rayshobby/opensprinkler/OpenSprinkler Pi/docs/v1.0/pics/pic_screw1.JPG

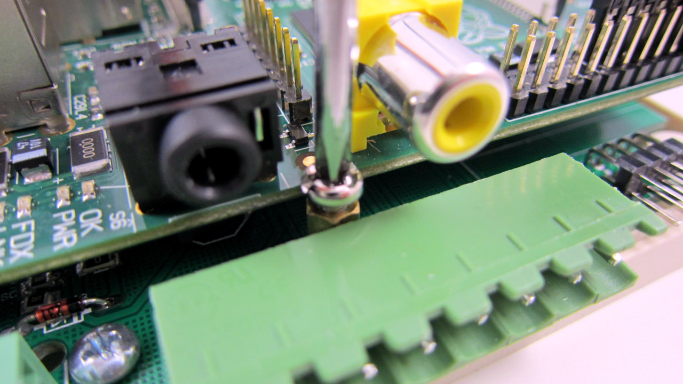
OpenSprinkler Pi/docs/v1.0/pics/pic_screw1.JPG
