rayshobby/opensprinkler/OpenSprinkler Pi/docs/v1.0/pics/pic_screw2.JPG

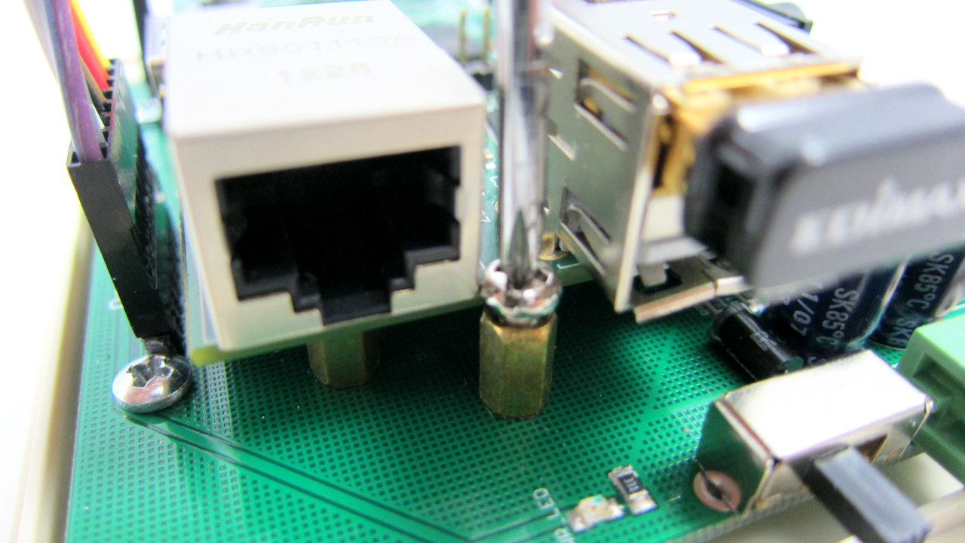
OpenSprinkler Pi/docs/v1.0/pics/pic_screw2.JPG
