rayshobby/opensprinkler/OpenSprinkler Pi/docs/v1.0/diagram_connection.pdf

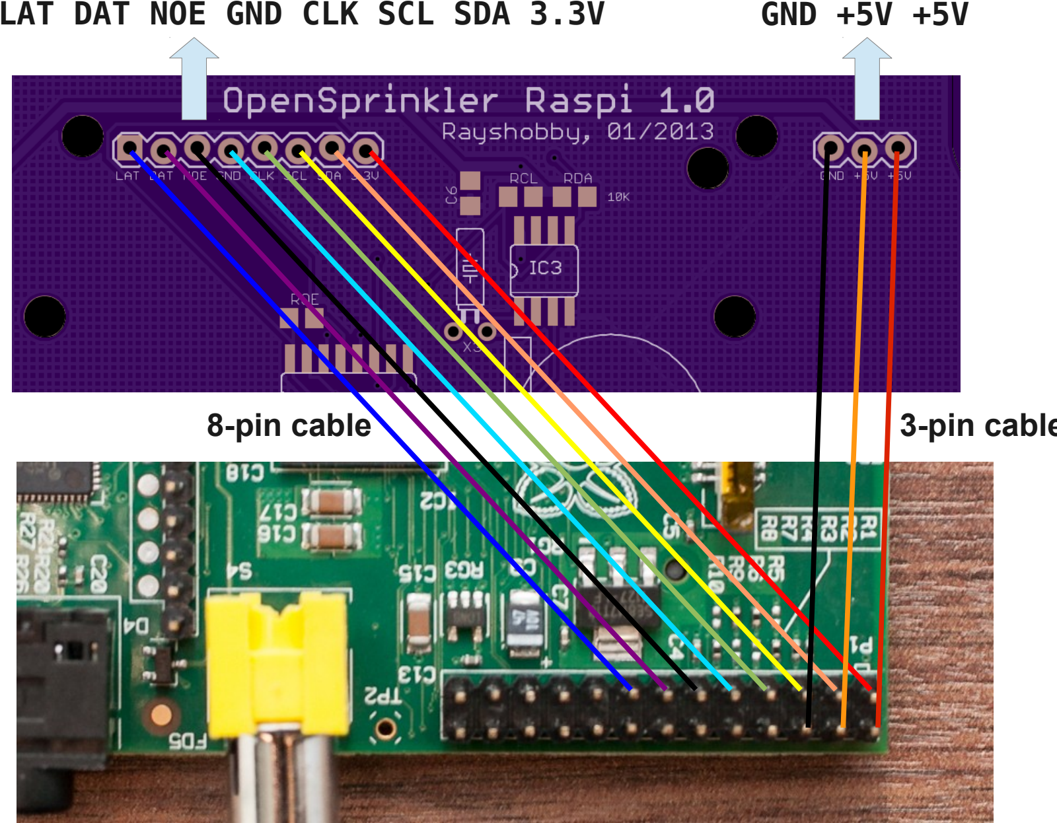
[picture p3: page 1]

LAT DAT NOE GND CLK SCL SDA 3.3V | GND +5V +5V
8-pin cable | 3-pin cable
