rayshobby/opensprinkler/OpenSprinkler Pi/docs/v1.0/diagram_interface.pdf

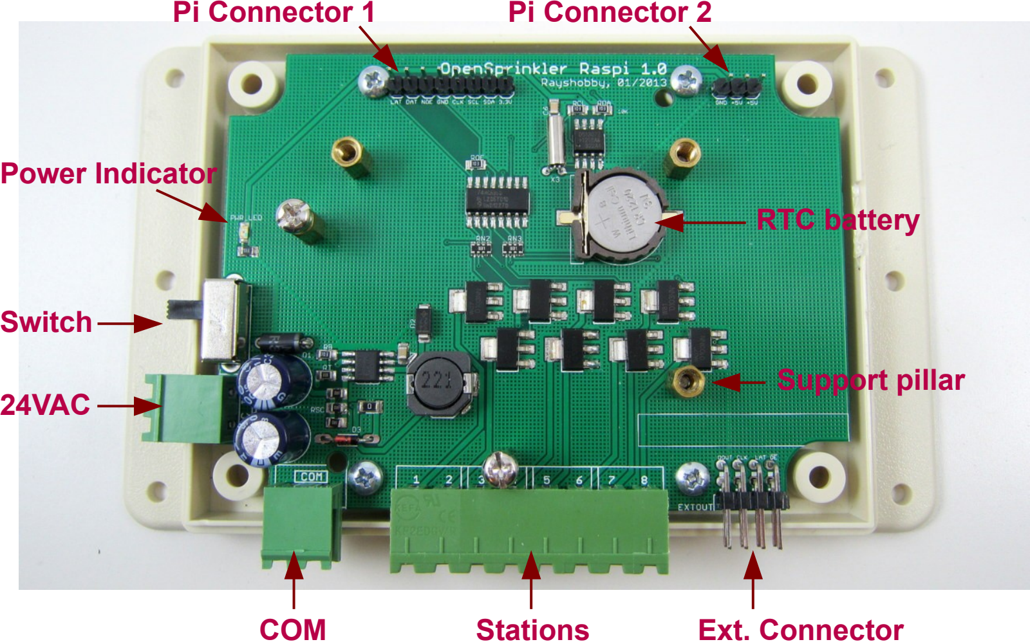
[picture p4: page 1]

24VAC

Switch

Power Indicator
RTC battery
COM | Stations | Ext. Connector
Pi Connector 1 | Pi Connector 2

Support pillar
