rayshobby/opensprinkler/OpenSprinkler Controller/hardware/v1.4/smt/Note.txt

Requires Eagle 6.0 or above to open attached .sch and .brd files.
