rayshobby/opensprinkler/Expansion Board/exp20.png

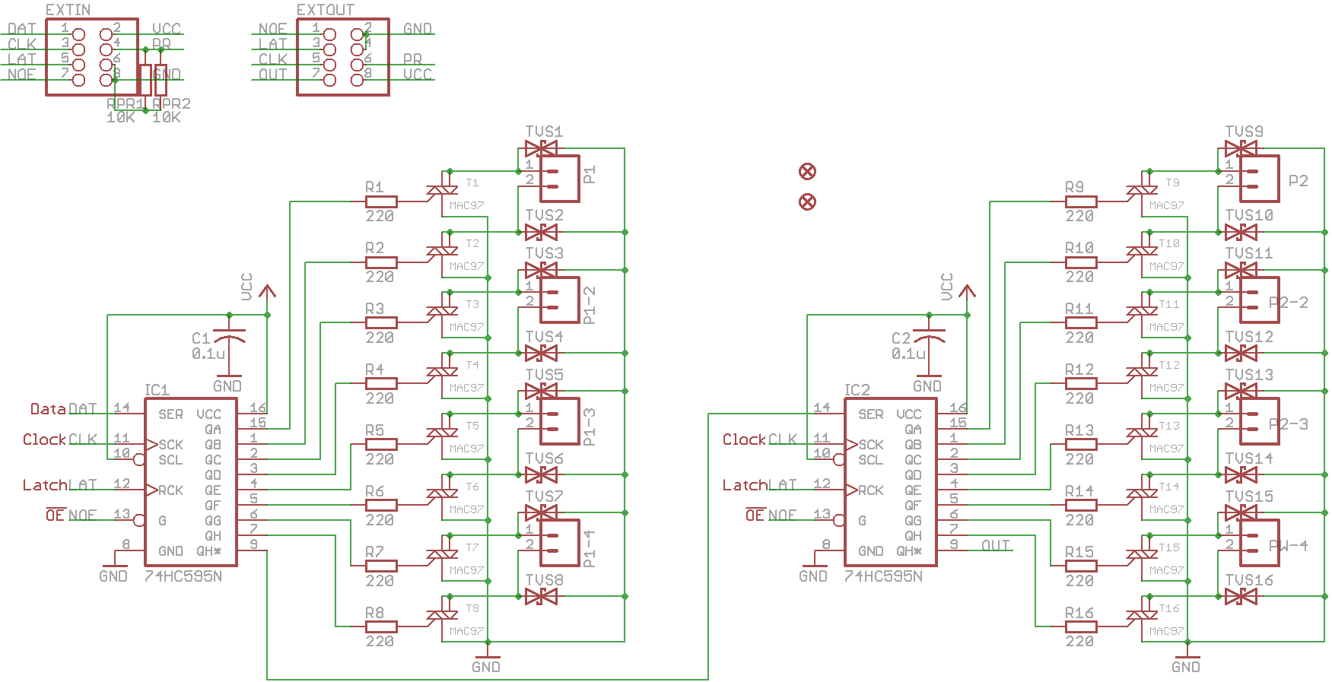
Expansion Board/exp20.png
