rayshobby/opensprinkler/OpenSprinkler Controller/hardware/v2.3/AC/os23ac_sch.png

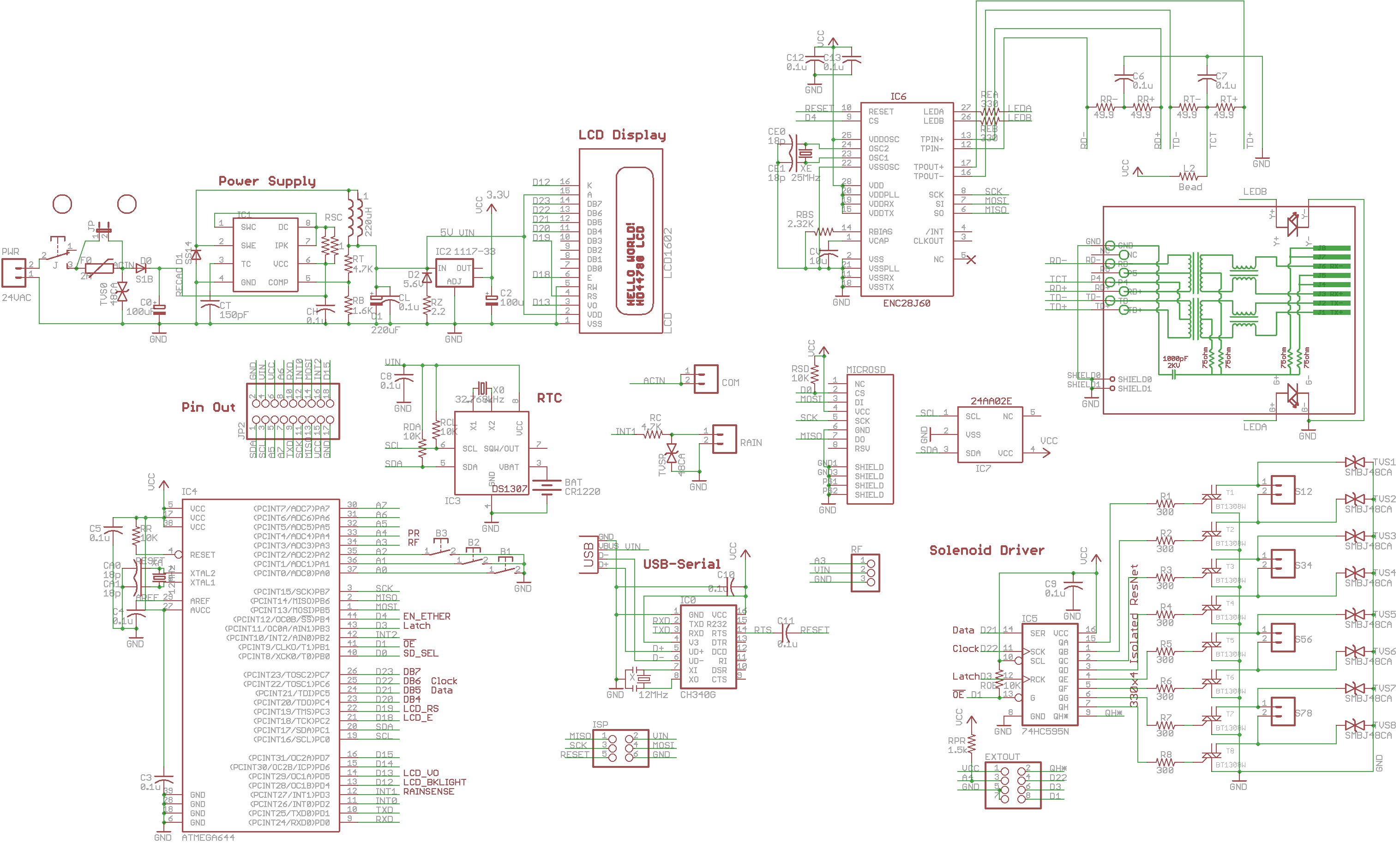
OpenSprinkler Controller/hardware/v2.3/AC/os23ac_sch.png
