rayshobby/opensprinkler/OpenSprinkler Controller/hardware/v2.3/DC/os23dc_sch.png

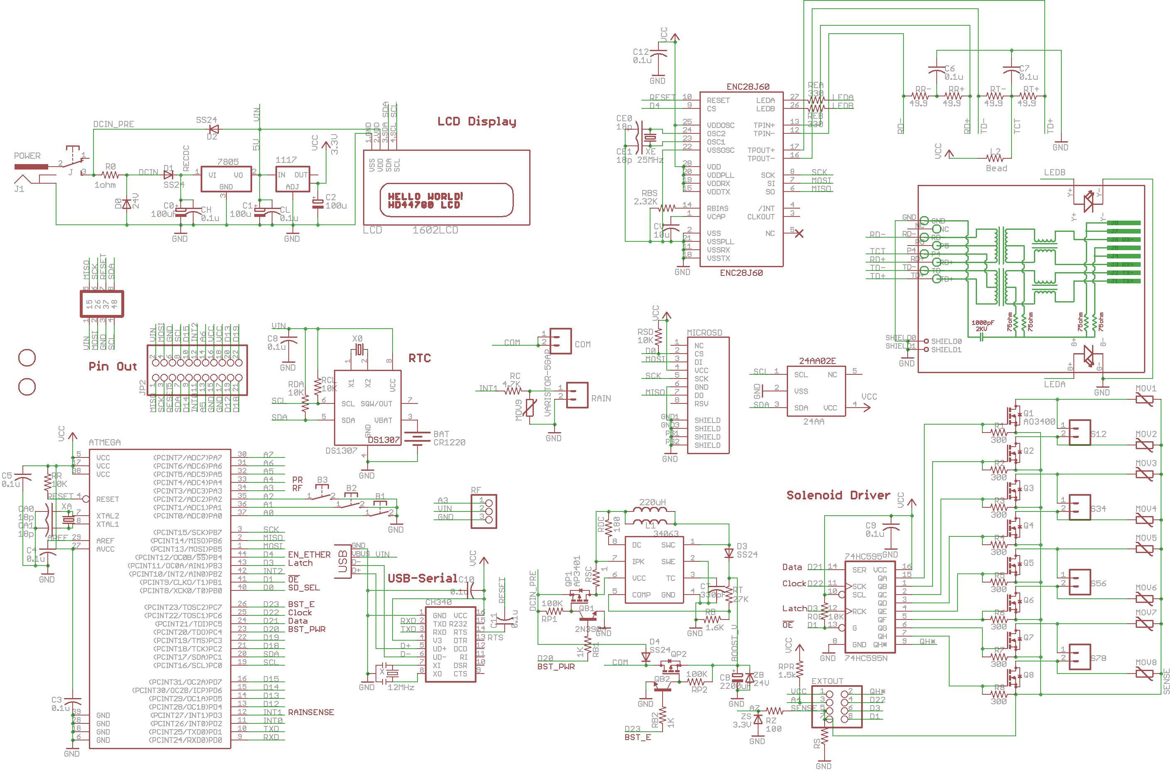
OpenSprinkler Controller/hardware/v2.3/DC/os23dc_sch.png
