rayshobby/opensprinkler/OpenSprinkler Pi/docs/v1.0/diagram_expansion_board.jpg

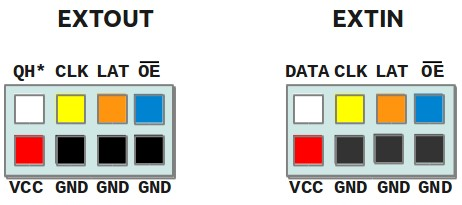
OpenSprinkler Pi/docs/v1.0/diagram_expansion_board.jpg
