rayshobby/opensprinkler/OpenSprinkler Pi/docs/v1.0/pics/pic_enclosure.JPG

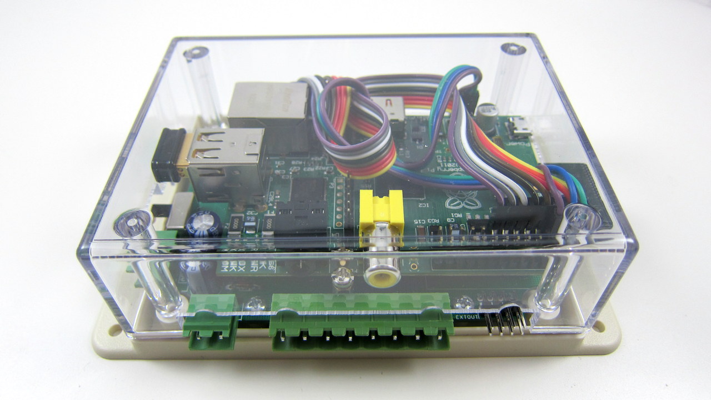
OpenSprinkler Pi/docs/v1.0/pics/pic_enclosure.JPG
