rayshobby/opensprinkler/OpenSprinkler Pi/docs/v1.0/pics/pic_extconn.JPG

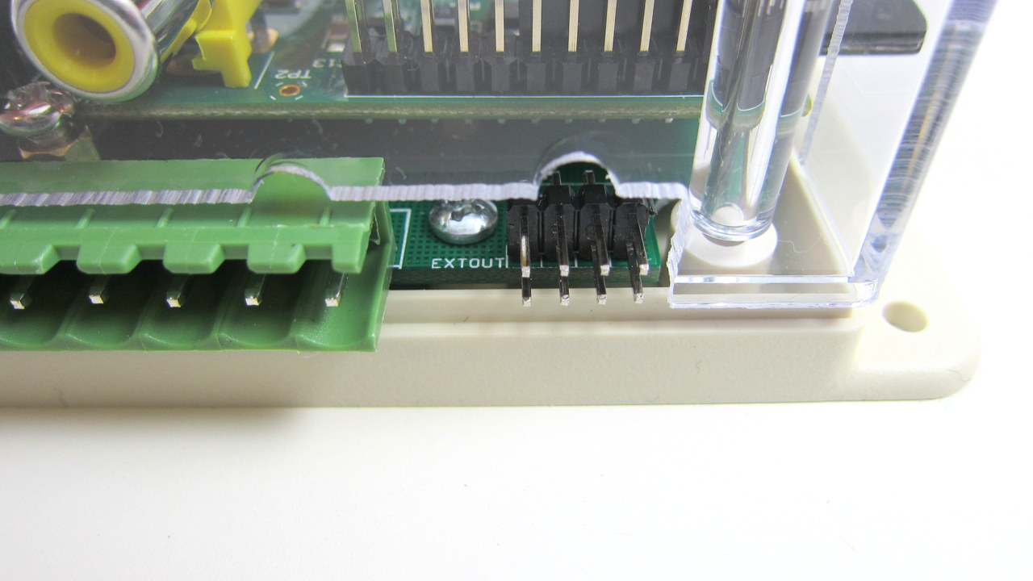
OpenSprinkler Pi/docs/v1.0/pics/pic_extconn.JPG
