rayshobby/opensprinkler/OpenSprinkler Pi/docs/v1.0/pics/pic_sdcard.JPG

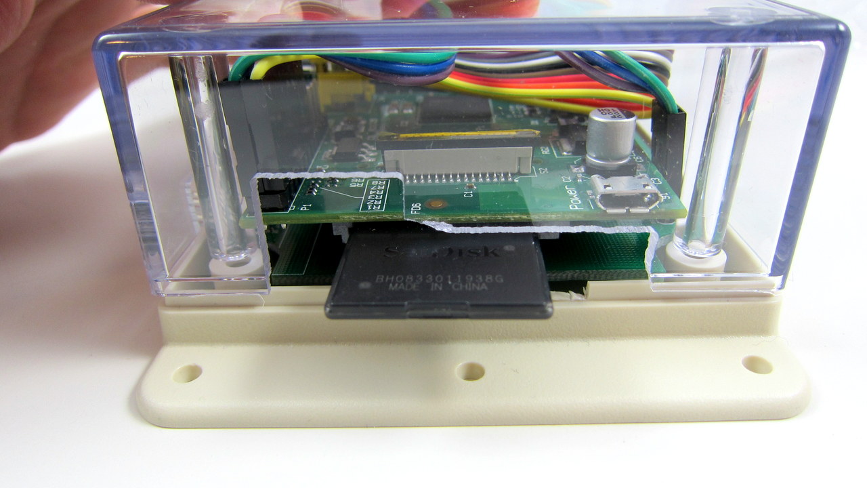
OpenSprinkler Pi/docs/v1.0/pics/pic_sdcard.JPG
