rayshobby/opensprinkler/OpenSprinkler Pi/docs/v1.0/pics/pic_solenoidwires.JPG

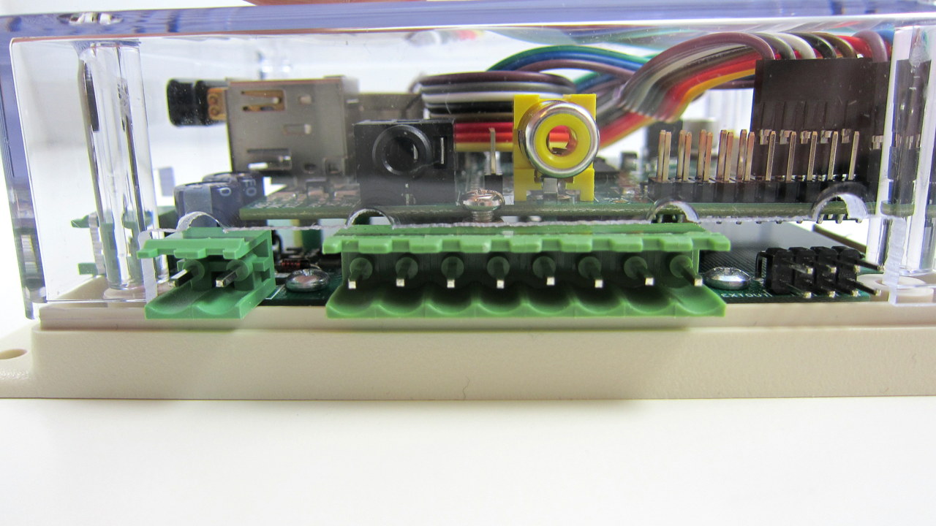
OpenSprinkler Pi/docs/v1.0/pics/pic_solenoidwires.JPG
