rayshobby/opensprinkler/OpenSprinkler Pi/docs/v1.0/pics/pic_supportpillar.JPG

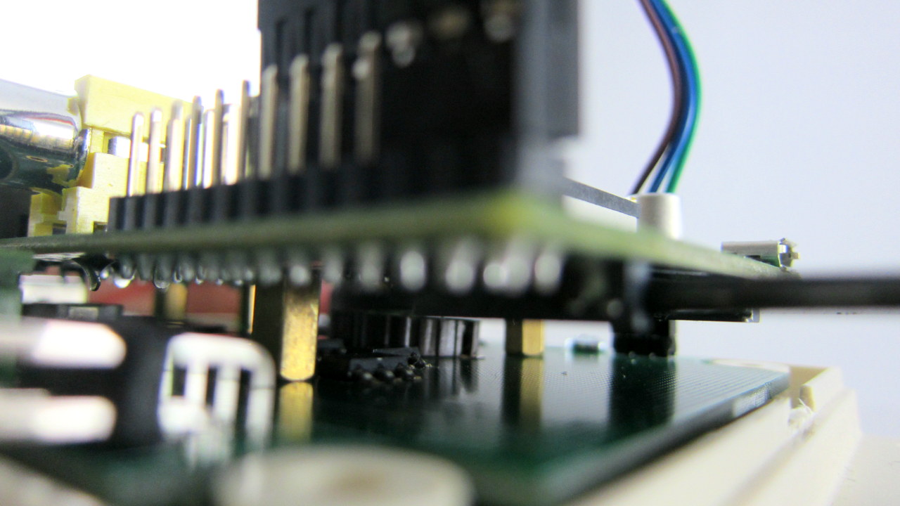
OpenSprinkler Pi/docs/v1.0/pics/pic_supportpillar.JPG
