rayshobby/opensprinkler/OpenSprinkler Pi/docs/v1.0/pics/pic_switch.JPG

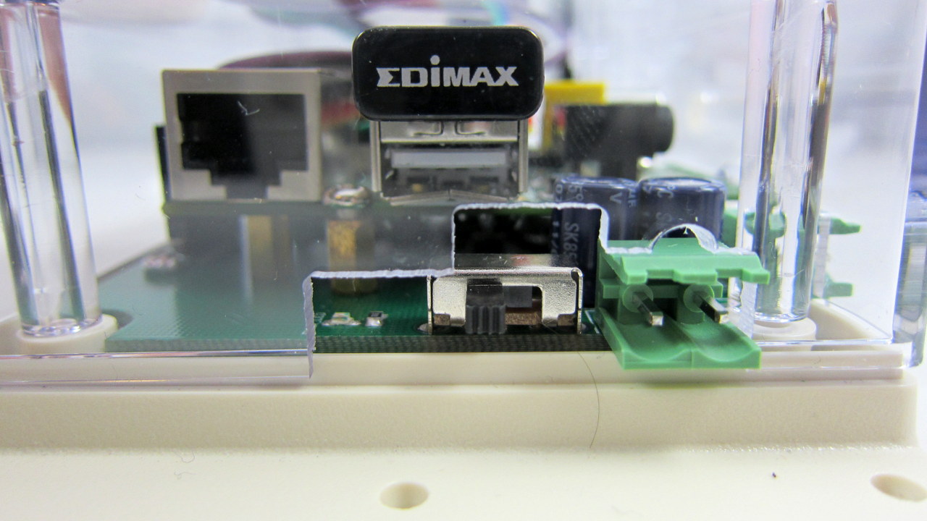
OpenSprinkler Pi/docs/v1.0/pics/pic_switch.JPG
