rayshobby/opensprinkler/OpenSprinkler Pi/docs/v1.0/pics/pic_viewback.JPG

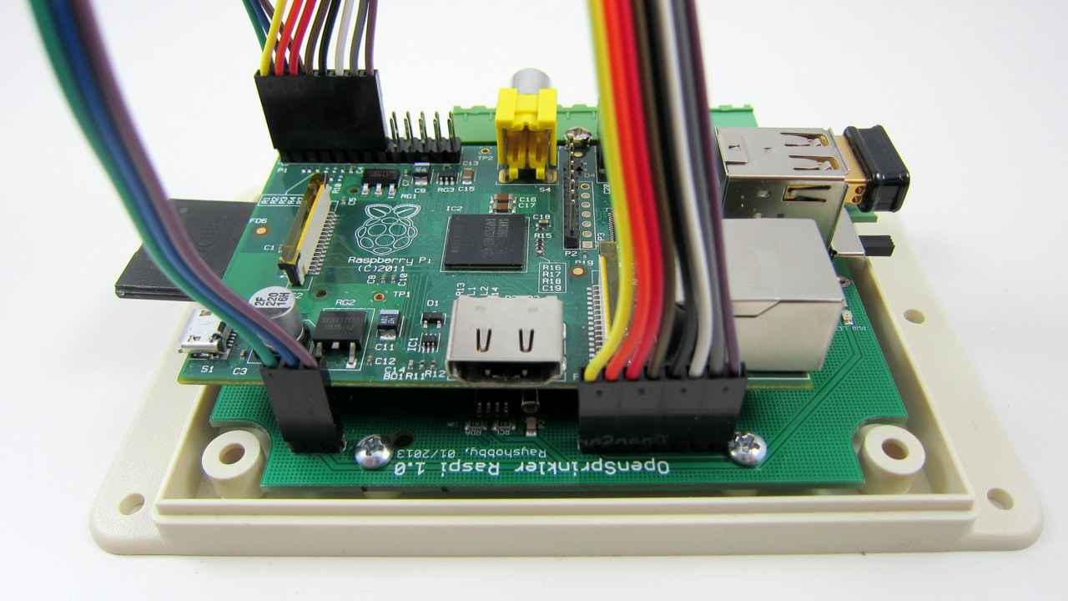
OpenSprinkler Pi/docs/v1.0/pics/pic_viewback.JPG
