rayshobby/opensprinkler/OpenSprinkler Pi/docs/v1.0/pics/pic_viewfront.JPG

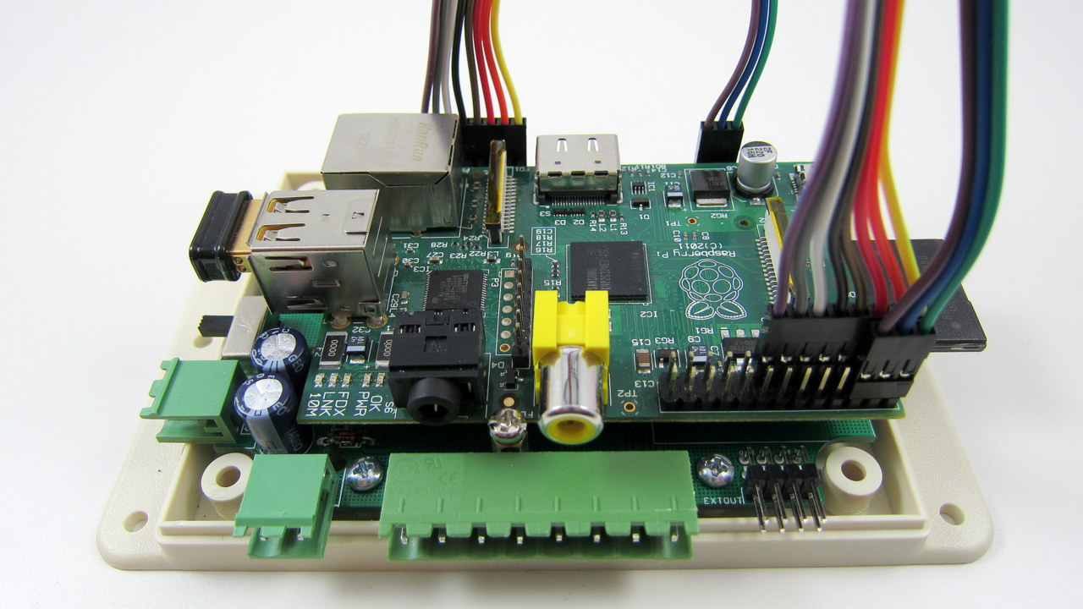
OpenSprinkler Pi/docs/v1.0/pics/pic_viewfront.JPG
