rayshobby/opensprinkler/OpenSprinkler Pi/docs/v1.0/pics/pic_wifidongle.JPG

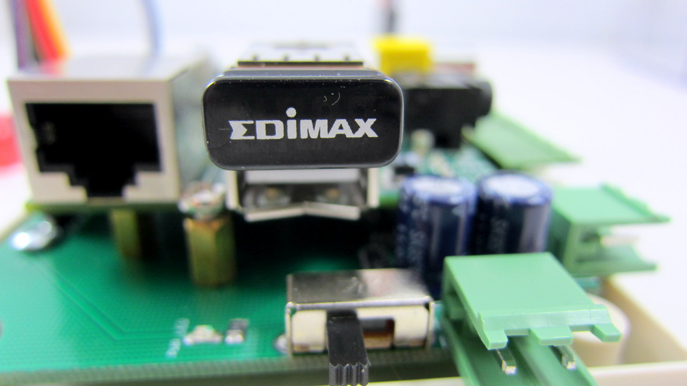
OpenSprinkler Pi/docs/v1.0/pics/pic_wifidongle.JPG
