rayshobby/opensprinkler/OpenSprinkler Pi/hardware/ospi_v10_sch.png

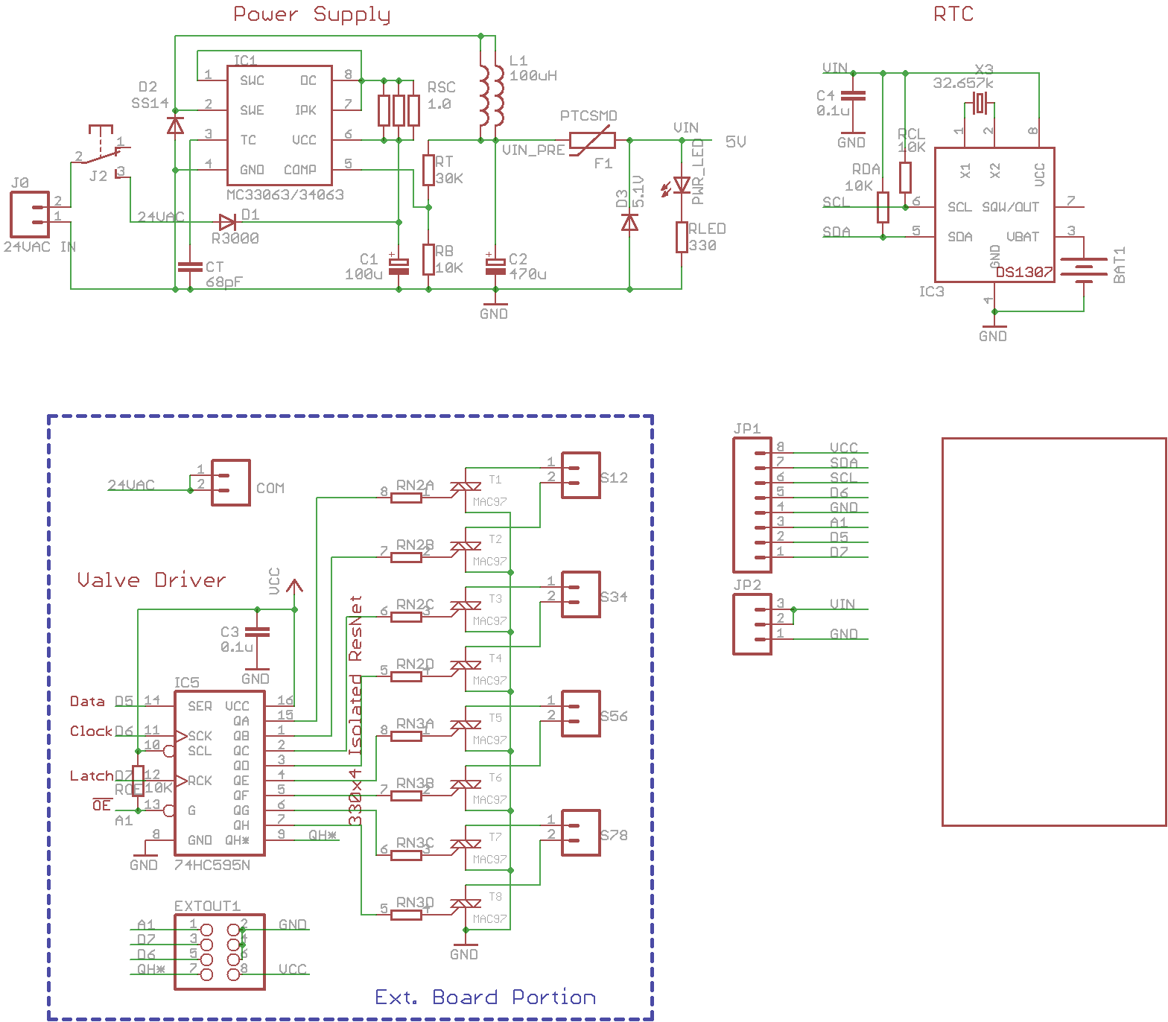
OpenSprinkler Pi/hardware/ospi_v10_sch.png
