rayshobby/opensprinkler/OpenSprinkler Pi/hardware/ospi_v11_sch.png

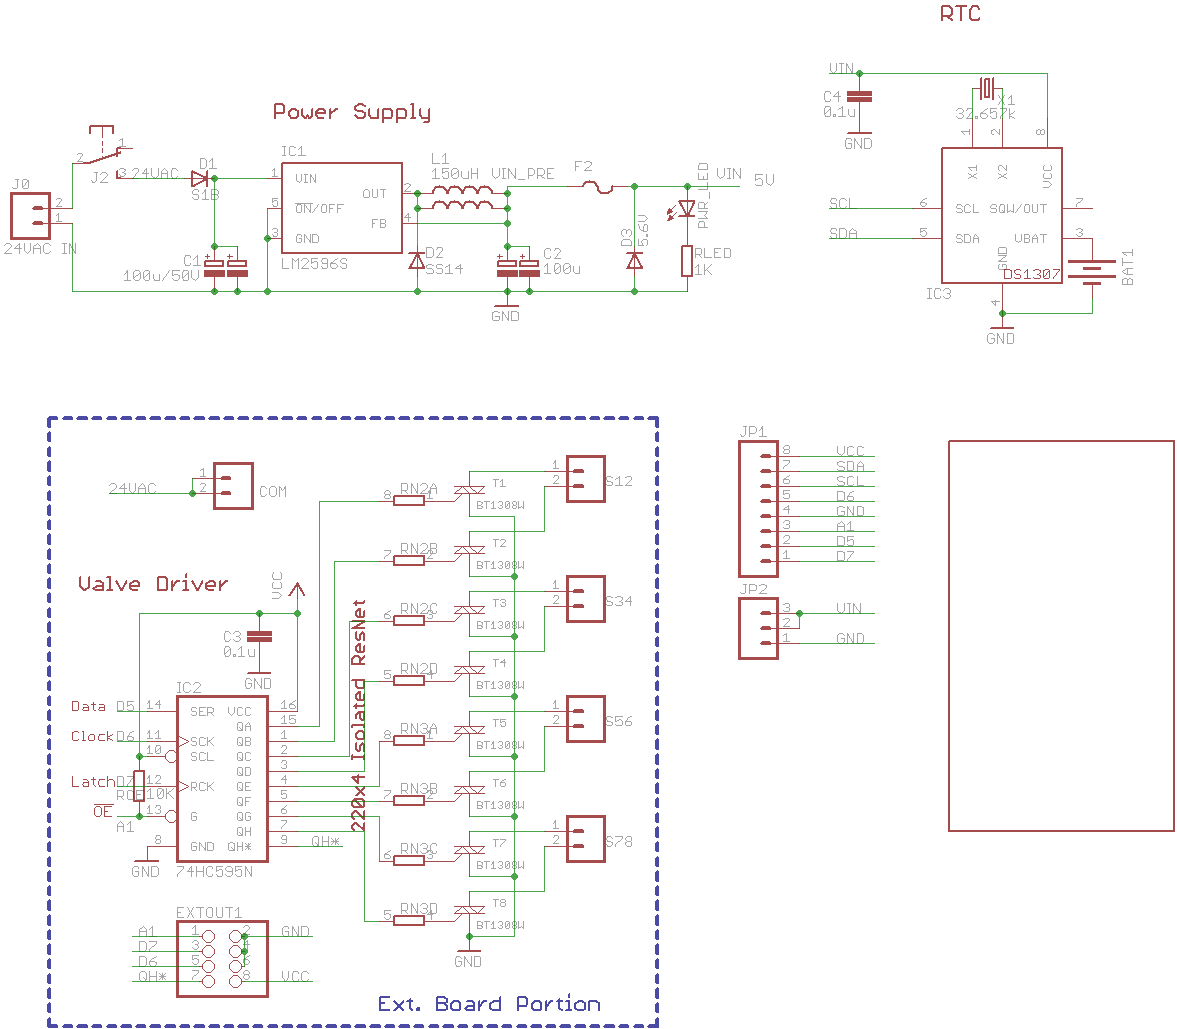
OpenSprinkler Pi/hardware/ospi_v11_sch.png
