rayshobby/opensprinkler/OpenSprinkler Pi/hardware/ospi_v12_sch.png

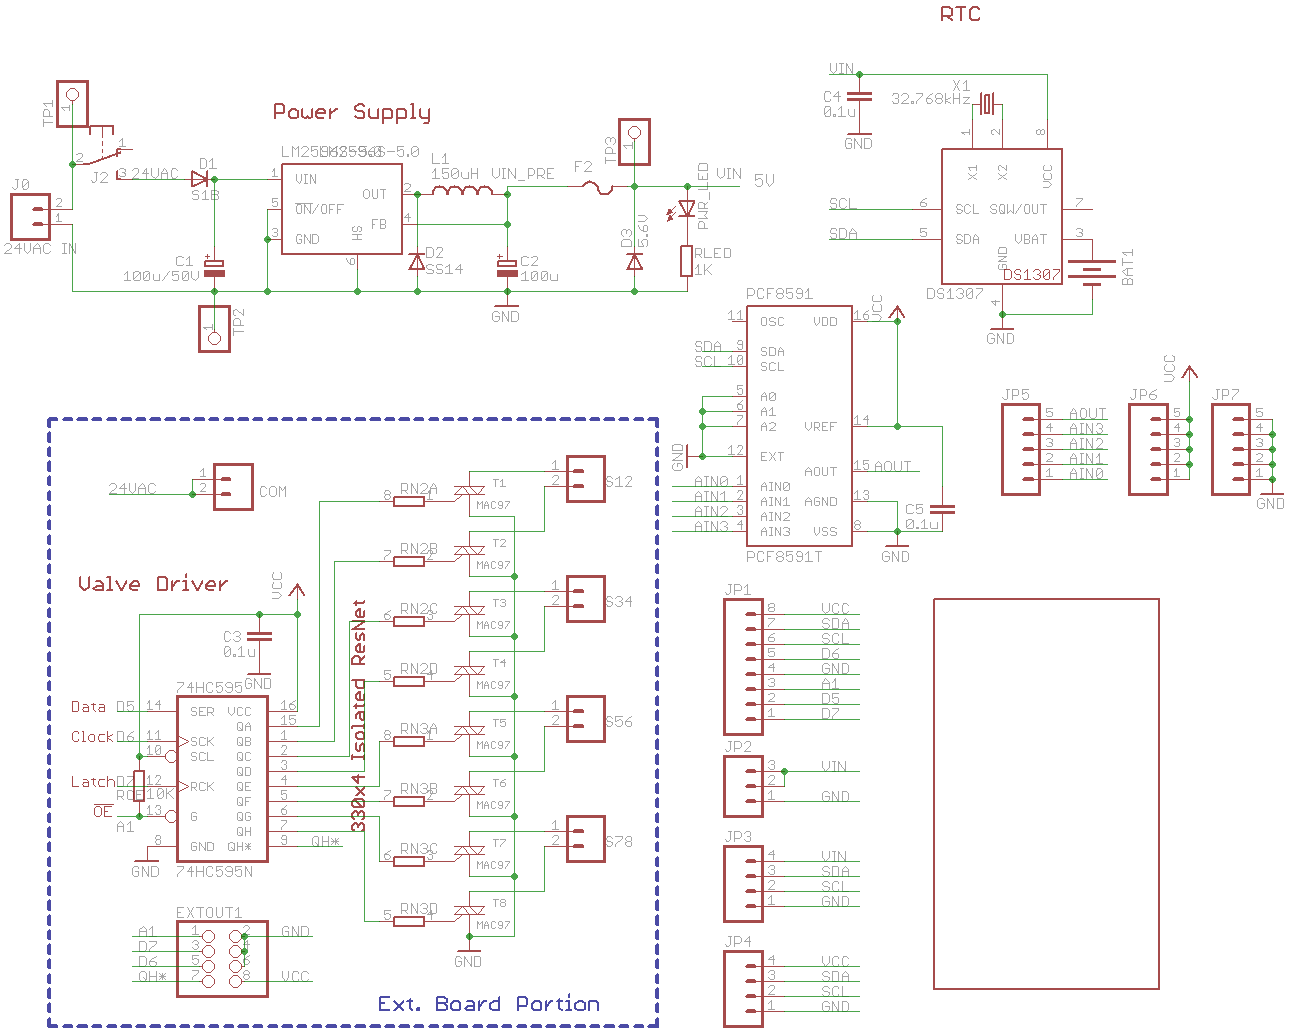
OpenSprinkler Pi/hardware/ospi_v12_sch.png
