rayshobby/opensprinkler/OpenSprinkler Pi/hardware/ospi_v13_sch.png

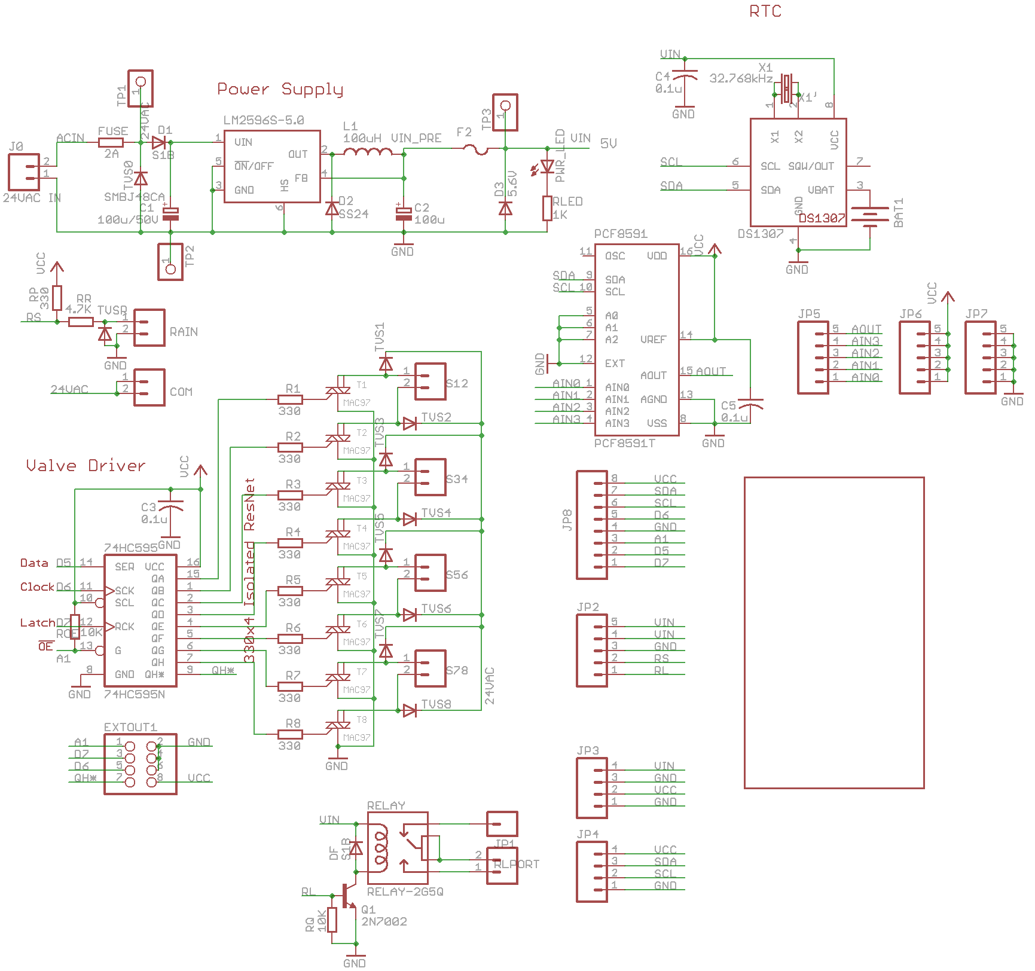
OpenSprinkler Pi/hardware/ospi_v13_sch.png
