rayshobby/opensprinkler/OpenSprinkler Pi/hardware/ospi_v14+_sch.png

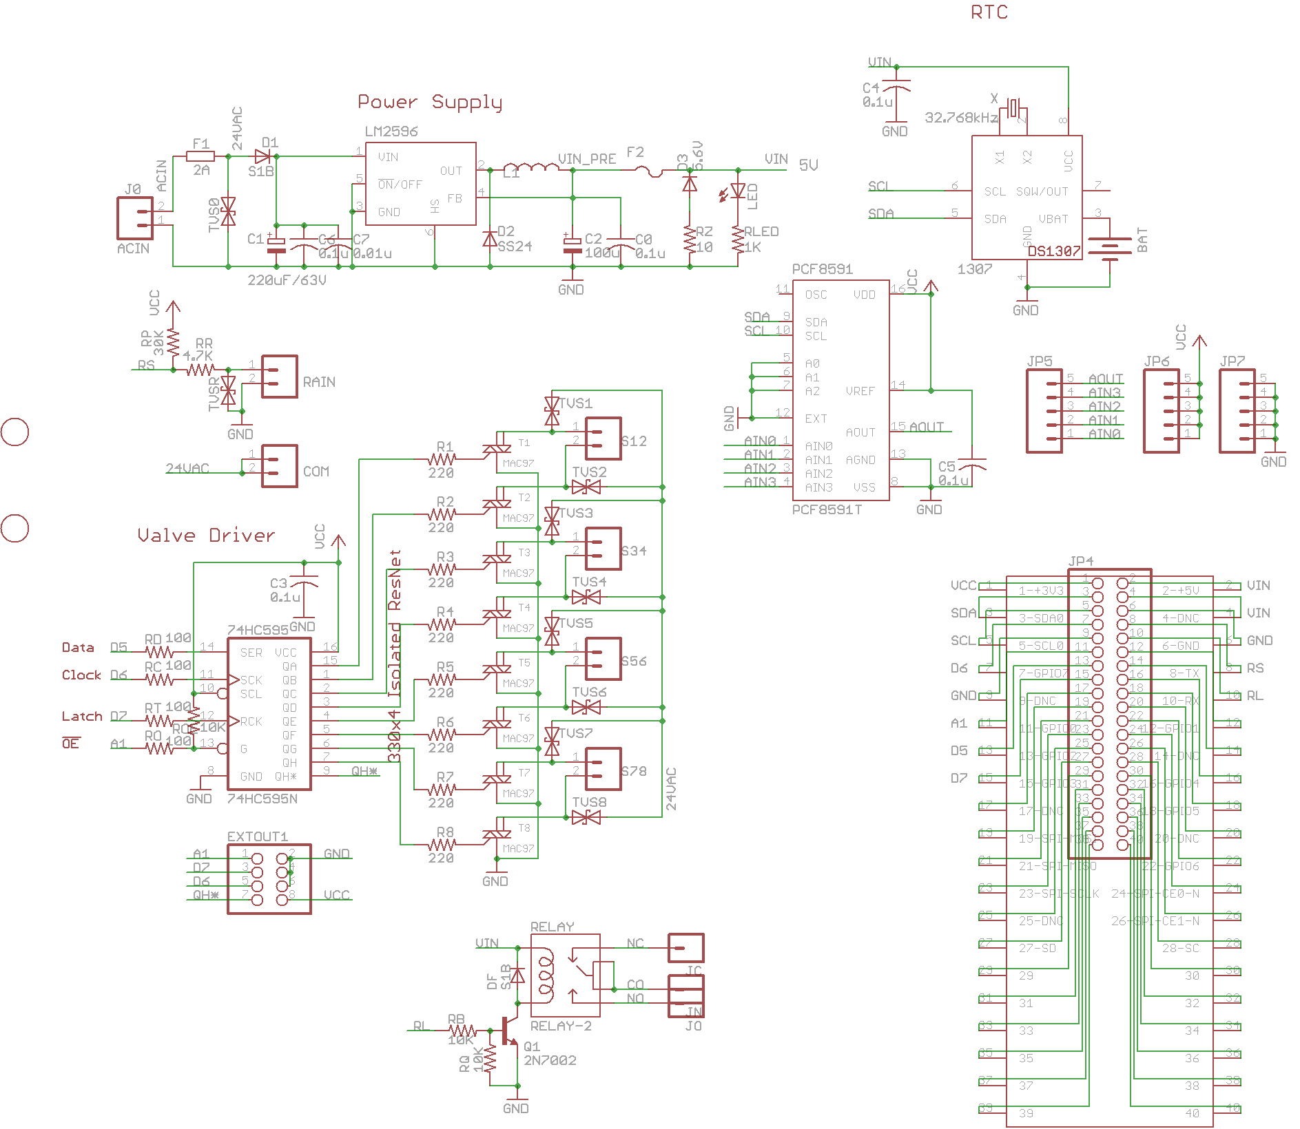
OpenSprinkler Pi/hardware/ospi_v14+_sch.png
