rayshobby/opensprinkler/OpenSprinkler Pi/hardware/ospi_v14_sch.png

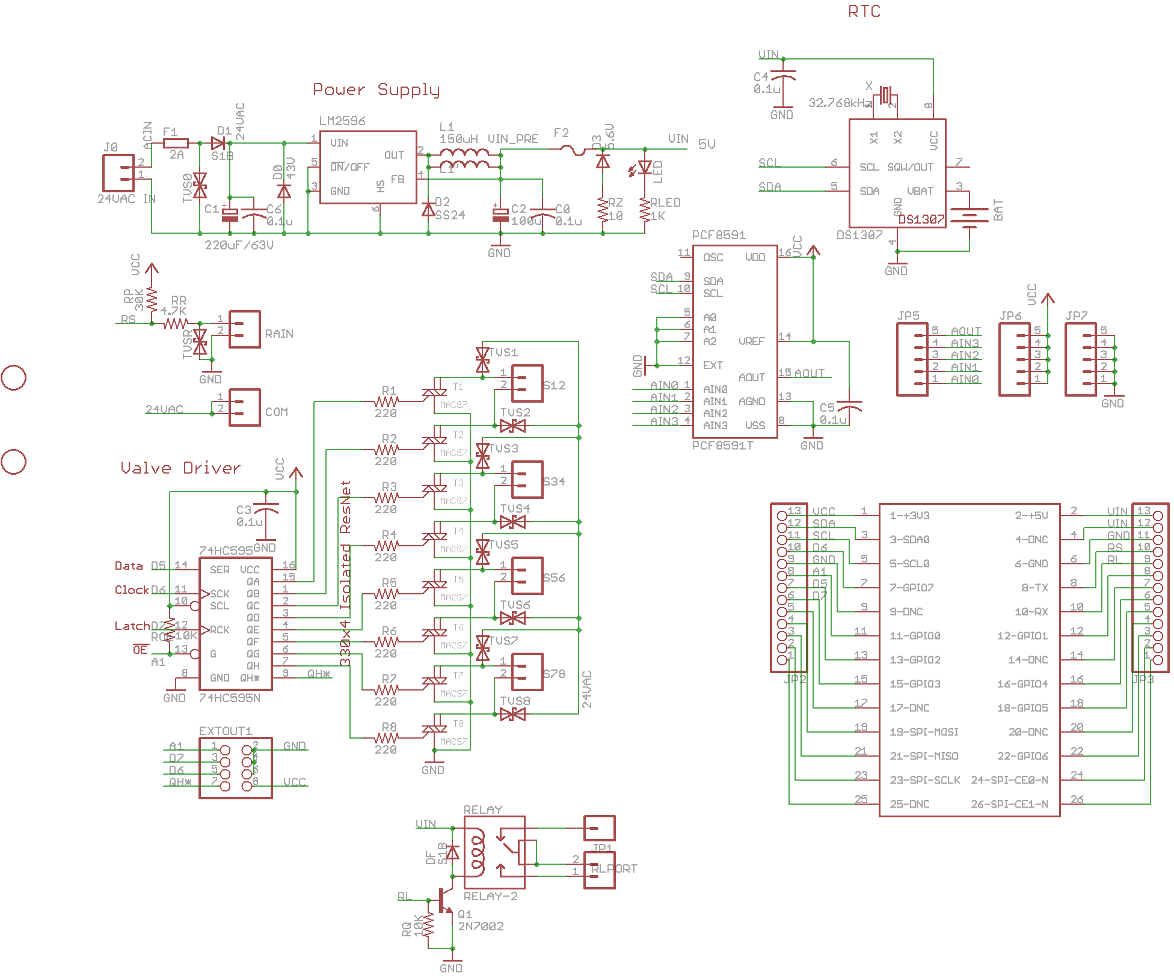
OpenSprinkler Pi/hardware/ospi_v14_sch.png
