rayshobby/opensprinkler/OpenSprinkler Pi/hardware/ospi_v142+.png

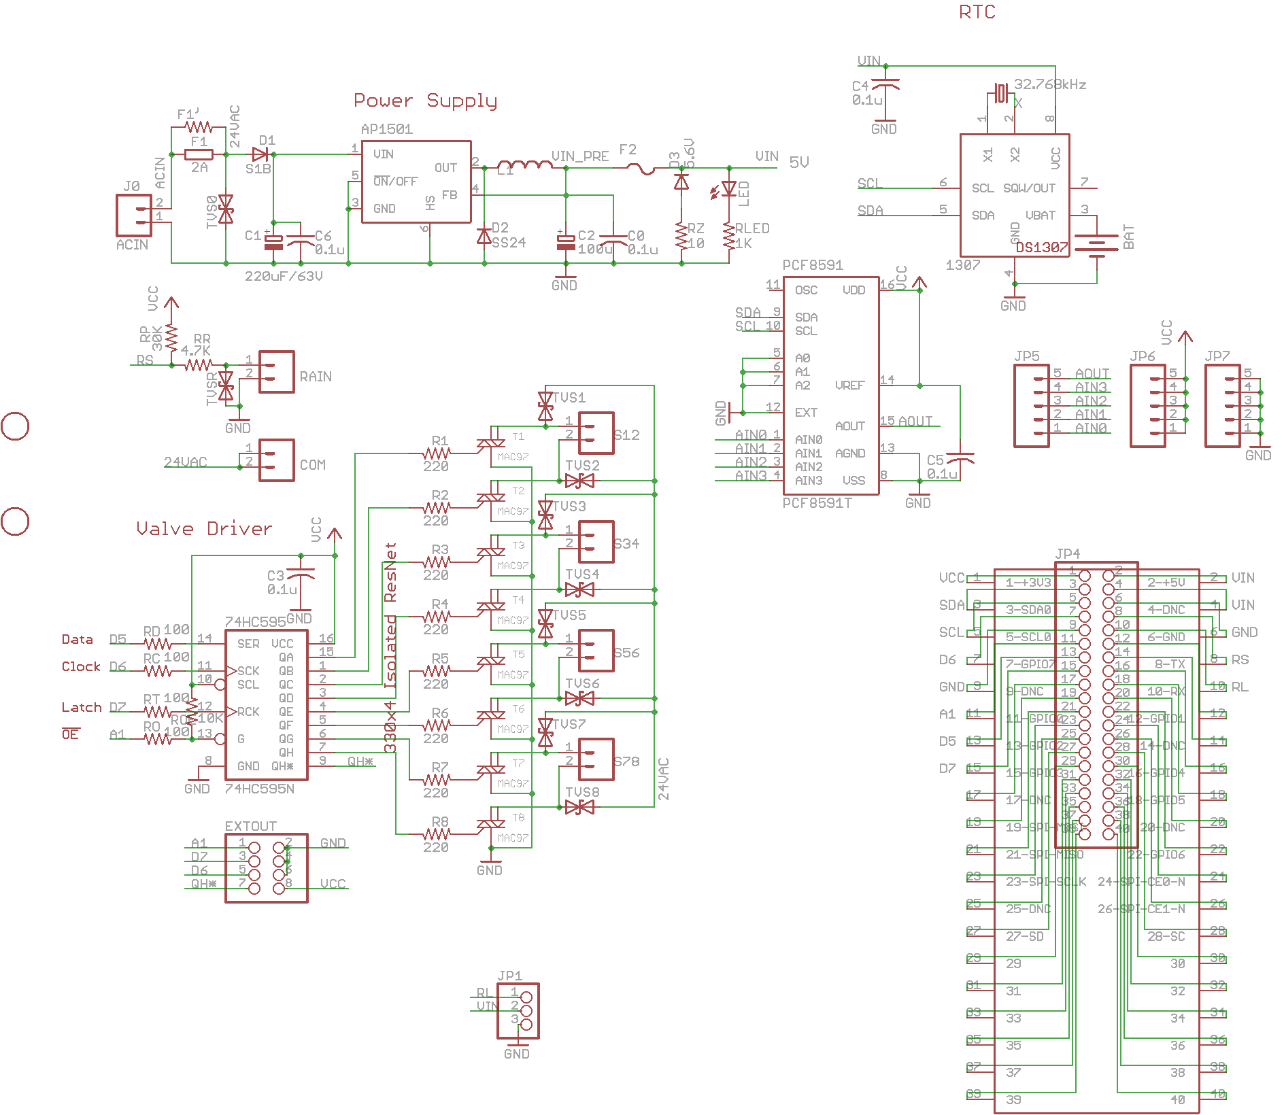
OpenSprinkler Pi/hardware/ospi_v142+.png
