rayshobby/opensprinkler/OpenSprinkler Pi/hardware/ospi_v143+.png

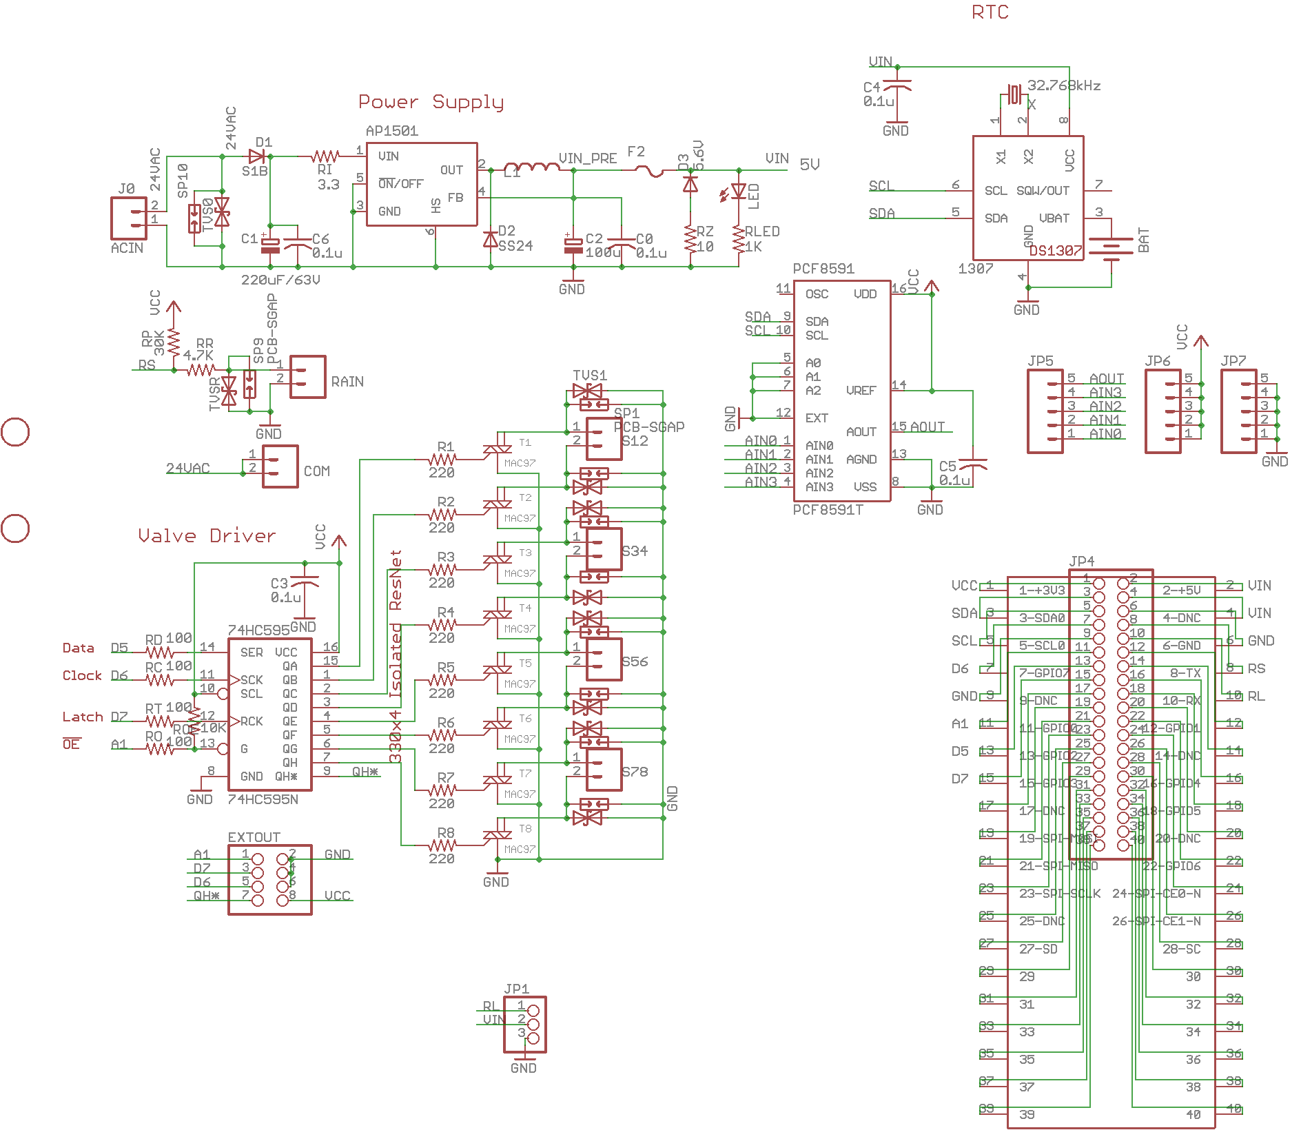
OpenSprinkler Pi/hardware/ospi_v143+.png
