rayshobby/opensprinkler/scripts/php/SprinklerLogger/Screen Shot of sprinkler log.png

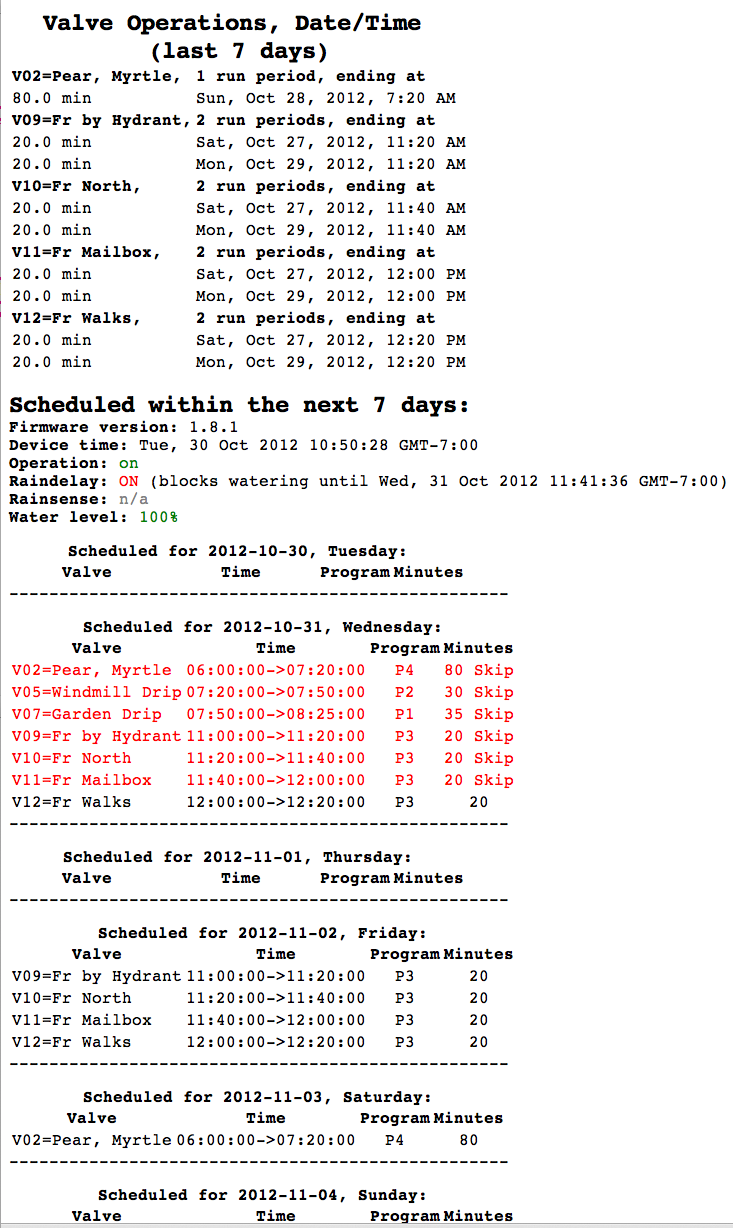
scripts/php/SprinklerLogger/Screen Shot of sprinkler log.png
