rayshobby/opensprinkler/(threads)

Thread 15 (2017-05-23):

Deal with small gaps in cell tracks

ChristofLitschko, 2017-05-23:
Possibilities to deal with small gaps (1-3 frames) in cell tracks due to inappropriate cell detection?

- Kalman filter ?

ChristofLitschko, 2017-05-23:
Sorry, was on the wrong page.

Closed 2017-05-23.

Thread 16 (2021-12-27):

Add support for ESP01 Relay Boards

GregFrost, 2021-12-27:
I have been able to get the OpenSprinkler firmware (with some modifications) to work on an ESP-01 controlled relay board like the one shown on this link:
[AliExpress Link](https://www.aliexpress.com/item/32963978306.html)
[Amazon Link](https://www.amazon.com.au/DollaTek-ESP8266-Channel-Cellphone-Control/dp/B07HC7SJK1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)

The trick with these boards is that the relay is controlled by sending a 4 byte binary code on the serial line 115200/8/n/1 from the ESP module (there is another non-reprogrammable MCU on the board that listens to the serial commands and controls the relays). e.g to turn on relay 1 on you send the 4 byte hex code a0, 01, 01, a2. To turn it off you send a0, 01, 00, a1 (so it looks like the first byte a0 is a delimiter, then the second byte is the relay number, the third is on or off, and the last byte is a checksum).

I have also found that I need to add a 20msec delay between controlling different relays for them to reliably switch.

There are many other boards like this, with differing numbers of relays (I have seen single channel relays and 2 channel relay boards).

I would love it if support for this type of board could be added to OpenSprinkler. I got mine working by hacking the switching logic for the RF station type in OpenSprinkler::switch_rfstation to send the appropriate serial command. To do it properly, you would have to add a new station type (perhaps named Serial Binary, or something like that), where you specified the binary sequence to send to turn the relay on and the sequence to turn it off. That would require updates to the ui code which is out of my league (hence I only co-opted the RF station type in my copy of the code).

PS: the forum seems to be broken, as that may have been a more appropriate place to post this, but whenever I am logged in, the forum links give me Page Not Found error, preventing me from being able to post.
