rayshobby/opensprinkler/OpenSprinkler Pi/hardware/ospi_v143+.brd

## EAGLE design OpenSprinkler Pi/hardware/ospi_v143+.brd (2016-11-06)

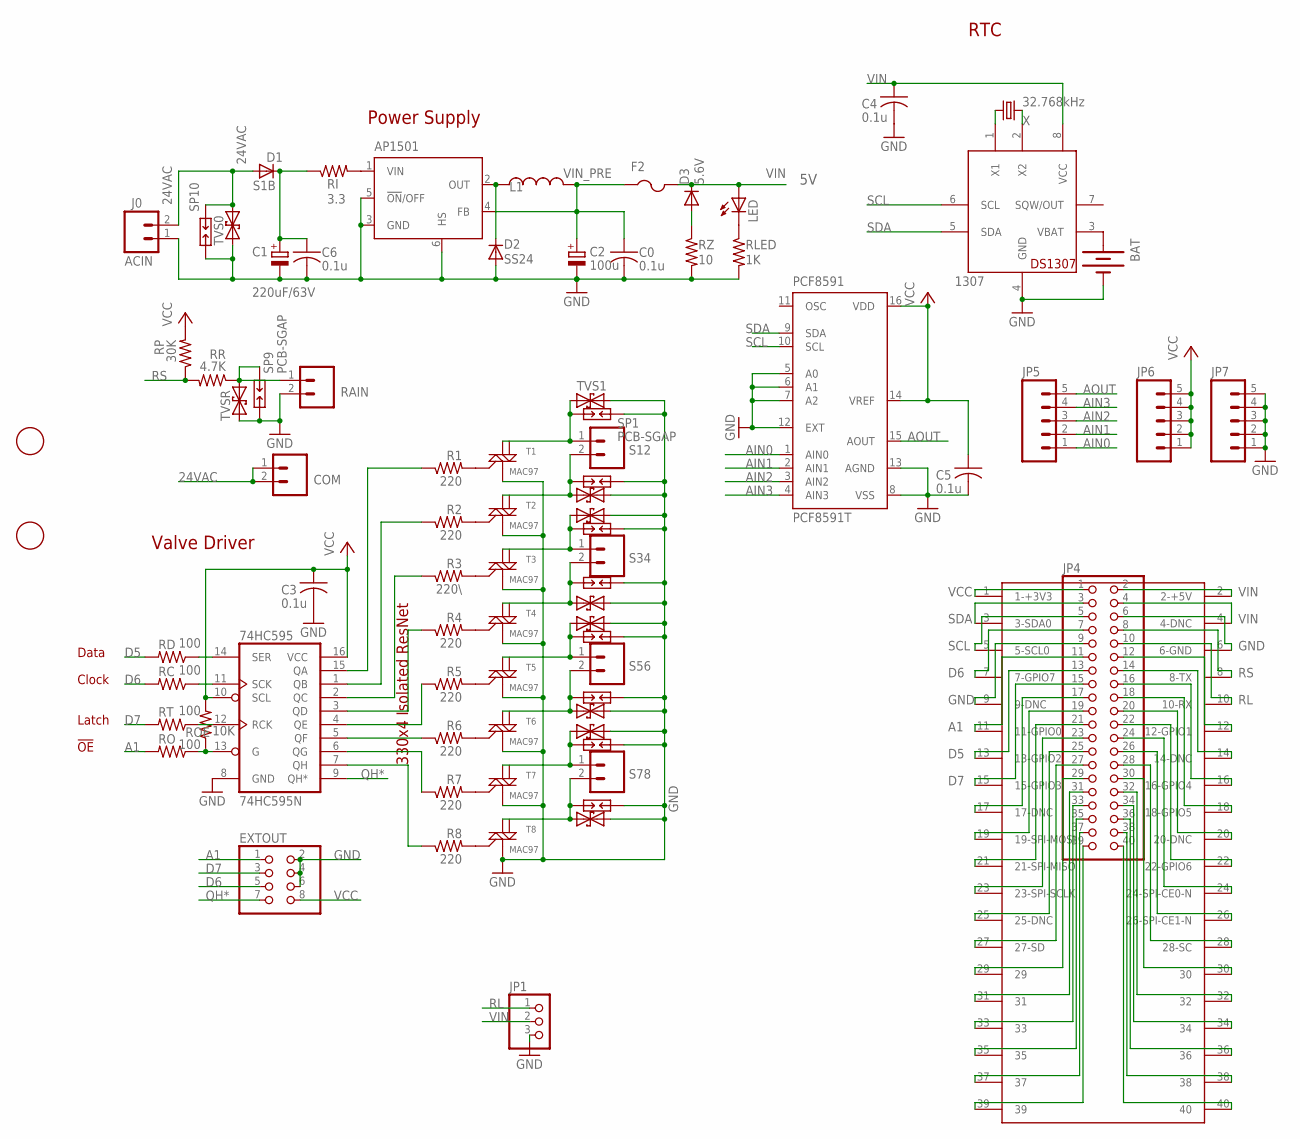
[picture p28: schematic ospi_v143+.sch]

Parts:
74HC595: 74HC595N; SO16
1307: DS1307; SO08
AP1501: LM2596S; TO263-5
BAT: BATTERYBATTERY_12MM_SMT; BATTCON_12MM_SMT
C0, C3, C4, C5, C6: 0.1u; C0603K
C1: 220uF/63V; PANASONIC_E
C2: 100u; PANASONIC_E
COM: M025MM-X; SCREWTERMINAL-5MM-2-X
D1: S1B; DO-214AC
D2: SS24; SMB
D3: 5.6V; MINIMELF
EXTOUT: PINHD-2X4/90; 2X04/90
F2: PTCFUSE-1812; 1812
J0: ACIN; SCREWTERMINAL-4MM-2-X
JP1: PINHD-1X3; 1X03
JP4: PINHD-2X20; 2X20
JP5, JP6, JP7: M05PTH; 1X05
L1: 150uH; CDRH125
LED: LEDCHIPLED_0805; CHIPLED_0805
PCF8591: PCF8591T; SO16W
R1, R2, R4, R5, R6, R7, R8: 220; R0603
R3: 220\; R0603
RAIN: M025MM-X; SCREWTERMINAL-5MM-2-X
RC: 100; R0603
RD: 100; R0603
RI: 3.3; R2010
RLED: 1K; R0805
RO: 100; R0603
ROE: 10K; R0603
RP: 30K; R0805
RR: 4.7K; R0805
RT: 100; R0603
RZ: 10; R2010
S12, S34, S56, S78: M025MM-X; SCREWTERMINAL-5MM-2-X
SP1, SP2, SP3, SP4, SP5, SP6, SP7, SP8, SP9, SP10: PCB-SGAP
T1, T2, T3, T4, T5, T6, T7, T8: MAC97; SOT223
TVS0, TVS1, TVS2, TVS3, TVS4, TVS5, TVS6, TVS7, TVS8: TVSSMB; SMB
TVSR: TVSSMB; SMB
U$1, U$3: FIDUCIAL; FIDUCIAL_1MM
U$2: RPIB+
X: 32.768kHz; MM20SS

Connections:
24VAC: COM.1, COM.2, D1.A, J0.2, SP10.1, TVS0.C
A1: EXTOUT.1, JP4.11, RO.2, U$2.11 (11-GPIO0)
AIN0: JP5.1, PCF8591.1 (AIN0)
AIN1: JP5.2, PCF8591.2 (AIN1)
AIN2: JP5.3, PCF8591.3 (AIN2)
AIN3: JP5.4, PCF8591.4 (AIN3)
AOUT: JP5.5, PCF8591.15 (AOUT)
D5: JP4.13, RD.2, U$2.13 (13-GPIO2)
D6: EXTOUT.5, JP4.7, RC.2, U$2.7 (7-GPIO7)
D7: EXTOUT.3, JP4.15, RT.2, U$2.15 (15-GPIO3)
GND: 74HC595.8 (GND), 1307.4 (GND), AP1501.3 (GND), AP1501.5 (!ON!/OFF), AP1501.6 (HS), BAT.P$1 (-), C0.2, C1.-, C2.-, C3.2, C4.2, C5.2, C6.2, D2.A, EXTOUT.2, EXTOUT.4, EXTOUT.6, J0.1, JP1.3, JP4.6, JP4.9, JP7.1, JP7.2, JP7.3, JP7.4, JP7.5, PCF8591.5 (A0), PCF8591.6 (A1), PCF8591.7 (A2), PCF8591.8 (VSS), PCF8591.12 (EXT), PCF8591.13 (AGND), RAIN.2, RLED.2, RZ.2, SP1.1, SP2.1, SP3.1, SP4.1, SP5.1, SP6.1, SP7.1, SP8.1, SP9.2, SP10.2, T1.1 (M1), T2.1 (M1), T3.1 (M1), T4.1 (M1), T5.1 (M1), T6.1 (M1), T7.1 (M1), T8.1 (M1), TVS0.A, TVS1.C, TVS2.C, TVS3.C, TVS4.C, TVS5.C, TVS6.C, TVS7.C, TVS8.C, TVSR.A, U$2.6 (6-GND), U$2.9 (9-DNC)
unnamed: LED.C, RLED.1
unnamed: C1.+, C6.1, D1.C, RI.1
unnamed: R1.2, T1.3 (G)
unnamed: 74HC595.5 (QF), R6.1
unnamed: 74HC595.6 (QG), R7.1
unnamed: D3.A, RZ.1
unnamed: 74HC595.7 (QH), R8.1
unnamed: AP1501.2 (OUT), D2.C, L1.1
unnamed: 1307.2 (X2), X.4 (2)
unnamed: 74HC595.4 (QE), R5.1
unnamed: 74HC595.3 (QD), R4.1
unnamed: 74HC595.2 (QC), R3.1
unnamed: 74HC595.1 (QB), R2.1
unnamed: 74HC595.15 (QA), R1.1
unnamed: R2.2, T2.3 (G)
unnamed: S12.1, SP1.2, T1.2 (M2), TVS1.A
unnamed: S12.2, SP2.2, T2.2 (M2), TVS2.A
unnamed: S34.1, SP3.2, T3.2 (M2), TVS3.A
unnamed: R3.2, T3.3 (G)
unnamed: S34.2, SP4.2, T4.2 (M2), TVS4.A
unnamed: R4.2, T4.3 (G)
unnamed: S56.1, SP5.2, T5.2 (M2), TVS5.A
unnamed: S56.2, SP6.2, T6.2 (M2), TVS6.A
unnamed: S78.1, SP7.2, T7.2 (M2), TVS7.A
unnamed: S78.2, SP8.2, T8.2 (M2), TVS8.A
unnamed: R5.2, T5.3 (G)
unnamed: R6.2, T6.3 (G)
unnamed: R7.2, T7.3 (G)
unnamed: R8.2, T8.3 (G)
unnamed: 1307.1 (X1), X.1
unnamed: RAIN.1, RR.1, SP9.1, TVSR.C
unnamed: 74HC595.14 (SER), RD.1
unnamed: 74HC595.11 (SCK), RC.1
unnamed: 74HC595.12 (RCK), RT.1
unnamed: 1307.3 (VBAT), BAT.P$2 (+)
unnamed: JP4.12, U$2.12 (12-GPIO1)
unnamed: JP4.14, U$2.14 (14-DNC)
unnamed: JP4.16, U$2.16 (16-GPIO4)
unnamed: 74HC595.13 (G), RO.1, ROE.1
unnamed: JP4.23, U$2.23 (23-SPI-SCLK)
unnamed: JP4.25, U$2.25 (25-DNC)
unnamed: JP4.27, U$2.27 (27-SD)
unnamed: JP4.29, U$2.29
unnamed: JP4.39, U$2.39
unnamed: JP4.37, U$2.37
unnamed: JP4.17, U$2.17 (17-DNC)
unnamed: JP4.19, U$2.19 (19-SPI-MOSI)
unnamed: JP4.21, U$2.21 (21-SPI-MISO)
unnamed: JP4.35, U$2.35
unnamed: JP4.33, U$2.33
unnamed: JP4.31, U$2.31
unnamed: JP4.34, U$2.34
unnamed: JP4.36, U$2.36
unnamed: JP4.38, U$2.38
unnamed: JP4.40, U$2.40
unnamed: AP1501.1 (VIN), RI.2
unnamed: JP4.18, U$2.18 (18-GPIO5)
unnamed: JP4.20, U$2.20 (20-DNC)
unnamed: JP4.22, U$2.22 (22-GPIO6)
unnamed: JP4.24, U$2.24 (24-SPI-CE0-N)
unnamed: JP4.26, U$2.26 (26-SPI-CE1-N)
unnamed: JP4.28, U$2.28 (28-SC)
unnamed: JP4.30, U$2.30
unnamed: JP4.32, U$2.32
QH*: 74HC595.9 (QH*), EXTOUT.7
RL: JP1.1, JP4.10, U$2.10 (10-RX)
RS: JP4.8, RP.1, RR.2, U$2.8 (8-TX)
SCL: 1307.6 (SCL), JP4.5, PCF8591.10 (SCL), U$2.5 (5-SCL0)
SDA: 1307.5 (SDA), JP4.3, PCF8591.9 (SDA), U$2.3 (3-SDA0)
VCC: 74HC595.10 (SCL), 74HC595.16 (VCC), C3.1, C5.1, EXTOUT.8, JP4.1, JP6.1, JP6.2, JP6.3, JP6.4, JP6.5, PCF8591.14 (VREF), PCF8591.16 (VDD), ROE.2, RP.2, U$2.1 (1-+3V3)
VIN: 1307.8 (VCC), C4.1, D3.C, F2.2, JP1.2, JP4.2, JP4.4, LED.A, U$2.2 (2-+5V), U$2.4 (4-DNC)
VIN_PRE: AP1501.4 (FB), C0.1, C2.+, F2.1, L1.2

Notes on the sheet:
Power Supply
Valve Driver
Data
Clock
Latch
330x4 Isolated ResNet
!OE
RTC

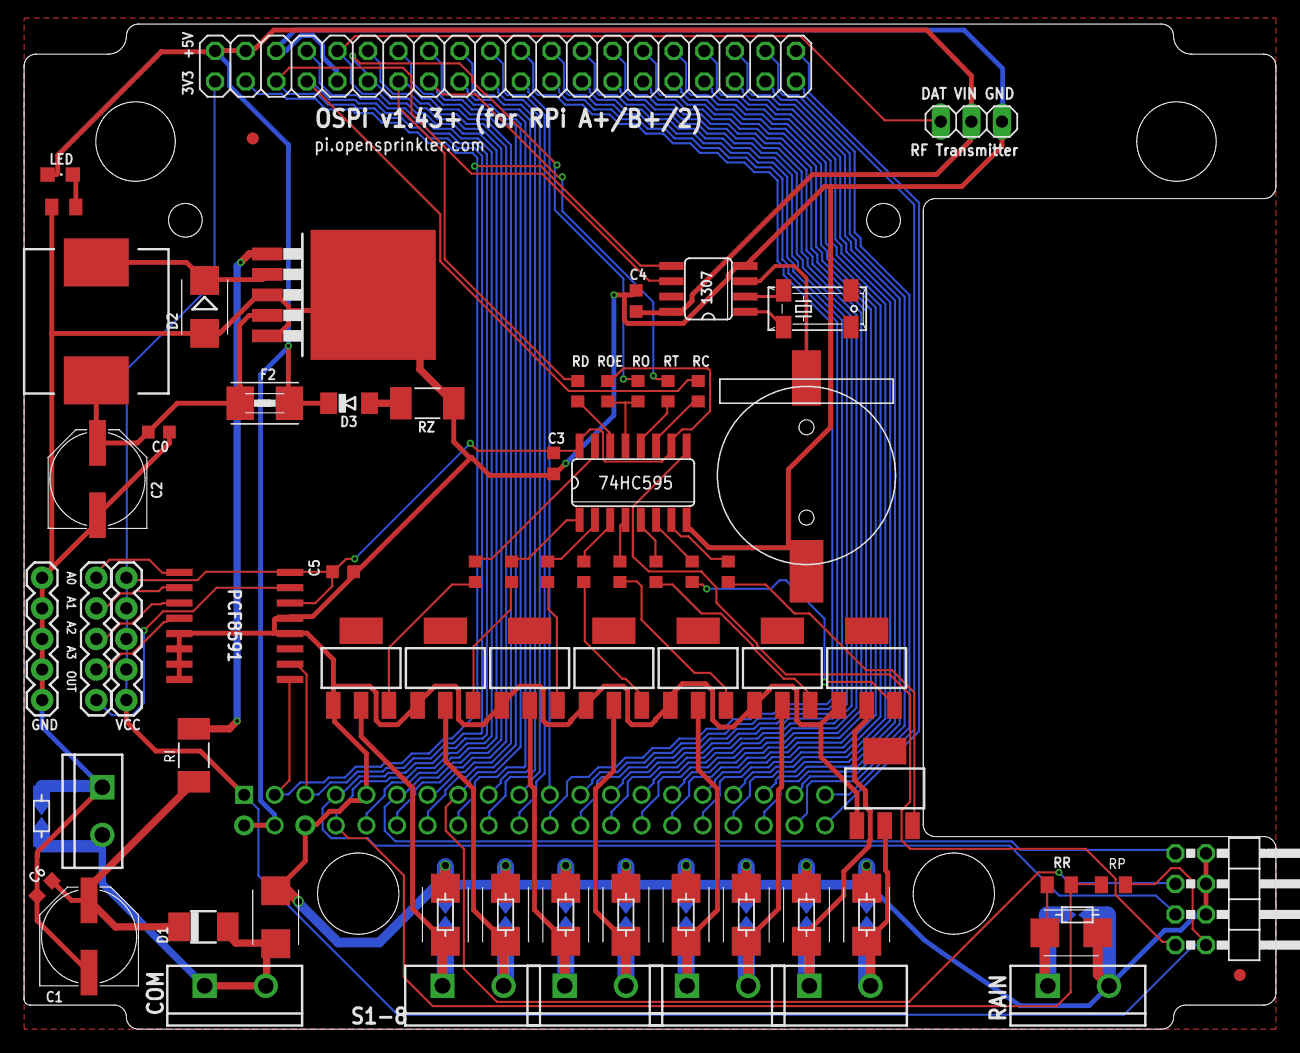
[picture p29: board ospi_v143+.brd from above]

Board: 2 copper layers, 104.0 x 83.5 mm, 81 parts (1 on the bottom side), 83 nets.
