rayshobby/opensprinkler/OpenSprinkler Controller/hardware/v2.3/DC/os23dc.brd

## EAGLE design OpenSprinkler Controller/hardware/v2.3/DC/os23dc.brd (2015-08-03)

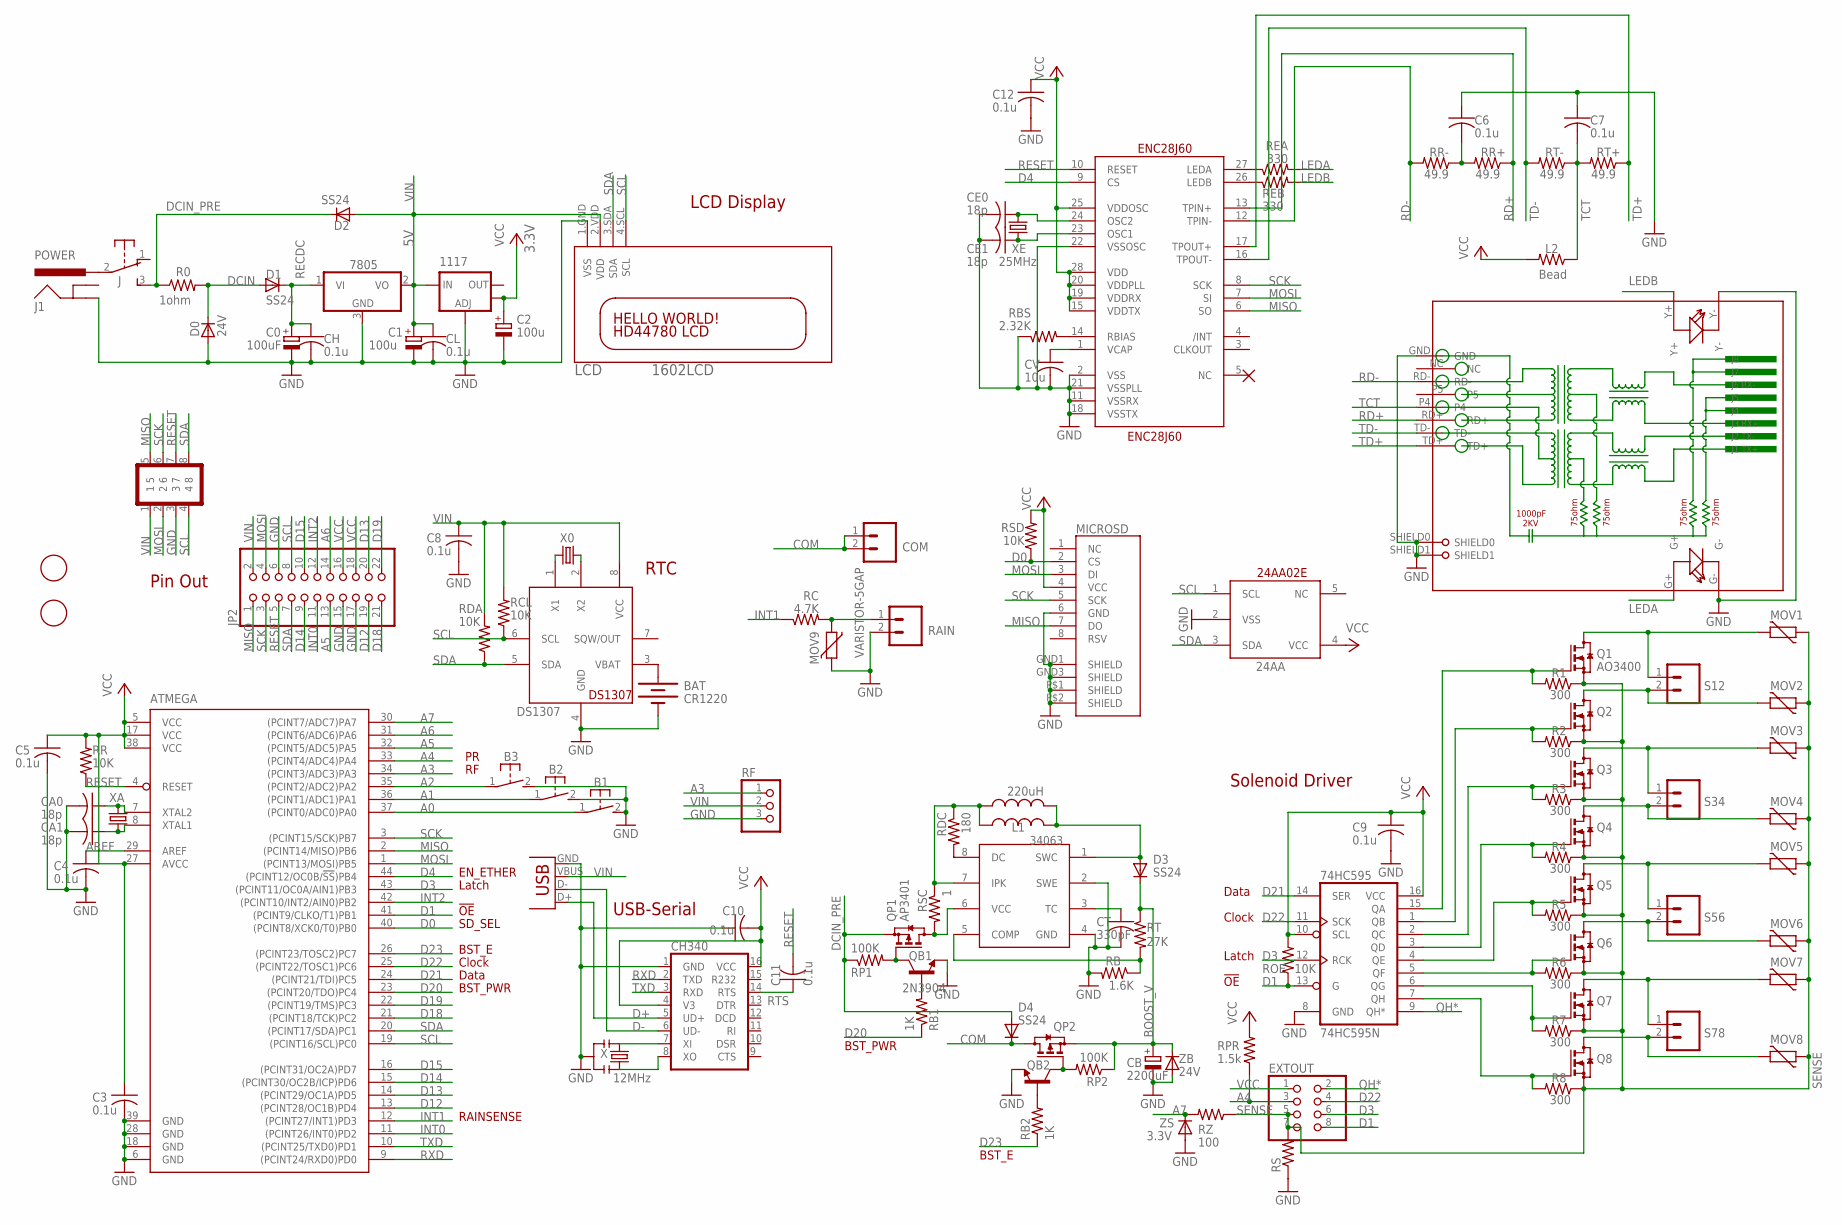
[picture p30: schematic os23dc.sch]

Parts:
24AA: 24AA02E48; SOT23-5L
74HC595: 74HC595N; SO16
1117: V_REG_LM1117SOT223; SOT223
7805: 7805DT; TO252
34063: MC33063/MC34063D; SO08
ATMEGA: ATMEGA644A; TQFP44
B1, B2, B3: 31-XX; B3F-31XX
BAT: CR1220; BATTCON_12MM_SMT
C0: 100uF; PANASONIC_E
C1, C2: 100u; PANASONIC_D
C3, C7: 0.1u; C0603K
C4, C5, C6, C8, C9, C10, C11, C12: 0.1u; C0603
CA0, CA1: 18p; C0603K
CB: 2200uF; E7,5-16
CE0, CE1: 18p; C0603K
CH: 0.1u; C0603
CH340: CH340G; SO16
CL: 0.1u; C0603
COM: M025MM-X; SCREWTERMINAL-5MM-2-X
CT: 330pF; C0603K
CV: 10u; C0805K
D0: 24V; MINIMELF
D1, D2, D3, D4: SS24; DO-214AC
DS1307: DS1307; SO08
ENC28J60: ENC28J60; SSOP28DB
EXTOUT: PINHD-2X4; 2X04
J: EG1206
J1: POWER; POWER_JACK_PTH_LOCK
JP2: PINHD-2X11; 2X11
L1: INDUCTORCR54; CR54
L1': 220uH; 0204/5
L2: Bead; R0805
LCD: 1602LCD; LCD1602-I2C-SIDE
MICROSD: USD-SOCKETMICRO-SD-SOCKET-TAOBAO; MICRO-SD-SOCKET-TAOBAO
MOV1, MOV2, MOV3, MOV4, MOV5, MOV6, MOV7, MOV8: 7D270K; R-5GAP
MOV9: VARISTOR-5GAP; R-5GAP
Q1: AO3400; SOT23
Q2, Q3, Q4, Q5, Q6, Q7, Q8: BSS123; SOT23
QB1: 2N3904; SOT23-3
QB2: TRANSISTOR_NPNSOT23-3; SOT23-3
QP1: AP3401; SOT23
QP2: BSS84; SOT23
R0: 1ohm; R2010
R1, R2, R3, R4, R5, R6, R7, R8: 300; R0603
RAIN: M025MM-X; SCREWTERMINAL-5MM-2-X
RB: 1.6K; R0603
RB1, RB2: 1K; R0603
RBS: 2.32K; R0805
RC: 4.7K; R0805
RCL: 10K; R0603
RDA: 10K; R0603
RDC: 180; R0603
REA: 330; R0603
REB: 330; R0603
RF: PINHD-1X3; 1X03
RJ45: HR911105A
ROE: 10K; R0603
RP1, RP2: 100K; R0603
RPR: 1.5k; R0603
RR: 10K; R0603
RR+: 49.9; R0603
RR-: 49.9; R0603
RS: R-US_R2512; R2512
RSC: 1; R0603
RSD: 10K; R0603
RT: 27K; R0603
RT+: 49.9; R0603
RT-: 49.9; R0603
RZ: 100; R0402
S12, S34, S56, S78: M025MM-X; SCREWTERMINAL-5MM-2-X
U$1, U$3: FIDUCIAL; FIDUCIAL_1MM
U$4: GOLDFINGER_2X4
USB: USBPTH; USB-B-PTH
X: 12MHz; RESONATOR-SMD
X0: 32.768kHz; MM20SS
XA: 12MHz; 4SMD
XE: 25MHz; 4SMD
ZB: 24V; MINIMELF
ZS: 3.3V; MINIMELF

Connections:
A0: ATMEGA.37 ((PCINT0/ADC0)PA0), B1.1
A1: ATMEGA.36 ((PCINT1/ADC1)PA1), B2.1
A2: ATMEGA.35 ((PCINT2/ADC2)PA2), B3.1
A3: ATMEGA.34 ((PCINT3/ADC3)PA3), RF.1
A4: ATMEGA.33 ((PCINT4/ADC4)PA4), EXTOUT.3, RPR.1
A5: ATMEGA.32 ((PCINT5/ADC5)PA5), JP2.13
A6: ATMEGA.31 ((PCINT6/ADC6)PA6), JP2.14
A7: ATMEGA.30 ((PCINT7/ADC7)PA7), RZ.2, ZS.C
AREF: ATMEGA.29 (AREF), C4.1
BOOST_V: CB.+, D3.C, QP2.2 (S), RP2.1, RT.1, ZB.C
COM: COM.1, COM.2, D4.C, QP2.3 (D)
D0: ATMEGA.40 ((PCINT8/XCK0/T0)PB0), MICROSD.2 (CS), RSD.1
D1: 74HC595.13 (G), ATMEGA.41 ((PCINT9/CLKO/T1)PB1), EXTOUT.8, ROE.1
D3: 74HC595.12 (RCK), ATMEGA.43 ((PCINT11/OC0A/AIN1)PB3), EXTOUT.6
D4: ATMEGA.44 ((PCINT12/OC0B/!SS!)PB4), ENC28J60.9 (CS)
D12: ATMEGA.13 ((PCINT28/OC1B)PD4), JP2.19
D13: ATMEGA.14 ((PCINT29/OC1A)PD5), JP2.20
D14: ATMEGA.15 ((PCINT30/OC2B/ICP)PD6), JP2.9
D15: ATMEGA.16 ((PCINT31/OC2A)PD7), JP2.10
D18: ATMEGA.21 ((PCINT18/TCK)PC2), JP2.21
D19: ATMEGA.22 ((PCINT19/TMS)PC3), JP2.22
D20: ATMEGA.23 ((PCINT20/TDO)PC4), RB1.1
D21: 74HC595.14 (SER), ATMEGA.24 ((PCINT21/TDI)PC5)
D22: 74HC595.11 (SCK), ATMEGA.25 ((PCINT22/TOSC1)PC6), EXTOUT.4
D23: ATMEGA.26 ((PCINT23/TOSC2)PC7), RB2.1
D+: CH340.5 (UD+), USB.D+
D-: CH340.6 (UD-), USB.D-
DCIN: D0.C, D1.A, R0.2
DCIN_PRE: D2.C, D4.A, J.3 (S), QP1.2 (S), R0.1, RP1.1
GND: 24AA.2 (VSS), 74HC595.8 (GND), 1117.1 (ADJ), 7805.3 (GND), 34063.2 (SWE), 34063.4 (GND), ATMEGA.6 (GND), ATMEGA.18 (GND), ATMEGA.28 (GND), ATMEGA.39 (GND), B1.2 (S), B2.2 (S), B3.2 (S), BAT.P$1 (-), C0.-, C1.-, C2.-, C3.2, C4.2, C5.2, C6.1, C7.1, C8.2, C9.2, C10.1, C12.2, CA0.2, CA1.2, CB.-, CE0.2, CE1.2, CH.2, CH340.1 (GND), CL.2, CT.2, CV.2, D0.A, DS1307.4 (GND), ENC28J60.2 (VSS), ENC28J60.11 (VSSRX), ENC28J60.18 (VSSTX), ENC28J60.21 (VSSPLL), ENC28J60.22 (VSSOSC), J1.GND, JP2.6, JP2.15, JP2.17, LCD.1.GND (VSS), MICROSD.6 (GND), MICROSD.GND1 (SHIELD), MICROSD.GND3 (SHIELD), MICROSD.P$1 (SHIELD), MICROSD.P$2 (SHIELD), MOV9.2, QB1.2 (E), QB2.2 (E), RAIN.2, RB.2, RBS.1, RF.3, RJ45.G-, RJ45.GND, RJ45.SHIELD0, RJ45.SHIELD1, RJ45.Y-, RS.1, U$4.3, USB.GND, X.2, ZB.A, ZS.A
INT0: ATMEGA.11 ((PCINT26/INT0)PD2), JP2.11
INT1: ATMEGA.12 ((PCINT27/INT1)PD3), RC.1
INT2: ATMEGA.42 ((PCINT10/INT2/AIN0)PB2), JP2.12
LEDA: REA.2, RJ45.G+
LEDB: REB.2, RJ45.Y+
MISO: ATMEGA.2 ((PCINT14/MISO)PB6), ENC28J60.6 (SO), JP2.1, MICROSD.7 (DO), U$4.5
MOSI: ATMEGA.1 ((PCINT13/MOSI)PB5), ENC28J60.7 (SI), JP2.4, MICROSD.3 (DI), U$4.2
unnamed: J.2, J1.PWR
unnamed: QB1.3 (C), QP1.1 (G), RP1.2
unnamed: MOV9.1, RAIN.1, RC.2
unnamed: 74HC595.5 (QF), Q6.1 (G), R6.2
unnamed: 74HC595.6 (QG), Q7.1 (G), R7.2
unnamed: CH340.7 (XI), X.1
unnamed: 74HC595.7 (QH), Q8.1 (G), R8.2
unnamed: DS1307.1 (X1), X0.1
unnamed: 34063.1 (SWC), D3.A, L1.P$2 (2), L1'.2
unnamed: 74HC595.4 (QE), Q5.1 (G), R5.2
unnamed: 74HC595.3 (QD), Q4.1 (G), R4.2
unnamed: 74HC595.2 (QC), Q3.1 (G), R3.2
unnamed: 74HC595.1 (QB), Q2.1 (G), R2.2
unnamed: 74HC595.15 (QA), Q1.1 (G), R1.2
unnamed: ATMEGA.7 (XTAL2), CA0.1, XA.1
unnamed: MOV1.2, Q1.3 (D), S12.1
unnamed: MOV2.2, Q2.3 (D), S12.2
unnamed: MOV3.2, Q3.3 (D), S34.1
unnamed: ATMEGA.8 (XTAL1), CA1.1, XA.3 (2)
unnamed: MOV4.2, Q4.3 (D), S34.2
unnamed: MOV5.2, Q5.3 (D), S56.1
unnamed: MOV6.2, Q6.3 (D), S56.2
unnamed: MOV7.2, Q7.3 (D), S78.1
unnamed: MOV8.2, Q8.3 (D), S78.2
unnamed: 34063.7 (IPK), L1.P$1 (1), L1'.1, RDC.1, RSC.1
unnamed: 34063.6 (VCC), QP1.3 (D), RSC.2
unnamed: 34063.3 (TC), CT.1
unnamed: 34063.5 (COMP), RB.1, RT.2
unnamed: DS1307.2 (X2), X0.4 (2)
unnamed: 34063.8 (DC), RDC.2
unnamed: QB1.1 (B), RB1.2
unnamed: ENC28J60.27 (LEDA), REA.1
unnamed: BAT.P$2 (+), DS1307.3 (VBAT)
unnamed: ENC28J60.26 (LEDB), REB.1
unnamed: QB2.3 (C), QP2.1 (G), RP2.2
unnamed: CV.1, ENC28J60.1 (VCAP)
unnamed: CH340.8 (XO), X.3
unnamed: CE0.1, ENC28J60.24 (OSC2), XE.3 (2)
unnamed: CE1.1, ENC28J60.23 (OSC1), XE.1
unnamed: QB2.1 (B), RB2.2
unnamed: C6.2, RR+.2, RR-.1
unnamed: ENC28J60.14 (RBIAS), RBS.2
QH*: 74HC595.9 (QH*), EXTOUT.2
RD+: ENC28J60.13 (TPIN+), RJ45.RD+, RR+.1
RD-: ENC28J60.12 (TPIN-), RJ45.RD-, RR-.2
RECDC: 7805.1 (VI), C0.+, CH.1, D1.C
RESET: ATMEGA.4 (RESET), C11.2, ENC28J60.10 (RESET), JP2.5, RR.1, U$4.7
RTS: C11.1, CH340.14 (RTS)
RXD: ATMEGA.9 ((PCINT24/RXD0)PD0), CH340.2 (TXD)
SCK: ATMEGA.3 ((PCINT15/SCK)PB7), ENC28J60.8 (SCK), JP2.3, MICROSD.5 (SCK), U$4.6
SCL: 24AA.1 (SCL), ATMEGA.19 ((PCINT16/SCL)PC0), DS1307.6 (SCL), JP2.8, LCD.4.SCL (SCL), RCL.1, U$4.4
SDA: 24AA.3 (SDA), ATMEGA.20 ((PCINT17/SDA)PC1), DS1307.5 (SDA), JP2.7, LCD.3.SDA (SDA), RDA.1, U$4.8
SENSE: EXTOUT.5, EXTOUT.7, MOV1.1, MOV2.1, MOV3.1, MOV4.1, MOV5.1, MOV6.1, MOV7.1, MOV8.1, Q1.2 (S), Q2.2 (S), Q3.2 (S), Q4.2 (S), Q5.2 (S), Q6.2 (S), Q7.2 (S), Q8.2 (S), R1.1, R2.1, R3.1, R4.1, R5.1, R6.1, R7.1, R8.1, RS.2, RZ.1
TCT: C7.2, L2.1, RJ45.P4, RT+.2, RT-.1
TD+: ENC28J60.17 (TPOUT+), RJ45.TD+, RT+.1
TD-: ENC28J60.16 (TPOUT-), RJ45.TD-, RT-.2
TXD: ATMEGA.10 ((PCINT25/TXD0)PD1), CH340.3 (RXD)
VCC: 24AA.4 (VCC), 74HC595.10 (SCL), 74HC595.16 (VCC), 1117.4 (OUT), ATMEGA.5 (VCC), ATMEGA.17 (VCC), ATMEGA.27 (AVCC), ATMEGA.38 (VCC), C2.+, C3.1, C5.1, C9.1, C10.2, C12.1, CH340.4 (V3), CH340.16 (VCC), ENC28J60.15 (VDDTX), ENC28J60.19 (VDDRX), ENC28J60.20 (VDDPLL), ENC28J60.25 (VDDOSC), ENC28J60.28 (VDD), EXTOUT.1, JP2.16, JP2.18, L2.2, MICROSD.4 (VCC), ROE.2, RPR.2, RR.2, RSD.2
VIN: 1117.3 (IN), 7805.2 (VO), C1.+, C8.1, CL.1, D2.A, DS1307.8 (VCC), JP2.2, LCD.2.VDD (VDD), RCL.2, RDA.2, RF.2, U$4.1, USB.VBUS

Notes on the sheet:
Solenoid Driver
Data
Clock
Latch
EN_ETHER
3.3V
!OE
RAINSENSE
SD_SEL
USB-Serial
Pin Out
RTC
BST_E
BST_PWR
LCD Display

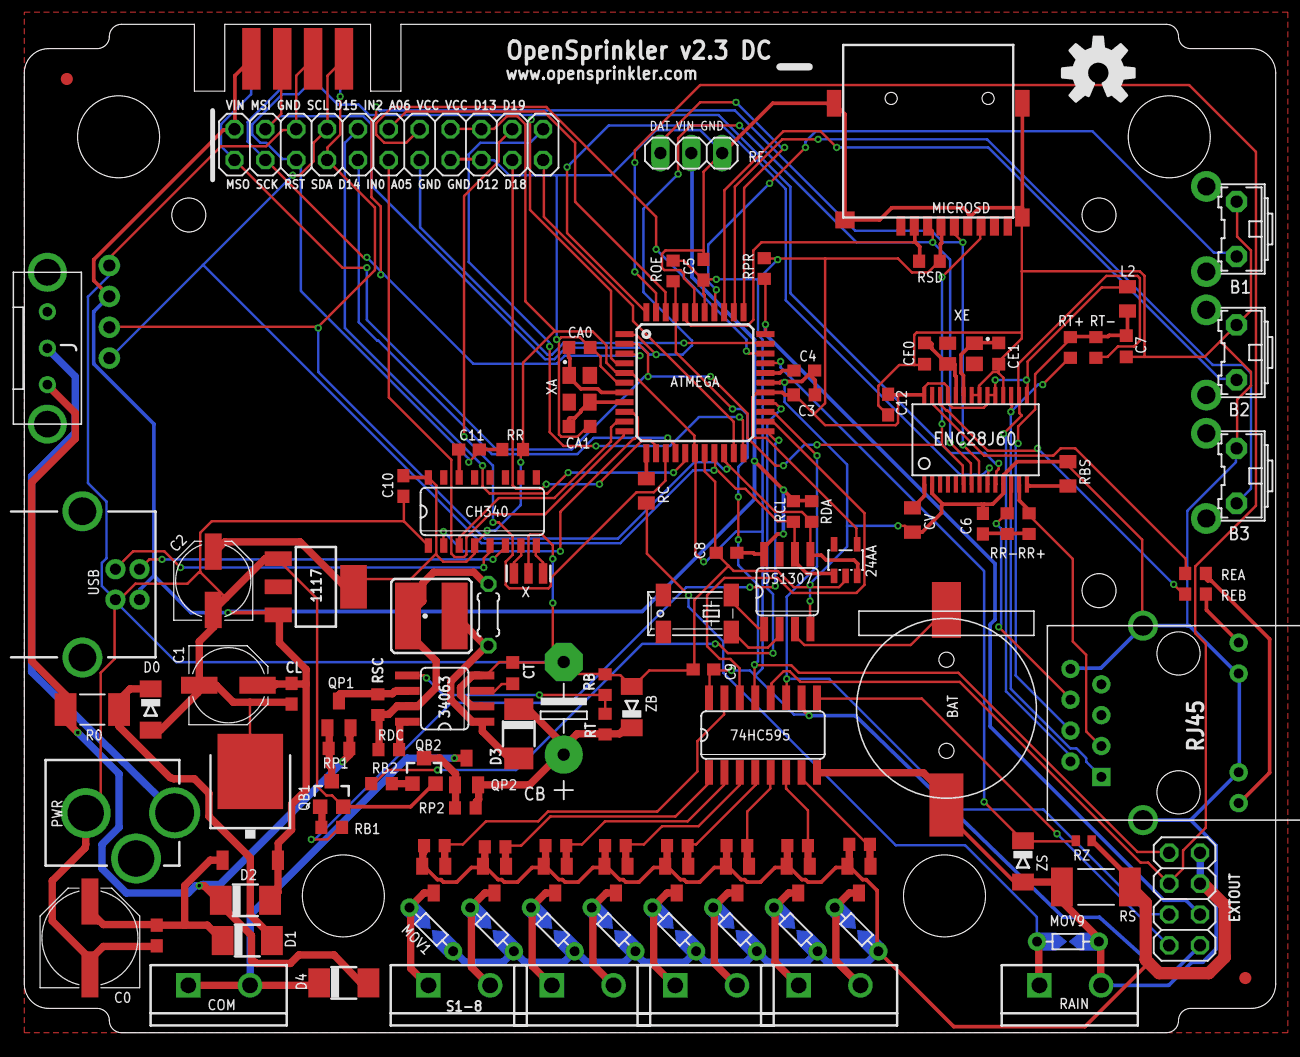
[picture p31: board os23dc.brd from above]

Board: 2 copper layers, 103.0 x 83.0 mm, 121 parts (0 on the bottom side), 96 nets.
