rayshobby/opensprinkler/OpenSprinkler Controller/hardware/v2.3/AC/os23ac.brd

## EAGLE design OpenSprinkler Controller/hardware/v2.3/AC/os23ac.brd (2015-08-03)

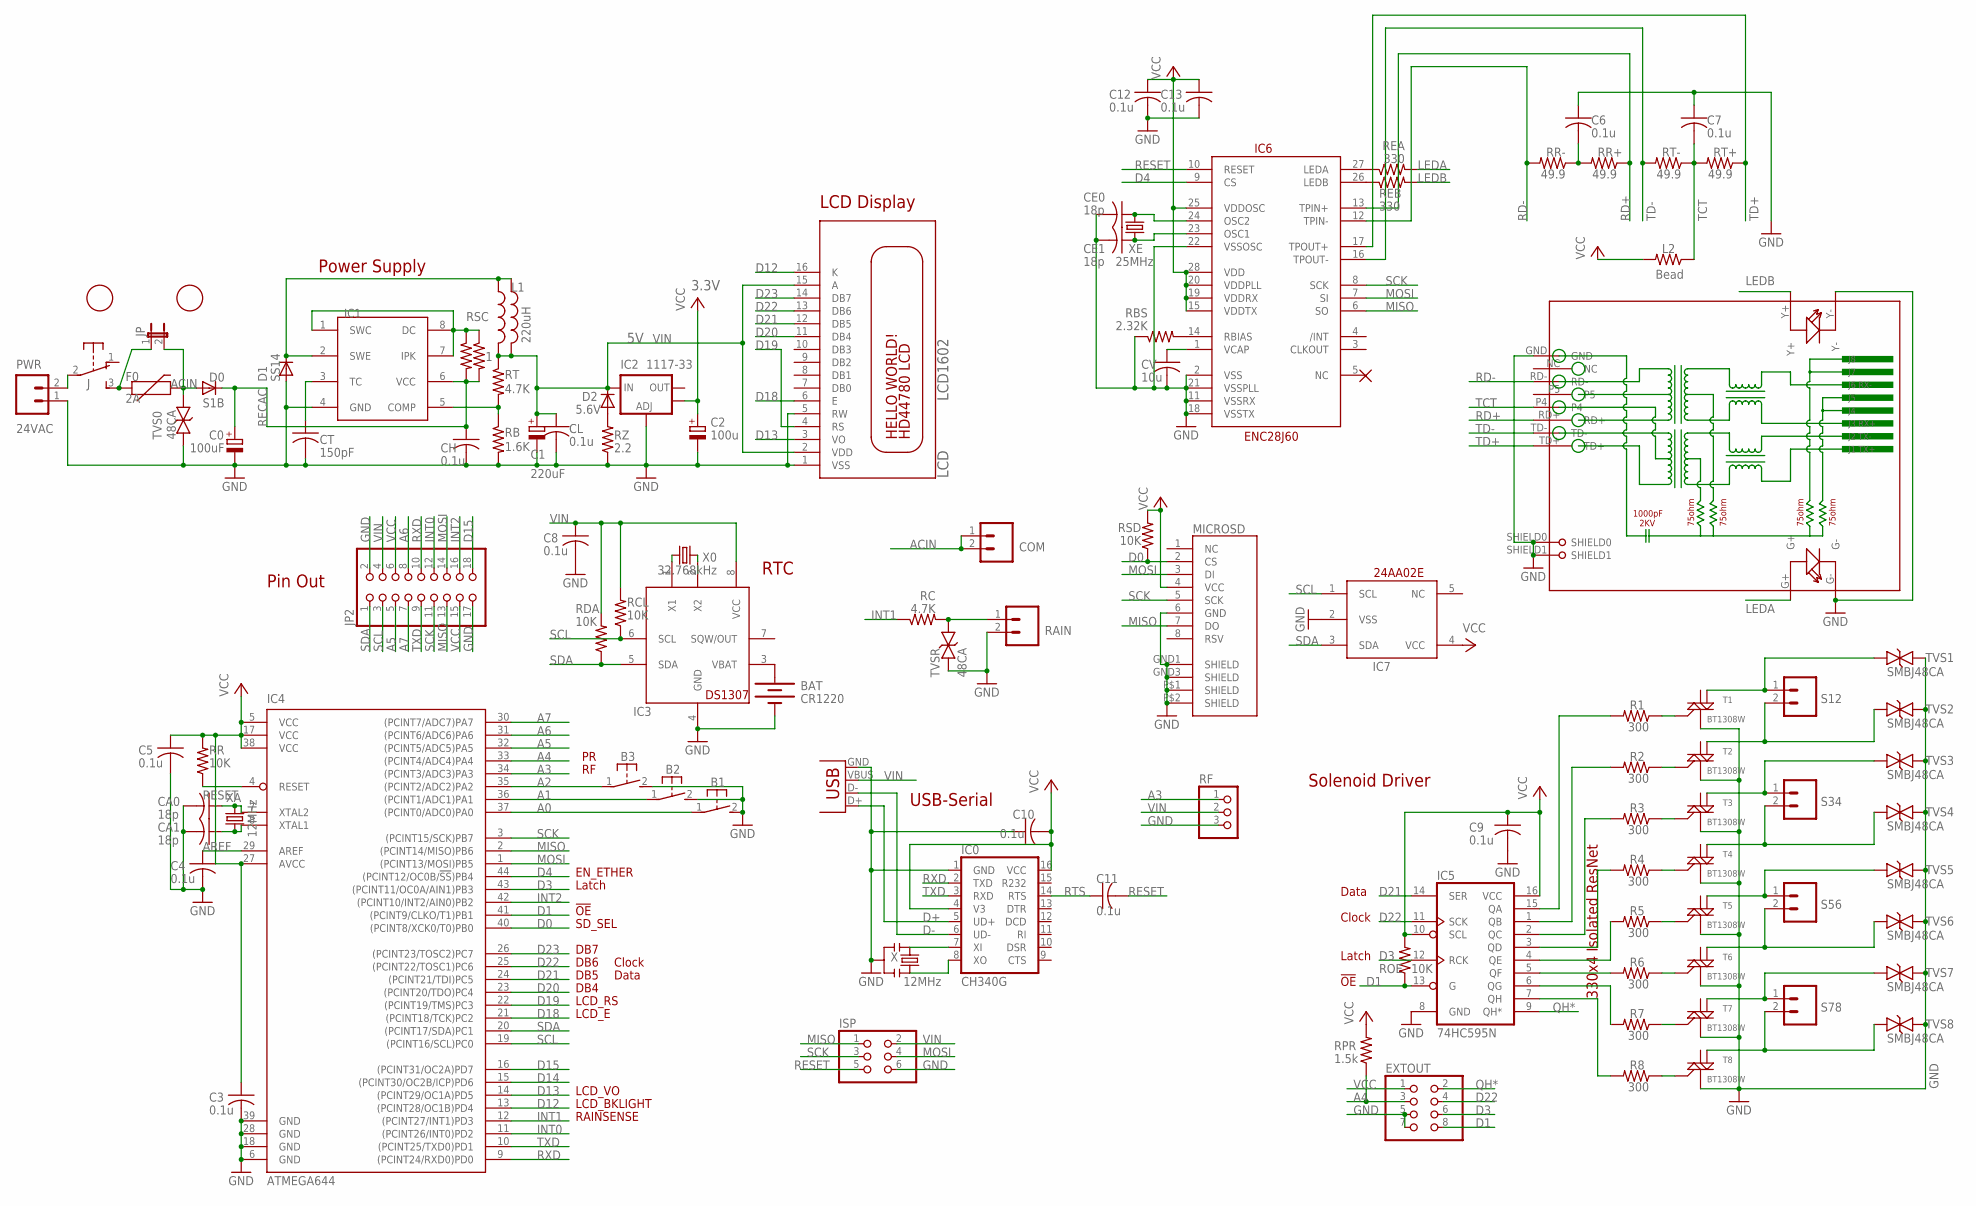
[picture p32: schematic os23ac.sch]

Parts:
B1, B2, B3: 31-XX; B3F-31XX
BAT: CR1220; BATTCON_12MM_SMT
C0: 100uF; PANASONIC_E
C1: 220uF; PANASONIC_E
C2: 100u; PANASONIC_D
C3, C7: 0.1u; C0603K
C4, C5, C6, C8, C9, C10, C11, C12, C13: 0.1u; C0603
CA0, CA1: 18p; C0603K
CE0, CE1: 18p; C0603K
CH: 0.1u; C0603
CL: 0.1u; C0603
COM: M025MM-X; SCREWTERMINAL-5MM-2-X
CT: 150pF; C0603K
CV: 10u; C0805K
D0: S1B; DO-214AC
D1: SS14; DO-214AC
D2: 5.6V; MINIMELF
EXTOUT: PINHD-2X4; 2X04
F0: 2A; PTC-1206
IC0: CH340G; SO16
IC1: 34063; SO08
IC2: 1117-33; SOT223
IC3: DS1307; SO08
IC4: ATMEGA644; TQFP44
IC5: 74HC595N; SO16
IC6: ENC28J60; SSOP28DB
IC7: 24AA02E; SOT23-5L
ISP: PINHD-2X3; 2X03
J: EG1206
JP: JUMPER-2PTH; 1X02
JP2: PINHD-2X9-CBIG; 2X09-CLEANBIG
L1: INDUCTORPWR; CDRH125
L1': 220uH; 0204/5
L2: Bead; R0805
LCD: LCD1602; LCD1602A
MICROSD: USD-SOCKETMICRO-SD-SOCKET-TAOBAO; MICRO-SD-SOCKET-TAOBAO
PWR: 24VAC; SCREWTERMINAL-4MM-2-X
R1, R2, R3, R4, R5, R6, R7, R8: 300; R0603
RAIN: M025MM-X; SCREWTERMINAL-5MM-2-X
RB: 1.6K; R0603
RBS: 2.32K; R0805
RC: 4.7K; R0805
RCL: 10K; R0603
RDA: 10K; R0603
REA: 330; R0603
REB: 330; R0603
RF: PINHD-1X3; 1X03
RJ45: HR911105A
ROE: 10K; R0603
RPR: 1.5k; R0603
RR: 10K; R0603
RR+: 49.9; R0603
RR-: 49.9; R0603
RSC, RSC1: 1; R0805
RSD: 10K; R0603
RT: 4.7K; R0805
RT+: 49.9; R0603
RT-: 49.9; R0603
RZ: 2.2; R2010
S12, S34, S56, S78: M025MM-X; SCREWTERMINAL-5MM-2-X
T1, T2, T3, T4, T5, T6, T7, T8: BT1308W; SOT223
TVS0: 48CA; SMB
TVS1, TVS2, TVS3, TVS4, TVS5, TVS6, TVS7, TVS8: SMBJ48CA; SMB
TVSR: 48CA; SMB
U$1, U$3: FIDUCIAL; FIDUCIAL_1MM
USB: USBPTH; USB-B-PTH
X: 12MHz; RESONATOR-SMD
X0: 32.768kHz; MM20SS
XA: 12MHz; 4SMD
XE: 25MHz; 4SMD

Connections:
A0: B1.1, IC4.37 ((PCINT0/ADC0)PA0)
A1: B2.1, IC4.36 ((PCINT1/ADC1)PA1)
A2: B3.1, IC4.35 ((PCINT2/ADC2)PA2)
A3: IC4.34 ((PCINT3/ADC3)PA3), RF.1
A4: EXTOUT.3, IC4.33 ((PCINT4/ADC4)PA4), RPR.1
A5: IC4.32 ((PCINT5/ADC5)PA5), JP2.5
A6: IC4.31 ((PCINT6/ADC6)PA6), JP2.8
A7: IC4.30 ((PCINT7/ADC7)PA7), JP2.7
ACIN: COM.1, COM.2, D0.A, F0.2, JP.2, TVS0.C
AREF: C4.1, IC4.29 (AREF)
D0: IC4.40 ((PCINT8/XCK0/T0)PB0), MICROSD.2 (CS), RSD.1
D1: EXTOUT.8, IC4.41 ((PCINT9/CLKO/T1)PB1), IC5.13 (G), ROE.1
D3: EXTOUT.6, IC4.43 ((PCINT11/OC0A/AIN1)PB3), IC5.12 (RCK)
D4: IC4.44 ((PCINT12/OC0B/!SS!)PB4), IC6.9 (CS)
D12: IC4.13 ((PCINT28/OC1B)PD4), LCD.16 (K)
D13: IC4.14 ((PCINT29/OC1A)PD5), LCD.3 (VO)
D14: IC4.15 ((PCINT30/OC2B/ICP)PD6)
D15: IC4.16 ((PCINT31/OC2A)PD7), JP2.18
D18: IC4.21 ((PCINT18/TCK)PC2), LCD.6 (E)
D19: IC4.22 ((PCINT19/TMS)PC3), LCD.4 (RS)
D20: IC4.23 ((PCINT20/TDO)PC4), LCD.11 (DB4)
D21: IC4.24 ((PCINT21/TDI)PC5), IC5.14 (SER), LCD.12 (DB5)
D22: EXTOUT.4, IC4.25 ((PCINT22/TOSC1)PC6), IC5.11 (SCK), LCD.13 (DB6)
D23: IC4.26 ((PCINT23/TOSC2)PC7), LCD.14 (DB7)
D+: IC0.5 (UD+), USB.D+
D-: IC0.6 (UD-), USB.D-
GND: B1.2 (S), B2.2 (S), B3.2 (S), BAT.P$1 (-), C0.-, C1.-, C2.-, C3.2, C4.2, C5.2, C6.1, C7.1, C8.2, C9.2, C10.1, C12.2, C13.2, CA0.2, CA1.2, CE0.2, CE1.2, CH.2, CL.2, CT.2, CV.2, D1.A, EXTOUT.5, EXTOUT.7, IC0.1 (GND), IC1.4 (GND), IC2.1 (ADJ), IC3.4 (GND), IC4.6 (GND), IC4.18 (GND), IC4.28 (GND), IC4.39 (GND), IC5.8 (GND), IC6.2 (VSS), IC6.11 (VSSRX), IC6.18 (VSSTX), IC6.21 (VSSPLL), IC6.22 (VSSOSC), IC7.2 (VSS), ISP.6, JP2.2, JP2.17, LCD.1 (VSS), LCD.5 (RW), MICROSD.6 (GND), MICROSD.GND1 (SHIELD), MICROSD.GND3 (SHIELD), MICROSD.P$1 (SHIELD), MICROSD.P$2 (SHIELD), PWR.1, RAIN.2, RB.2, RBS.1, RF.3, RJ45.G-, RJ45.GND, RJ45.SHIELD0, RJ45.SHIELD1, RJ45.Y-, RZ.1, T1.1 (M1), T2.1 (M1), T3.1 (M1), T4.1 (M1), T5.1 (M1), T6.1 (M1), T7.1 (M1), T8.1 (M1), TVS0.A, TVS1.C, TVS2.C, TVS3.C, TVS4.C, TVS5.C, TVS6.C, TVS7.C, TVS8.C, TVSR.A, USB.GND, X.2
INT0: IC4.11 ((PCINT26/INT0)PD2), JP2.12
INT1: IC4.12 ((PCINT27/INT1)PD3), RC.1
INT2: IC4.42 ((PCINT10/INT2/AIN0)PB2), JP2.16
LEDA: REA.2, RJ45.G+
LEDB: REB.2, RJ45.Y+
MISO: IC4.2 ((PCINT14/MISO)PB6), IC6.6 (SO), ISP.1, JP2.13, MICROSD.7 (DO)
MOSI: IC4.1 ((PCINT13/MOSI)PB5), IC6.7 (SI), ISP.4, JP2.14, MICROSD.3 (DI)
unnamed: J.2, PWR.2
unnamed: RAIN.1, RC.2, TVSR.C
unnamed: IC5.5 (QF), R6.2
unnamed: IC5.6 (QG), R7.2
unnamed: IC0.7 (XI), X.1
unnamed: IC5.7 (QH), R8.2
unnamed: IC3.1 (X1), X0.1
unnamed: F0.1, J.3 (S), JP.1
unnamed: IC5.4 (QE), R5.2
unnamed: IC5.3 (QD), R4.2
unnamed: IC5.2 (QC), R3.2
unnamed: IC5.1 (QB), R2.2
unnamed: IC5.15 (QA), R1.2
unnamed: CA0.1, IC4.7 (XTAL2), XA.1
unnamed: S12.1, T1.4 (M2-4), TVS1.A
unnamed: S12.2, T2.4 (M2-4), TVS2.A
unnamed: S34.1, T3.4 (M2-4), TVS3.A
unnamed: CA1.1, IC4.8 (XTAL1), XA.3 (2)
unnamed: S34.2, T4.4 (M2-4), TVS4.A
unnamed: R1.1, T1.3 (G)
unnamed: S56.1, T5.4 (M2-4), TVS5.A
unnamed: S56.2, T6.4 (M2-4), TVS6.A
unnamed: S78.1, T7.4 (M2-4), TVS7.A
unnamed: S78.2, T8.4 (M2-4), TVS8.A
unnamed: R2.1, T2.3 (G)
unnamed: R3.1, T3.3 (G)
unnamed: R4.1, T4.3 (G)
unnamed: R5.1, T5.3 (G)
unnamed: IC3.2 (X2), X0.4 (2)
unnamed: R6.1, T6.3 (G)
unnamed: R7.1, T7.3 (G)
unnamed: IC6.27 (LEDA), REA.1
unnamed: R8.1, T8.3 (G)
unnamed: BAT.P$2 (+), IC3.3 (VBAT)
unnamed: IC6.26 (LEDB), REB.1
unnamed: CV.1, IC6.1 (VCAP)
unnamed: IC0.8 (XO), X.3
unnamed: CE0.1, IC6.24 (OSC2), XE.3 (2)
unnamed: CE1.1, IC6.23 (OSC1), XE.1
unnamed: D2.A, RZ.2
unnamed: IC1.1 (SWC), IC1.7 (IPK), IC1.8 (DC), RSC.1, RSC1.1
unnamed: D1.C, IC1.2 (SWE), L1.1, L1'.1
unnamed: CT.1, IC1.3 (TC)
unnamed: C6.2, RR+.2, RR-.1
unnamed: IC1.5 (COMP), RB.1, RT.2
unnamed: IC6.14 (RBIAS), RBS.2
QH*: EXTOUT.2, IC5.9 (QH*)
RD+: IC6.13 (TPIN+), RJ45.RD+, RR+.1
RD-: IC6.12 (TPIN-), RJ45.RD-, RR-.2
RECAC: C0.+, CH.1, D0.C, IC1.6 (VCC), RSC.2, RSC1.2
RESET: C11.2, IC4.4 (RESET), IC6.10 (RESET), ISP.5, RR.1
RTS: C11.1, IC0.14 (RTS)
RXD: IC0.2 (TXD), IC4.9 ((PCINT24/RXD0)PD0), JP2.10
SCK: IC4.3 ((PCINT15/SCK)PB7), IC6.8 (SCK), ISP.3, JP2.11, MICROSD.5 (SCK)
SCL: IC3.6 (SCL), IC4.19 ((PCINT16/SCL)PC0), IC7.1 (SCL), JP2.3, RCL.1
SDA: IC3.5 (SDA), IC4.20 ((PCINT17/SDA)PC1), IC7.3 (SDA), JP2.1, RDA.1
TCT: C7.2, L2.1, RJ45.P4, RT+.2, RT-.1
TD+: IC6.17 (TPOUT+), RJ45.TD+, RT+.1
TD-: IC6.16 (TPOUT-), RJ45.TD-, RT-.2
TXD: IC0.3 (RXD), IC4.10 ((PCINT25/TXD0)PD1), JP2.9
VCC: C2.+, C3.1, C5.1, C9.1, C10.2, C12.1, C13.1, EXTOUT.1, IC0.4 (V3), IC0.16 (VCC), IC2.4 (OUT), IC4.5 (VCC), IC4.17 (VCC), IC4.27 (AVCC), IC4.38 (VCC), IC5.10 (SCL), IC5.16 (VCC), IC6.15 (VDDTX), IC6.19 (VDDRX), IC6.20 (VDDPLL), IC6.25 (VDDOSC), IC6.28 (VDD), IC7.4 (VCC), JP2.6, JP2.15, L2.2, MICROSD.4 (VCC), ROE.2, RPR.2, RR.2, RSD.2
VIN: C1.+, C8.1, CL.1, D2.C, IC2.3 (IN), IC3.8 (VCC), ISP.2, JP2.4, L1.2, L1'.2, LCD.2 (VDD), LCD.15 (A), RCL.2, RDA.2, RF.2, RT.1, USB.VBUS

Notes on the sheet:
Power Supply
Solenoid Driver
Data
Clock
Latch
DB4
330x4 Isolated ResNet
LCD Display
EN_ETHER
3.3V
DB7
LCD_E
LCD_RS
DB6
DB5
!OE
RAINSENSE
LCD_BKLIGHT
LCD_VO
SD_SEL
USB-Serial
Pin Out
RTC

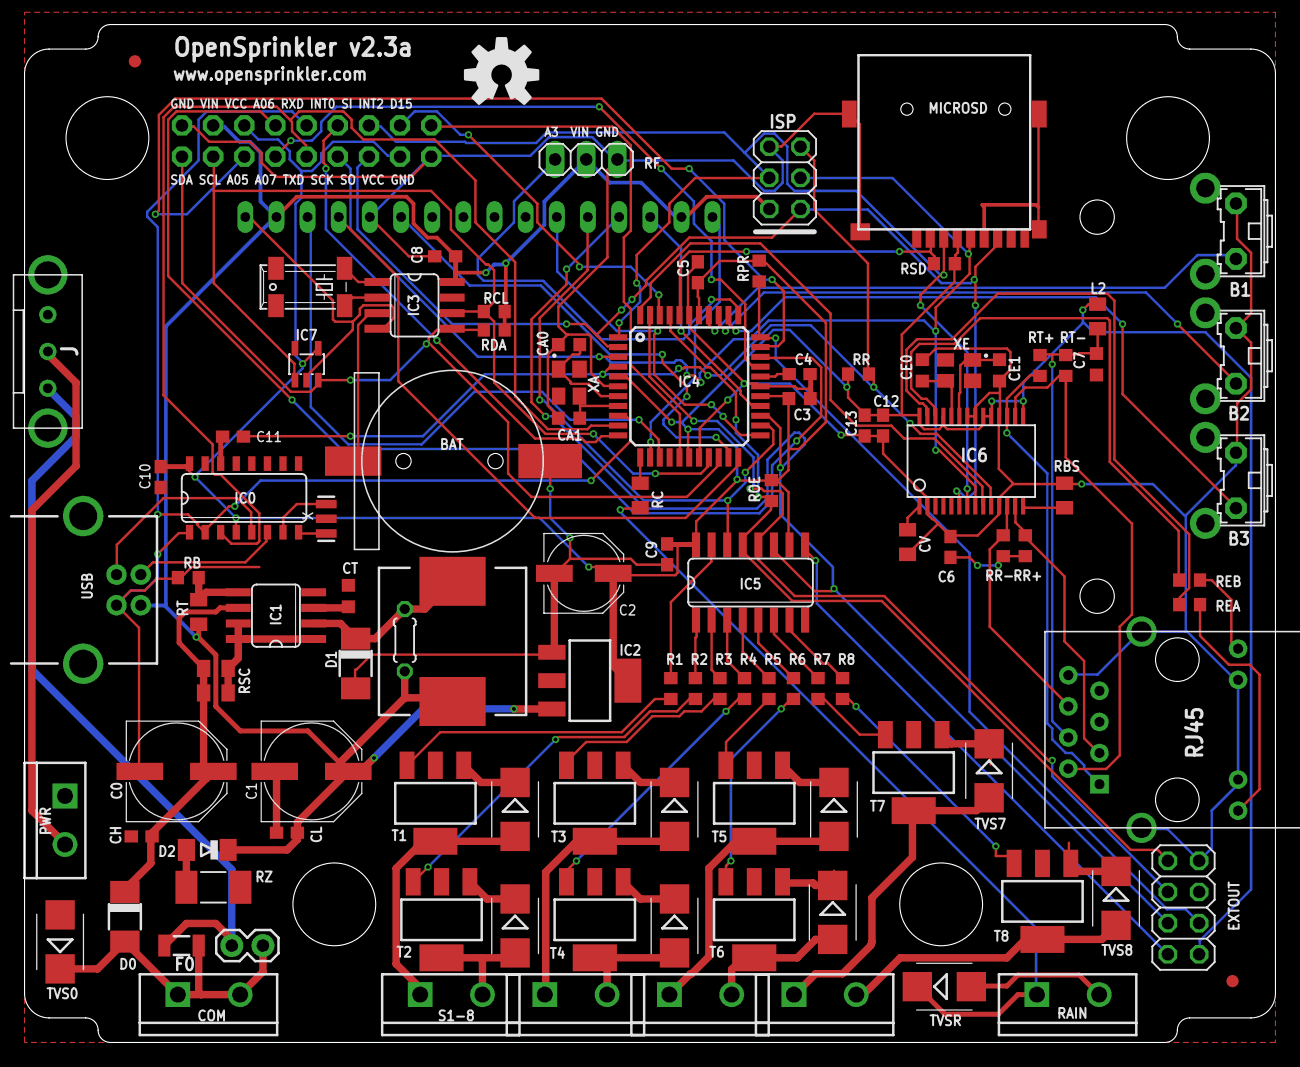
[picture p33: board os23ac.brd from above]

Board: 2 copper layers, 102.0 x 83.0 mm, 109 parts (0 on the bottom side), 95 nets.
