rayshobby/opensprinkler/OpenSprinkler Controller/hardware/v2.2/diy/os22_rev_diy.brd

## EAGLE design OpenSprinkler Controller/hardware/v2.2/diy/os22_rev_diy.brd (2014-12-05, an earlier design)

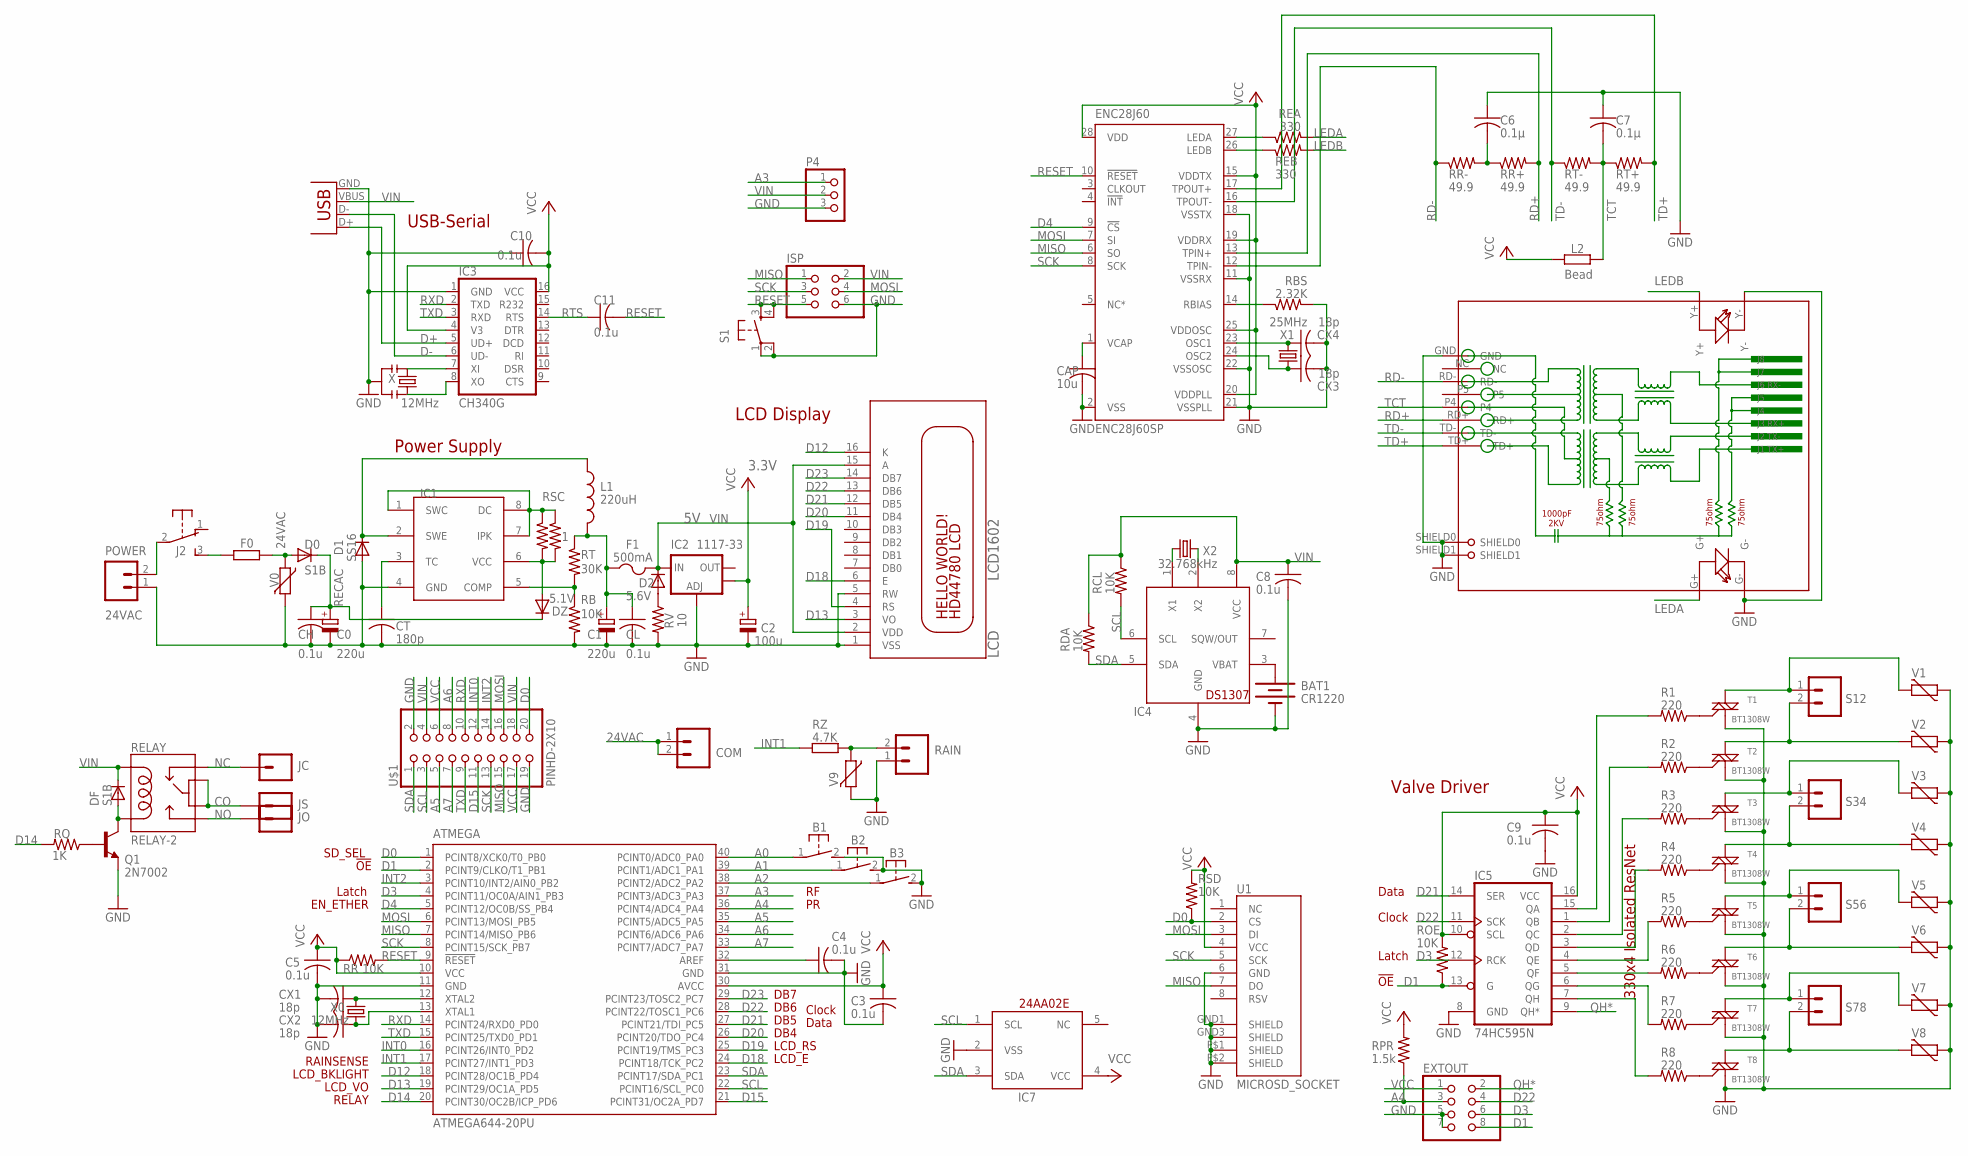
[picture p34: schematic os22_rev_diy.sch]

Parts:
ATMEGA: ATMEGA644-20PU; DIL40
B1, B2, B3: 31-XX; B3F-31XX
BAT1: CR1220; BATTCON_12MM_SMT
C0, C1: 220u; E3,5-8
C2: 100u; E2-5
C3, C4, C5, C8, C9, C10, C11: 0.1u; C0603K
C6, C7: 0.1µ; C0603K
CAP: 10u; C0805K
CH: 0.1u; C0603K
CL: 0.1u; C0603K
COM: M025MM-X; SCREWTERMINAL-5MM-2-X
CT: 180p; C0603K
CX1, CX2, CX3, CX4: 18p; C0603K
D0: S1B; DO-214AC
D1: SS16; DO-214AC
D2: 5.6V; MINIMELF
DF: S1B; DO-214AC
DZ: 5.1V; MELF-MLL41
ENC28J60: ENC28J60SP; DIL28-3
EXTOUT: PINHD-2X4; 2X04
F0: R-EU_0411/3V; 0411V
F1: 500mA; 1812
IC1: 34063; SO08
IC2: 1117-33; SOT223
IC3: CH340G; SO16
IC4: DS1307; SO08
IC5: 74HC595N; SO16
IC7: 24AA02E; SOT23-5L
ISP: PINHD-2X3; 2X03
J2: EG1206
JC: M01PTH; 1X01
JO: M01PTH; 1X01
JS: M01PTH; 1X01
L1: 220uH; 0204/5
L2: Bead; R0805
LCD: LCD1602; LCD1602A
P4: PINHD-1X3; 1X03
POWER: 24VAC; SCREWTERMINAL-4MM-2-X
Q1: 2N7002; SOT23-3
R1, R2, R3, R4, R5, R6, R7, R8: 220; R0603
RAIN: M025MM-X; SCREWTERMINAL-5MM-2-X
RB: 10K; R0805
RBS: 2.32K; R0805
RCL: 10K; R0603
RDA: 10K; R0603
REA: 330; R0603
REB: 330; R0603
RELAY: RELAY-2; RELAY-HK4100F
RJ45: HR911105A
ROE: 10K; R0603
RPR: 1.5k; R0603
RQ: 1K; R0603
RR: 10K; R0603
RR+: 49.9; R0805
RR-: 49.9; R0805
RSC, RSC1: 1; R0805
RSD: 10K; R0603
RT: 30K; R0805
RT+: 49.9; R0805
RT-: 49.9; R0805
RV: 10; R0805
RZ: 4.7K; R0805
S1: TAC_SWITCHPTH; TACTILE-PTH
S12, S34, S56, S78: M025MM-X; SCREWTERMINAL-5MM-2-X
T1, T2, T3, T4, T5, T6, T7, T8: BT1308W; TO-92
U1: MICROSD_SOCKET; MICRO-SD-SOCKET-TAOBAO
U$1: PINHD-2X10; 2X10-CLEANBIG
USB: USBPTH; USB-B-PTH
V0, V1, V2, V3, V4, V5, V6, V7, V8, V9: MOV; R-5
X: 12MHz; RESONATOR-SMD
X0: 12MHz; HC49U-V
X1: 25MHz; HC49U-V
X2: 32.768kHz; TC38H

Connections:
24VAC: COM.1, COM.2, D0.A, F0.2, V0.1
A0: ATMEGA.40 (PCINT0/ADC0_PA0), B1.1
A1: ATMEGA.39 (PCINT1/ADC1_PA1), B2.1
A2: ATMEGA.38 (PCINT2/ADC2_PA2), B3.1
A3: ATMEGA.37 (PCINT3/ADC3_PA3), P4.1
A4: ATMEGA.36 (PCINT4/ADC4_PA4), EXTOUT.3, RPR.1
A5: ATMEGA.35 (PCINT5/ADC5_PA5), U$1.5
A6: ATMEGA.34 (PCINT6/ADC6_PA6), U$1.8
A7: ATMEGA.33 (PCINT7/ADC7_PA7), U$1.7
AREF: ATMEGA.32 (AREF), C4.1
CO: JS.1, RELAY.5, RELAY.6
D0: ATMEGA.1 (PCINT8/XCK0/T0_PB0), RSD.1, U1.2 (CS), U$1.20
D1: ATMEGA.2 (PCINT9/CLKO/T1_PB1), EXTOUT.8, IC5.13 (G), ROE.1
D3: ATMEGA.4 (PCINT11/OC0A/AIN1_PB3), EXTOUT.6, IC5.12 (RCK)
D4: ATMEGA.5 (PCINT12/OC0B/SS_PB4), ENC28J60.9 (!CS)
D12: ATMEGA.18 (PCINT28/OC1B_PD4), LCD.16 (K)
D13: ATMEGA.19 (PCINT29/OC1A_PD5), LCD.3 (VO)
D14: ATMEGA.20 (PCINT30/OC2B/ICP_PD6), RQ.2
D15: ATMEGA.21 (PCINT31/OC2A_PD7), U$1.11
D18: ATMEGA.24 (PCINT18/TCK_PC2), LCD.6 (E)
D19: ATMEGA.25 (PCINT19/TMS_PC3), LCD.4 (RS)
D20: ATMEGA.26 (PCINT20/TDO_PC4), LCD.11 (DB4)
D21: ATMEGA.27 (PCINT21/TDI_PC5), IC5.14 (SER), LCD.12 (DB5)
D22: ATMEGA.28 (PCINT22/TOSC1_PC6), EXTOUT.4, IC5.11 (SCK), LCD.13 (DB6)
D23: ATMEGA.29 (PCINT23/TOSC2_PC7), LCD.14 (DB7)
D+: IC3.5 (UD+), USB.D+
D-: IC3.6 (UD-), USB.D-
GND: ATMEGA.11 (GND), ATMEGA.31 (GND), B1.2 (S), B2.2 (S), B3.2 (S), BAT1.P$1 (-), C0.-, C1.-, C2.-, C3.2, C4.2, C5.2, C6.1, C7.1, C8.2, C9.2, C10.1, CAP.2, CH.2, CL.2, CT.2, CX1.2, CX2.2, CX3.2, CX4.2, D1.A, ENC28J60.2 (VSS), ENC28J60.11 (VSSRX), ENC28J60.18 (VSSTX), ENC28J60.21 (VSSPLL), ENC28J60.22 (VSSOSC), EXTOUT.5, EXTOUT.7, IC1.4 (GND), IC2.1 (ADJ), IC3.1 (GND), IC4.4 (GND), IC5.8 (GND), IC7.2 (VSS), ISP.6, LCD.1 (VSS), LCD.5 (RW), P4.3, POWER.1, Q1.2 (E), RAIN.1, RB.2, RBS.2, RJ45.G-, RJ45.GND, RJ45.SHIELD0, RJ45.SHIELD1, RJ45.Y-, RV.2, S1.1, S1.2, T1.1 (M1), T2.1 (M1), T3.1 (M1), T4.1 (M1), T5.1 (M1), T6.1 (M1), T7.1 (M1), T8.1 (M1), U1.6 (GND), U1.GND1 (SHIELD), U1.GND3 (SHIELD), U1.P$1 (SHIELD), U1.P$2 (SHIELD), U$1.2, U$1.19, USB.GND, V0.2, V1.1, V2.1, V3.1, V4.1, V5.1, V6.1, V7.1, V8.1, V9.2, X.2
INT0: ATMEGA.16 (PCINT26/INT0_PD2), U$1.12
INT1: ATMEGA.17 (PCINT27/INT1_PD3), RZ.2
INT2: ATMEGA.3 (PCINT10/INT2/AIN0_PB2), U$1.14
LEDA: REA.2, RJ45.G+
LEDB: REB.2, RJ45.Y+
MISO: ATMEGA.7 (PCINT14/MISO_PB6), ENC28J60.6 (SO), ISP.1, U1.7 (DO), U$1.15
MOSI: ATMEGA.6 (PCINT13/MOSI_PB5), ENC28J60.7 (SI), ISP.4, U1.3 (DI), U$1.16
unnamed: IC4.2 (X2), X2.2
unnamed: IC4.1 (X1), X2.1
unnamed: R1.1, T1.2 (G)
unnamed: IC5.5 (QF), R6.2
unnamed: IC5.6 (QG), R7.2
unnamed: J2.2, POWER.2
unnamed: IC5.7 (QH), R8.2
unnamed: BAT1.P$2 (+), IC4.3 (VBAT)
unnamed: D1.C, IC1.2 (SWE), L1.1
unnamed: IC5.4 (QE), R5.2
unnamed: IC5.3 (QD), R4.2
unnamed: IC5.2 (QC), R3.2
unnamed: IC5.1 (QB), R2.2
unnamed: IC5.15 (QA), R1.2
unnamed: R2.1, T2.2 (G)
unnamed: S12.1, T1.3 (M2), V1.2
unnamed: S12.2, T2.3 (M2), V2.2
unnamed: S34.1, T3.3 (M2), V3.2
unnamed: ENC28J60.14 (RBIAS), RBS.1
unnamed: S34.2, T4.3 (M2), V4.2
unnamed: R3.1, T3.2 (G)
unnamed: S56.1, T5.3 (M2), V5.2
unnamed: S56.2, T6.3 (M2), V6.2
unnamed: S78.1, T7.3 (M2), V7.2
unnamed: S78.2, T8.3 (M2), V8.2
unnamed: R4.1, T4.2 (G)
unnamed: R5.1, T5.2 (G)
unnamed: R6.1, T6.2 (G)
unnamed: R7.1, T7.2 (G)
unnamed: RAIN.2, RZ.1, V9.1
unnamed: F0.1, J2.3 (S)
unnamed: CAP.1, ENC28J60.1 (VCAP)
unnamed: ENC28J60.27 (LEDA), REA.1
unnamed: DF.A, Q1.3 (C), RELAY.9
unnamed: ENC28J60.26 (LEDB), REB.1
unnamed: DZ.A, IC1.6 (VCC), RSC.2, RSC1.2
unnamed: D2.A, RV.1
unnamed: Q1.1 (B), RQ.1
unnamed: CX3.1, ENC28J60.24 (OSC2), X1.2
unnamed: CX4.1, ENC28J60.23 (OSC1), X1.1
unnamed: R8.1, T8.2 (G)
unnamed: IC3.7 (XI), X.1
unnamed: IC1.1 (SWC), IC1.7 (IPK), IC1.8 (DC), RSC.1, RSC1.1
unnamed: ATMEGA.12 (XTAL2), CX1.1, X0.2
unnamed: ATMEGA.13 (XTAL1), CX2.1, X0.1
unnamed: IC3.8 (XO), X.3
unnamed: CT.1, IC1.3 (TC)
unnamed: C6.2, RR+.1, RR-.2
unnamed: IC1.5 (COMP), RB.1, RT.2
NC: JC.1, RELAY.1
NO: JO.1, RELAY.10
QH*: EXTOUT.2, IC5.9 (QH*)
RD+: ENC28J60.13 (TPIN+), RJ45.RD+, RR+.2
RD-: ENC28J60.12 (TPIN-), RJ45.RD-, RR-.1
RECAC: C0.+, CH.1, D0.C, DZ.C
RESET: ATMEGA.9 (!RESET), C11.2, ENC28J60.10 (!RESET), ISP.5, RR.2, S1.3, S1.4
RTS: C11.1, IC3.14 (RTS)
RXD: ATMEGA.14 (PCINT24/RXD0_PD0), IC3.2 (TXD), U$1.10
SCK: ATMEGA.8 (PCINT15/SCK_PB7), ENC28J60.8 (SCK), ISP.3, U1.5 (SCK), U$1.13
SCL: ATMEGA.22 (PCINT16/SCL_PC0), IC4.6 (SCL), IC7.1 (SCL), RCL.2, U$1.3
SDA: ATMEGA.23 (PCINT17/SDA_PC1), IC4.5 (SDA), IC7.3 (SDA), RDA.2, U$1.1
TCT: C7.2, L2.1, RJ45.P4, RT+.1, RT-.2
TD+: ENC28J60.17 (TPOUT+), RJ45.TD+, RT+.2
TD-: ENC28J60.16 (TPOUT-), RJ45.TD-, RT-.1
TXD: ATMEGA.15 (PCINT25/TXD0_PD1), IC3.3 (RXD), U$1.9
VCC: ATMEGA.10 (VCC), ATMEGA.30 (AVCC), C2.+, C3.1, C5.1, C9.1, C10.2, ENC28J60.15 (VDDTX), ENC28J60.19 (VDDRX), ENC28J60.20 (VDDPLL), ENC28J60.25 (VDDOSC), ENC28J60.28 (VDD), EXTOUT.1, IC2.4 (OUT), IC3.4 (V3), IC3.16 (VCC), IC5.10 (SCL), IC5.16 (VCC), IC7.4 (VCC), L2.2, ROE.2, RPR.2, RR.1, RSD.2, U1.4 (VCC), U$1.6, U$1.17
VIN: C8.1, D2.C, DF.C, F1.2, IC2.3 (IN), IC4.8 (VCC), ISP.2, LCD.2 (VDD), LCD.15 (A), P4.2, RCL.1, RDA.1, RELAY.2, U$1.4, U$1.18, USB.VBUS
VIN1: C1.+, CL.1, F1.1, L1.2, RT.1

Notes on the sheet:
Valve Driver
Data
Clock
Latch
DB4
330x4 Isolated ResNet
LCD Display
EN_ETHER
3.3V
DB7
LCD_E
LCD_RS
DB6
DB5
!OE
RAINSENSE
LCD_BKLIGHT
LCD_VO
SD_SEL
RELAY
USB-Serial
Power Supply

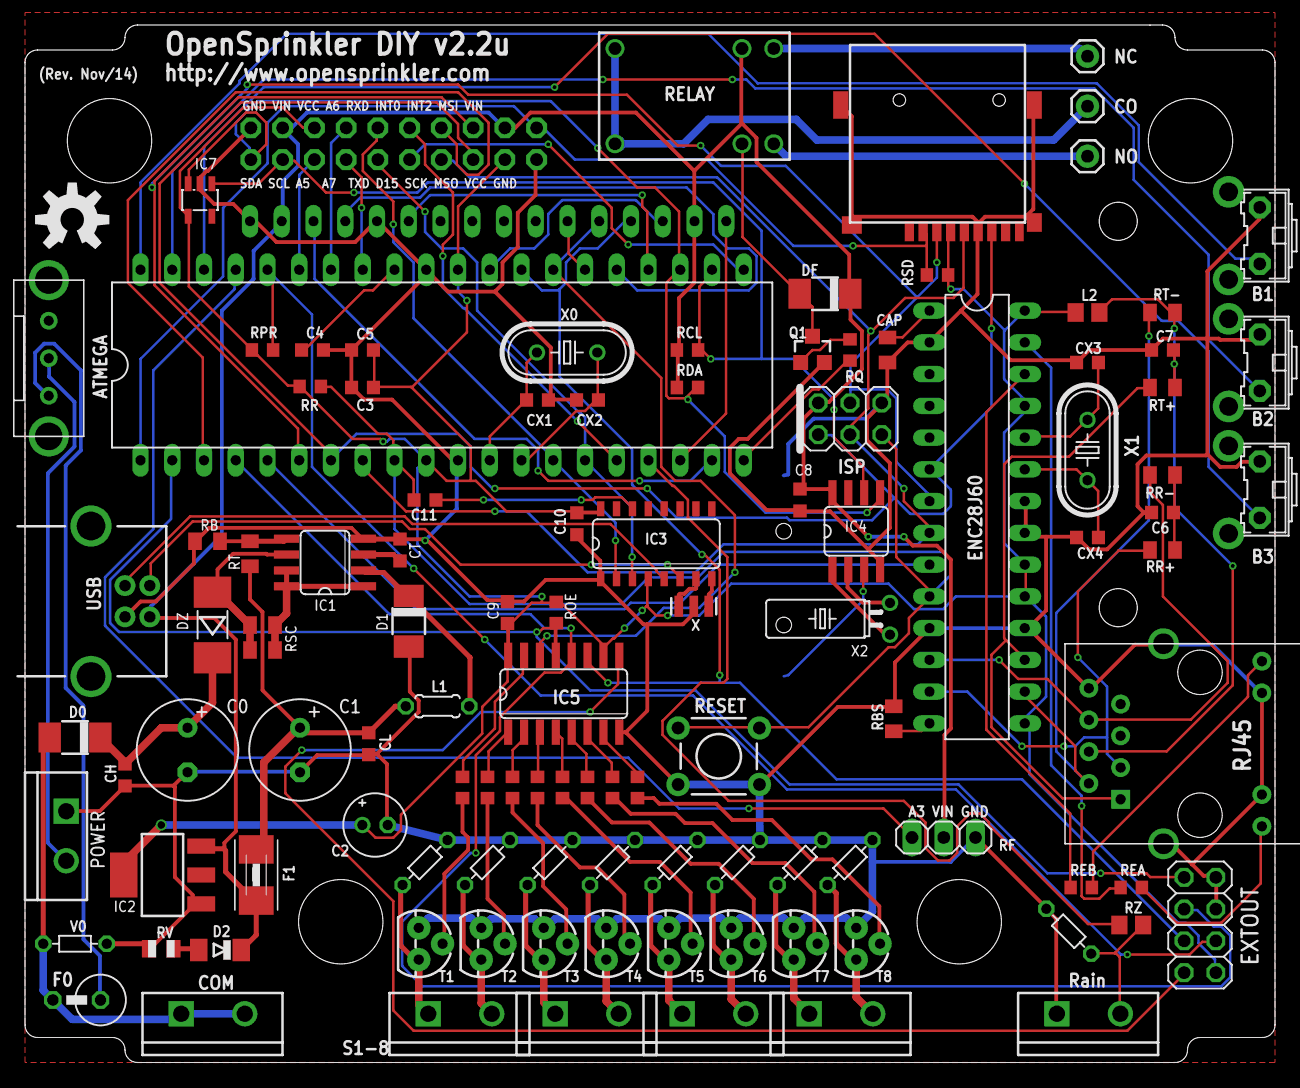
[picture p35: board os22_rev_diy.brd from above]

Board: 2 copper layers, 100.0 x 83.0 mm, 113 parts (1 on the bottom side), 103 nets.
