rayshobby/opensprinkler/OpenSprinkler Pi/hardware/ospi_v14.brd

## EAGLE design OpenSprinkler Pi/hardware/ospi_v14.brd (2014-10-26)

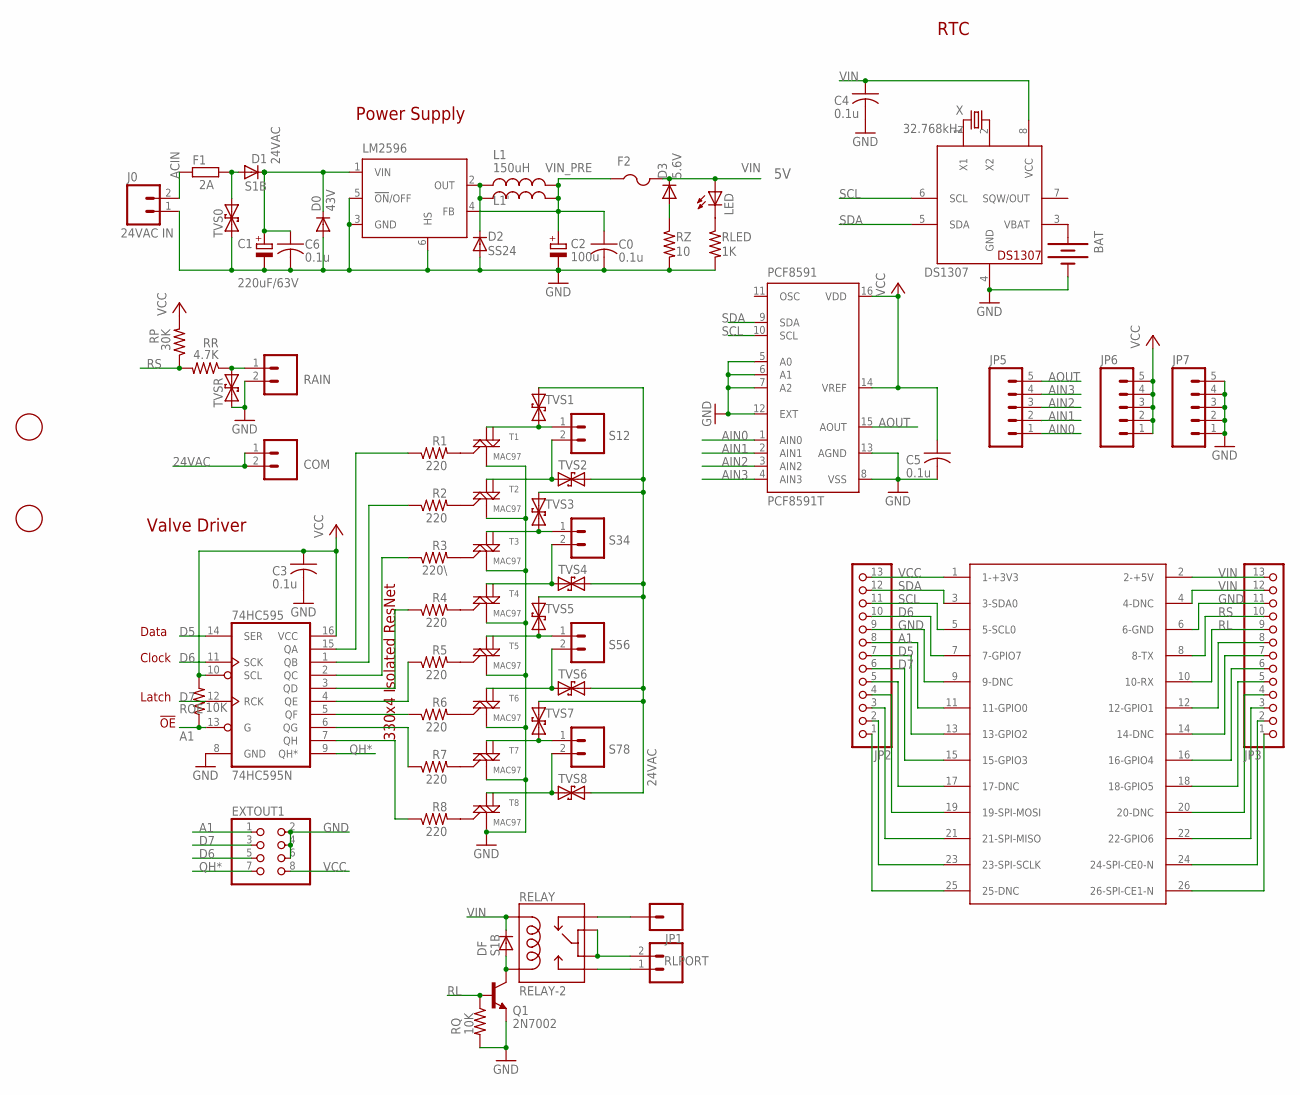
[picture p36: schematic ospi_v14.sch]

Parts:
74HC595: 74HC595N; SO16
BAT: BATTERYBATTERY_12MM_SMT; BATTCON_12MM_SMT
C0, C3, C4, C5, C6: 0.1u; C0805K
C1: 220uF/63V; E5-10,5
C2: 100u; E3,5-8
COM: M025MM-X; SCREWTERMINAL-5MM-2-X
D0: 43V; MINIMELF
D1: S1B; DO-214AC
D2: SS24; SMB
D3: 5.6V; MINIMELF
DF: S1B; DO-214AC
DS1307: DS1307; SO08
EXTOUT1: PINHD-2X4/90; 2X04/90
F1: 2A; 0411V
F2: PTCFUSE-1812; 1812
J0: 24VAC IN; SCREWTERMINAL-4MM-2-X
JP1: M01PTH; 1X01
JP2, JP3: PINHD-1X13_BIG; 1X13-BIG
JP5, JP6, JP7: M05LOCK; 1X05_LOCK
L1: 150uH; CDRH125
L1': 150uH; 0207/7
LED: LEDCHIPLED_0805; CHIPLED_0805
LM2596: LM2596S; TO263-5
PCF8591: PCF8591T; SO16W
Q1: 2N7002; SOT23-3
R1, R2, R4, R5, R6, R7, R8: 220; R0805
R3: 220\; R0805
RAIN: M025MM-X; SCREWTERMINAL-5MM-2-X
RELAY: RELAY-2; RELAY-HK4100F
RLED: 1K; R0805
RLPORT: M025MM; SCREWTERMINAL-5MM-2
ROE: 10K; R0805
RP: 30K; R0805
RQ: 10K; R0805
RR: 4.7K; R0805
RZ: 10; R0805
S12, S34, S56, S78: M025MM-X; SCREWTERMINAL-5MM-2-X
T1, T2, T3, T4, T5, T6, T7, T8: MAC97; SOT223
TVS0, TVS1, TVS2, TVS3, TVS4, TVS5, TVS6, TVS7, TVS8: TVSSMB; SMB
TVSR: TVSSMB; SMB
U$1, U$3: FIDUCIAL; FIDUCIAL_1MM
U$2: RASPBERRY-PI
X: 32.768kHz; TC38H

Connections:
24VAC: COM.1, COM.2, D1.A, F1.2, TVS0.C, TVS1.C, TVS2.C, TVS3.C, TVS4.C, TVS5.C, TVS6.C, TVS7.C, TVS8.C
A1: 74HC595.13 (G), EXTOUT1.1, JP2.8, ROE.1, U$2.11 (11-GPIO0)
ACIN: F1.1, J0.2
AIN0: JP5.1, PCF8591.1 (AIN0)
AIN1: JP5.2, PCF8591.2 (AIN1)
AIN2: JP5.3, PCF8591.3 (AIN2)
AIN3: JP5.4, PCF8591.4 (AIN3)
AOUT: JP5.5, PCF8591.15 (AOUT)
CO: RELAY.5, RELAY.6, RLPORT.2
D5: 74HC595.14 (SER), JP2.7, U$2.13 (13-GPIO2)
D6: 74HC595.11 (SCK), EXTOUT1.5, JP2.10, U$2.7 (7-GPIO7)
D7: 74HC595.12 (RCK), EXTOUT1.3, JP2.6, U$2.15 (15-GPIO3)
GND: 74HC595.8 (GND), BAT.P$1 (-), C0.2, C1.-, C2.-, C3.2, C4.2, C5.2, C6.2, D0.A, D2.A, DS1307.4 (GND), EXTOUT1.2, EXTOUT1.4, EXTOUT1.6, J0.1, JP2.9, JP3.11, JP7.1, JP7.2, JP7.3, JP7.4, JP7.5, LM2596.3 (GND), LM2596.5 (!ON!/OFF), LM2596.6 (HS), PCF8591.5 (A0), PCF8591.6 (A1), PCF8591.7 (A2), PCF8591.8 (VSS), PCF8591.12 (EXT), PCF8591.13 (AGND), Q1.2 (E), RAIN.2, RLED.2, RQ.2, RZ.2, T1.1 (M1), T2.1 (M1), T3.1 (M1), T4.1 (M1), T5.1 (M1), T6.1 (M1), T7.1 (M1), T8.1 (M1), TVS0.A, TVSR.A, U$2.6 (6-GND), U$2.9 (9-DNC)
unnamed: LED.C, RLED.1
unnamed: C1.+, C6.1, D0.C, D1.C, LM2596.1 (VIN)
unnamed: R1.2, T1.3 (G)
unnamed: 74HC595.5 (QF), R6.1
unnamed: 74HC595.6 (QG), R7.1
unnamed: D3.A, RZ.1
unnamed: 74HC595.7 (QH), R8.1
unnamed: D2.C, L1.1, L1'.1, LM2596.2 (OUT)
unnamed: DS1307.1 (X1), X.2
unnamed: 74HC595.4 (QE), R5.1
unnamed: 74HC595.3 (QD), R4.1
unnamed: 74HC595.2 (QC), R3.1
unnamed: 74HC595.1 (QB), R2.1
unnamed: 74HC595.15 (QA), R1.1
unnamed: R2.2, T2.3 (G)
unnamed: S12.1, T1.2 (M2), TVS1.A
unnamed: S12.2, T2.2 (M2), TVS2.A
unnamed: S34.1, T3.2 (M2), TVS3.A
unnamed: R3.2, T3.3 (G)
unnamed: S34.2, T4.2 (M2), TVS4.A
unnamed: R4.2, T4.3 (G)
unnamed: S56.1, T5.2 (M2), TVS5.A
unnamed: S56.2, T6.2 (M2), TVS6.A
unnamed: S78.1, T7.2 (M2), TVS7.A
unnamed: S78.2, T8.2 (M2), TVS8.A
unnamed: R5.2, T5.3 (G)
unnamed: R6.2, T6.3 (G)
unnamed: R7.2, T7.3 (G)
unnamed: R8.2, T8.3 (G)
unnamed: DS1307.2 (X2), X.1
unnamed: RAIN.1, RR.1, TVSR.C
unnamed: BAT.P$2 (+), DS1307.3 (VBAT)
unnamed: JP3.8, U$2.12 (12-GPIO1)
unnamed: JP3.7, U$2.14 (14-DNC)
unnamed: JP3.6, U$2.16 (16-GPIO4)
unnamed: JP2.5, U$2.17 (17-DNC)
unnamed: JP2.4, U$2.19 (19-SPI-MOSI)
unnamed: JP2.3, U$2.21 (21-SPI-MISO)
unnamed: JP2.2, U$2.23 (23-SPI-SCLK)
unnamed: JP2.1, U$2.25 (25-DNC)
unnamed: JP3.5, U$2.18 (18-GPIO5)
unnamed: JP3.4, U$2.20 (20-DNC)
unnamed: JP3.3, U$2.22 (22-GPIO6)
unnamed: JP3.2, U$2.24 (24-SPI-CE0-N)
unnamed: JP3.1, U$2.26 (26-SPI-CE1-N)
unnamed: DF.A, Q1.3 (C), RELAY.9
NC: JP1.1, RELAY.1
NO: RELAY.10, RLPORT.1
QH*: 74HC595.9 (QH*), EXTOUT1.7
RL: JP3.9, Q1.1 (B), RQ.1, U$2.10 (10-RX)
RS: JP3.10, RP.1, RR.2, U$2.8 (8-TX)
SCL: DS1307.6 (SCL), JP2.11, PCF8591.10 (SCL), U$2.5 (5-SCL0)
SDA: DS1307.5 (SDA), JP2.12, PCF8591.9 (SDA), U$2.3 (3-SDA0)
VCC: 74HC595.10 (SCL), 74HC595.16 (VCC), C3.1, C5.1, EXTOUT1.8, JP2.13, JP6.1, JP6.2, JP6.3, JP6.4, JP6.5, PCF8591.14 (VREF), PCF8591.16 (VDD), ROE.2, RP.2, U$2.1 (1-+3V3)
VIN: C4.1, D3.C, DF.C, DS1307.8 (VCC), F2.2, JP3.12, JP3.13, LED.A, RELAY.2, U$2.2 (2-+5V), U$2.4 (4-DNC)
VIN_PRE: C0.1, C2.+, F2.1, L1.2, L1'.2, LM2596.4 (FB)

Notes on the sheet:
Power Supply
Valve Driver
Data
Clock
Latch
330x4 Isolated ResNet
!OE
RTC

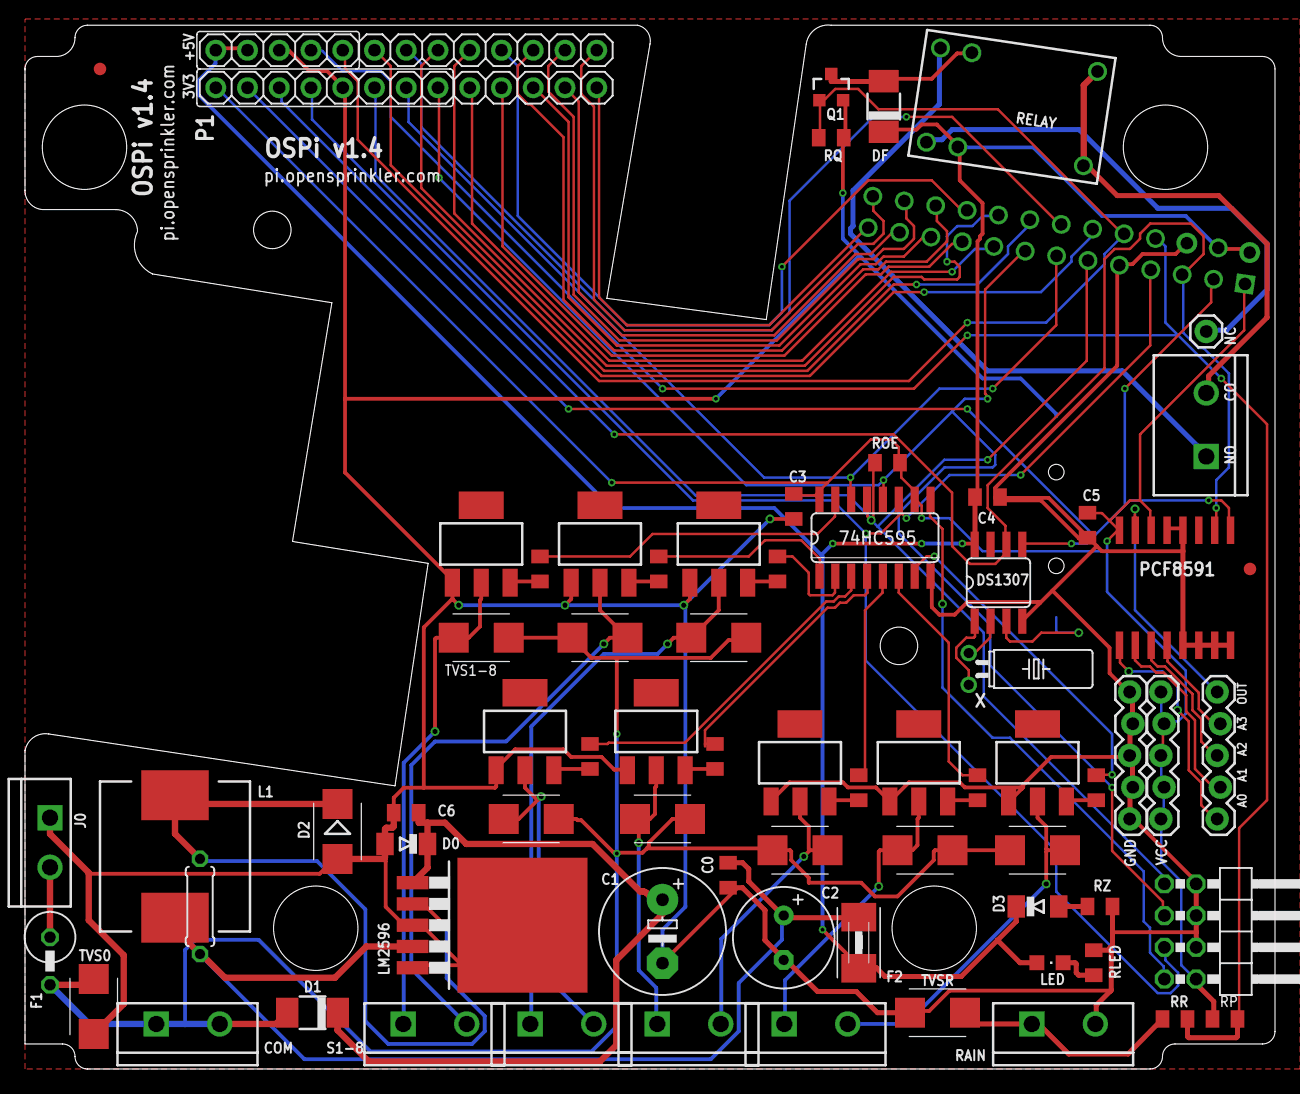
[picture p37: board ospi_v14.brd from above]

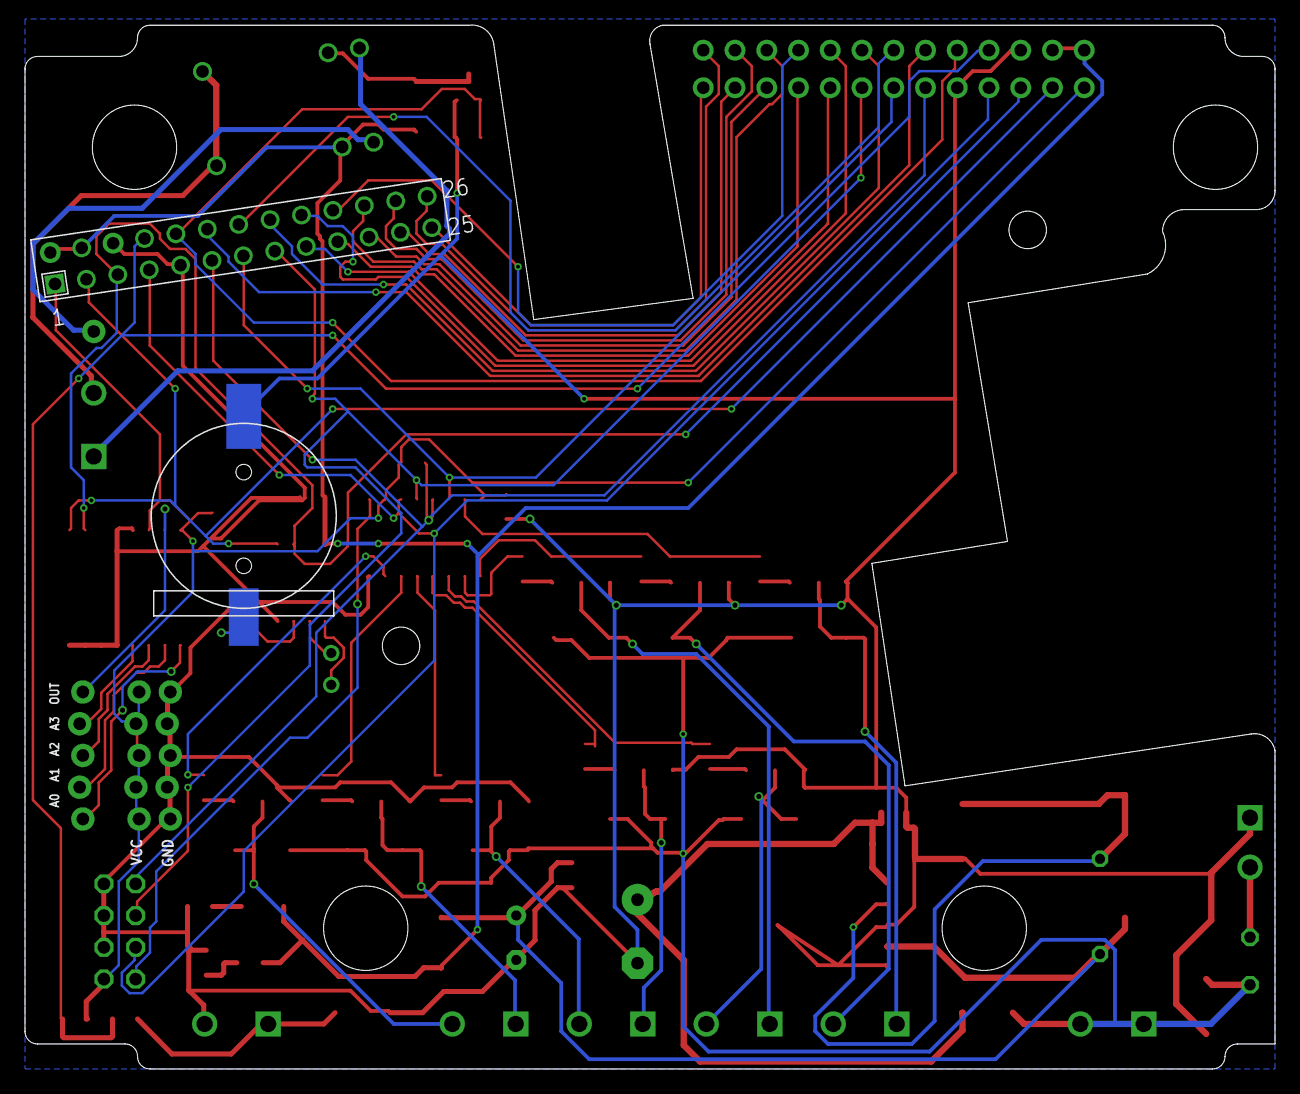
[picture p38: board ospi_v14.brd from below]

Board: 2 copper layers, 100.0 x 83.5 mm, 75 parts (2 on the bottom side), 69 nets.
