rayshobby/opensprinkler/Expansion Board/exp20.brd

## EAGLE design Expansion Board/exp20.brd (2014-06-09)

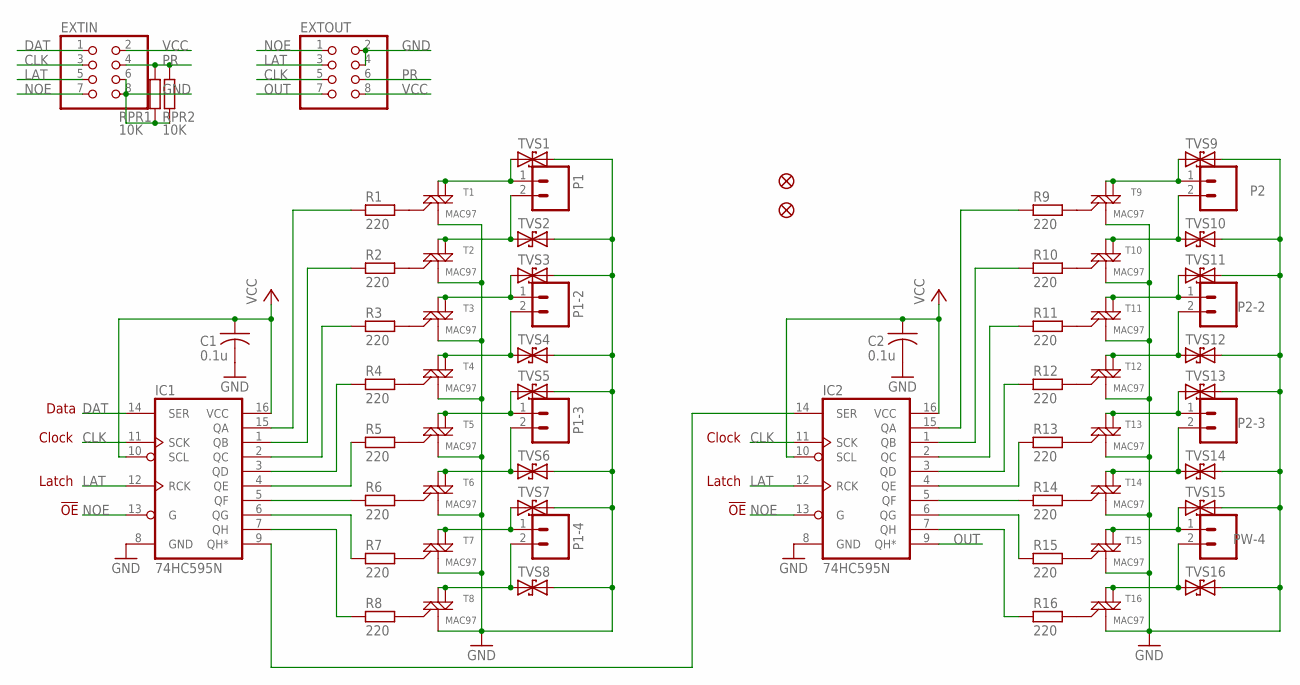
[picture p39: schematic exp20.sch]

Parts:
C1, C2: 0.1u; C0805K
EXTIN: PINHD-2X4/90; 2X04/90
EXTOUT: PINHD-2X4/90; 2X04/90
IC1, IC2: 74HC595N; SO16
JP1, JP2: FIDUCIAL1X2; FIDUCIAL-1X2
P1, P1-2, P1-3, P1-4, P2, P2-2, P2-3: M025MM-X; SCREWTERMINAL-5MM-2-X
PW-4: M025MM-X; SCREWTERMINAL-5MM-2-X
R1, R2, R3, R4, R5, R6, R7, R8, R9, R10, R11, R12, R13, R14, R15, R16: 220; R0805
RPR1, RPR2: 10K; R0805
T1, T2, T3, T4, T5, T6, T7, T8, T9, T10, T11, T12, T13, T14, T15, T16: MAC97; SOT223
TVS1, TVS2, TVS3, TVS4, TVS5, TVS6, TVS7, TVS8, TVS9, TVS10, TVS11, TVS12, TVS13, TVS14, TVS15, TVS16: TVSSMB; SMB

Connections:
CLK: EXTIN.3, EXTOUT.5, IC1.11 (SCK), IC2.11 (SCK)
DAT: EXTIN.1, IC1.14 (SER)
GND: C1.2, C2.2, EXTIN.6, EXTIN.8, EXTOUT.2, EXTOUT.4, IC1.8 (GND), IC2.8 (GND), RPR1.1, RPR2.1, T1.1 (M1), T2.1 (M1), T3.1 (M1), T4.1 (M1), T5.1 (M1), T6.1 (M1), T7.1 (M1), T8.1 (M1), T9.1 (M1), T10.1 (M1), T11.1 (M1), T12.1 (M1), T13.1 (M1), T14.1 (M1), T15.1 (M1), T16.1 (M1), TVS1.C (2), TVS2.C (2), TVS3.C (2), TVS4.C (2), TVS5.C (2), TVS6.C (2), TVS7.C (2), TVS8.C (2), TVS9.C (2), TVS10.C (2), TVS11.C (2), TVS12.C (2), TVS13.C (2), TVS14.C (2), TVS15.C (2), TVS16.C (2)
LAT: EXTIN.5, EXTOUT.3, IC1.12 (RCK), IC2.12 (RCK)
unnamed: P1.1, T1.2 (M2), T1.4 (M2-4), TVS1.A (1)
unnamed: P1-2.1, T3.2 (M2), T3.4 (M2-4), TVS3.A (1)
unnamed: P1-3.1, T5.2 (M2), T5.4 (M2-4), TVS5.A (1)
unnamed: IC1.5 (QF), R6.2
unnamed: IC1.6 (QG), R7.2
unnamed: P1-4.1, T7.2 (M2), T7.4 (M2-4), TVS7.A (1)
unnamed: IC1.7 (QH), R8.2
unnamed: R1.1, T1.3 (G)
unnamed: R2.1, T2.3 (G)
unnamed: IC1.4 (QE), R5.2
unnamed: IC1.3 (QD), R4.2
unnamed: IC1.2 (QC), R3.2
unnamed: IC1.1 (QB), R2.2
unnamed: IC1.15 (QA), R1.2
unnamed: R3.1, T3.3 (G)
unnamed: R4.1, T4.3 (G)
unnamed: P1.2, T2.2 (M2), T2.4 (M2-4), TVS2.A (1)
unnamed: R5.1, T5.3 (G)
unnamed: R6.1, T6.3 (G)
unnamed: P1-2.2, T4.2 (M2), T4.4 (M2-4), TVS4.A (1)
unnamed: R7.1, T7.3 (G)
unnamed: R8.1, T8.3 (G)
unnamed: P1-3.2, T6.2 (M2), T6.4 (M2-4), TVS6.A (1)
unnamed: IC2.5 (QF), R14.2
unnamed: P1-4.2, T8.2 (M2), T8.4 (M2-4), TVS8.A (1)
unnamed: IC2.6 (QG), R15.2
unnamed: IC2.7 (QH), R16.2
unnamed: IC2.4 (QE), R13.2
unnamed: IC2.3 (QD), R12.2
unnamed: IC2.2 (QC), R11.2
unnamed: IC2.1 (QB), R10.2
unnamed: IC2.15 (QA), R9.2
unnamed: P2.2, T10.2 (M2), T10.4 (M2-4), TVS10.A (1)
unnamed: P2-2.2, T12.2 (M2), T12.4 (M2-4), TVS12.A (1)
unnamed: P2-3.2, T14.2 (M2), T14.4 (M2-4), TVS14.A (1)
unnamed: PW-4.2, T16.2 (M2), T16.4 (M2-4), TVS16.A (1)
unnamed: P2.1, T9.2 (M2), T9.4 (M2-4), TVS9.A (1)
unnamed: P2-2.1, T11.2 (M2), T11.4 (M2-4), TVS11.A (1)
unnamed: P2-3.1, T13.2 (M2), T13.4 (M2-4), TVS13.A (1)
unnamed: PW-4.1, T15.2 (M2), T15.4 (M2-4), TVS15.A (1)
unnamed: R9.1, T9.3 (G)
unnamed: R10.1, T10.3 (G)
unnamed: R11.1, T11.3 (G)
unnamed: R12.1, T12.3 (G)
unnamed: R13.1, T13.3 (G)
unnamed: R14.1, T14.3 (G)
unnamed: R15.1, T15.3 (G)
unnamed: R16.1, T16.3 (G)
unnamed: IC1.9 (QH*), IC2.14 (SER)
NOE: EXTIN.7, EXTOUT.1, IC1.13 (G), IC2.13 (G)
OUT: EXTOUT.7, IC2.9 (QH*)
PR: EXTIN.4, EXTOUT.6, RPR1.2, RPR2.2
VCC: C1.1, C2.1, EXTIN.2, EXTOUT.8, IC1.10 (SCL), IC1.16 (VCC), IC2.10 (SCL), IC2.16 (VCC)

Notes on the sheet:
Data
Clock
Latch
!OE

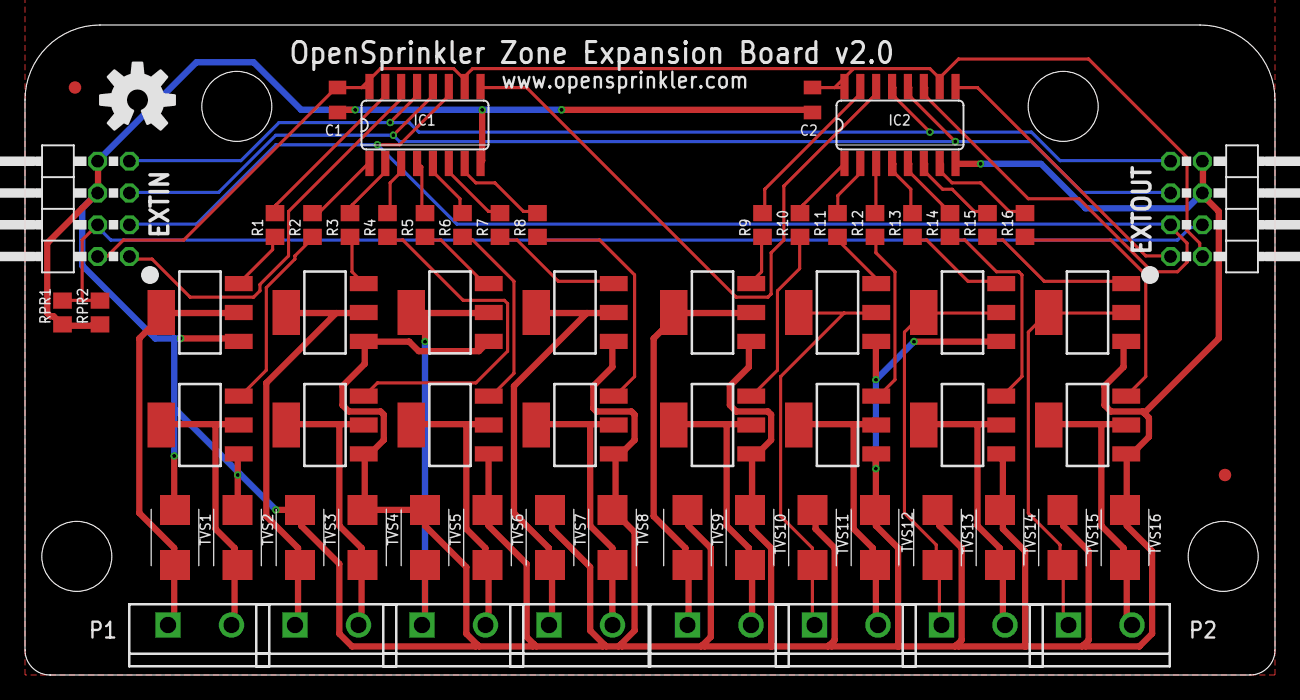
[picture p40: board exp20.brd from above]

Board: 2 copper layers, 100.0 x 52.0 mm, 66 parts (0 on the bottom side), 57 nets.
