rayshobby/opensprinkler/OpenSprinkler Controller/hardware/v2.1/diy/os21_diy.brd

## EAGLE design OpenSprinkler Controller/hardware/v2.1/diy/os21_diy.brd (2014-02-24, an earlier design)

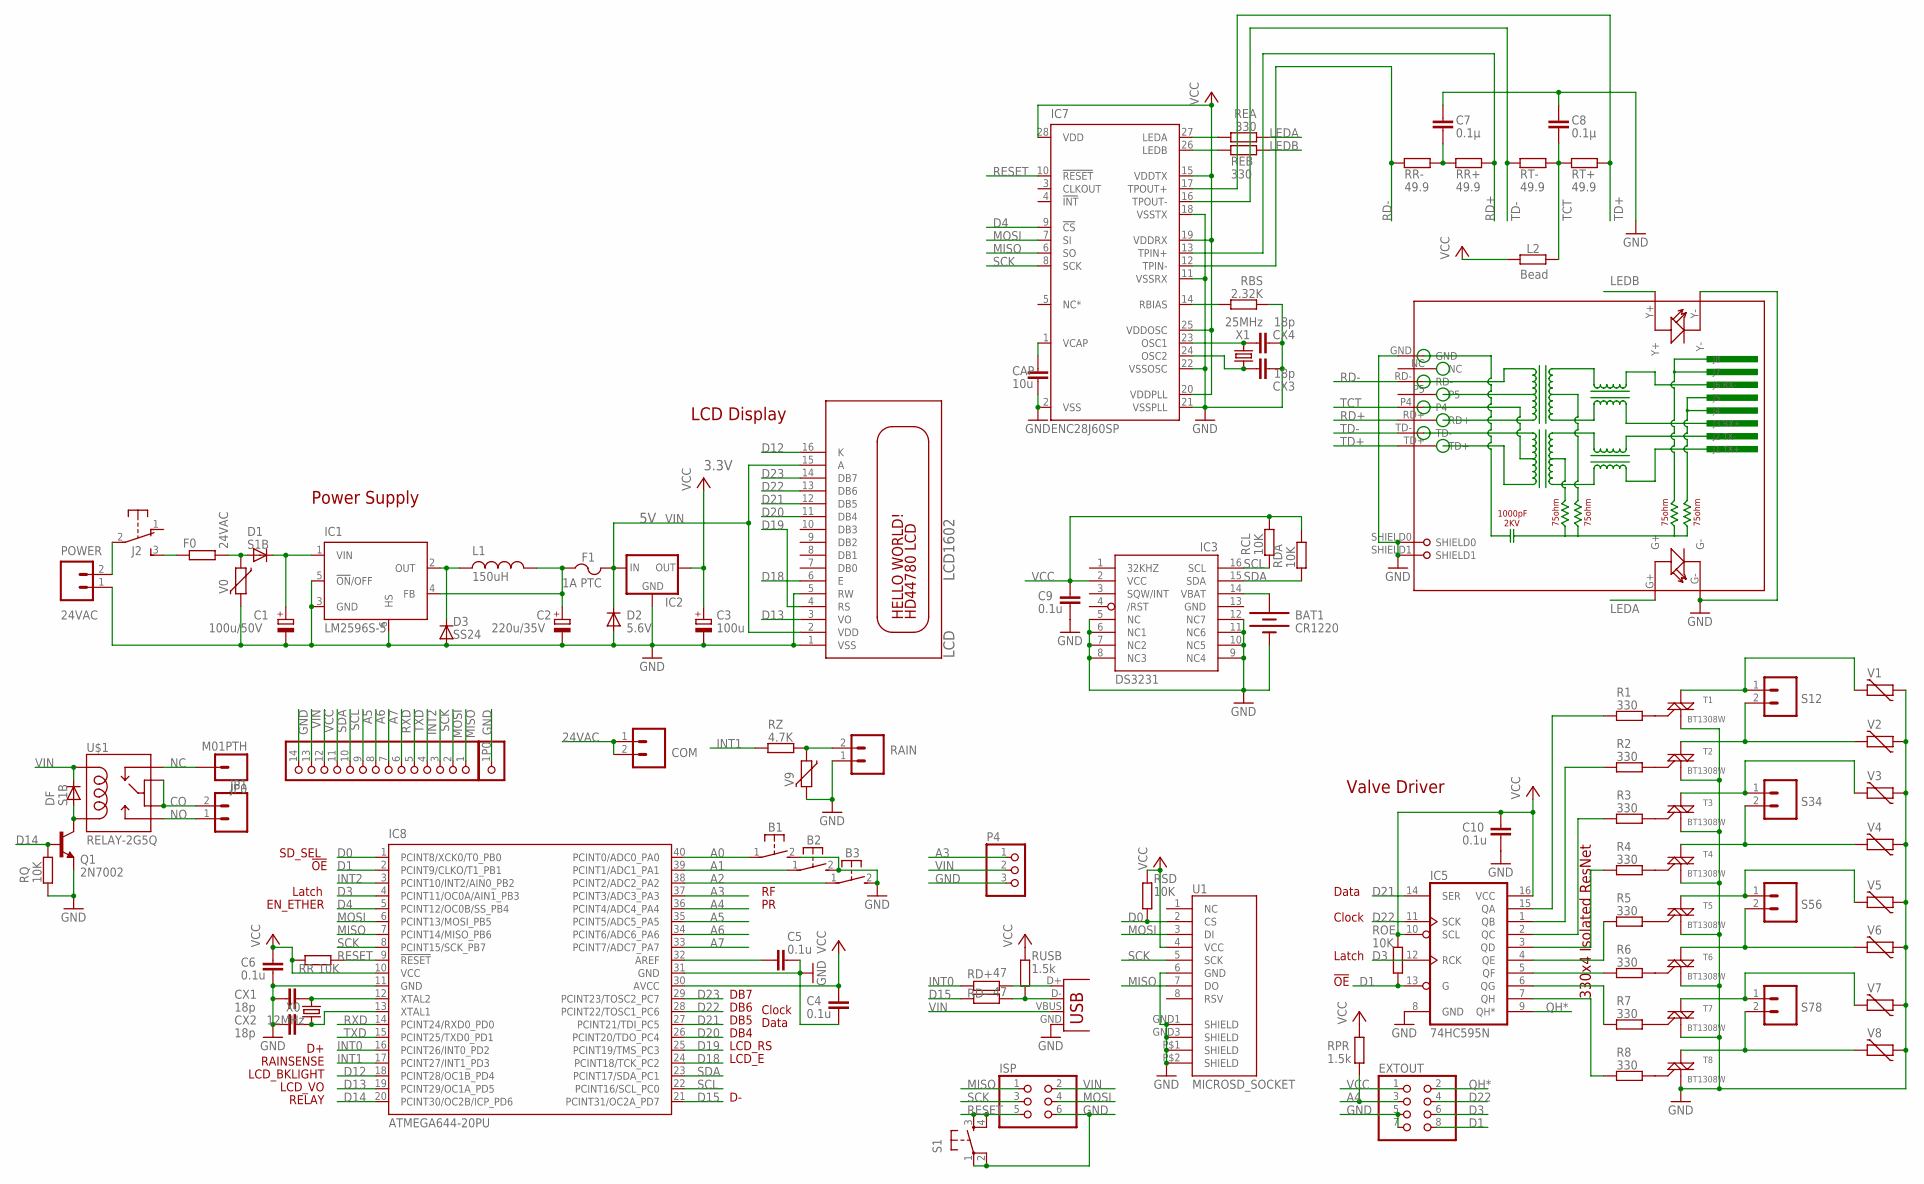
[picture p41: schematic os21_diy.sch]

Parts:
B1, B2, B3: 31-XX; B3F-31XX
BAT1: CR1220; BATTCON_12MM_SMT
C1: 100u/50V; E3,5-8
C2: 220u/35V; E3,5-8
C3: 100u; E2-5
C4, C5, C6, C9, C10: 0.1u; C0805
C7, C8: 0.1µ; C0805
CAP: 10u; C0805
COM: M025MM-X; SCREWTERMINAL-5MM-2-X
CX1, CX2, CX3, CX4: 18p; C0805
D1: S1B; DO-214AC
D2: 5.6V; MINIMELF
D3: SS24; DO-214AC
DF: S1B; DO-214AC
EXTOUT: PINHD-2X4; 2X04
F0: R-EU_0411/3V; 0411V
F1: 1A PTC; 1812
IC1: LM2596S-5; TO263-5
IC2: MCP1700SOT233; SOT23
IC3: DS3231/SO; SO16W
IC5: 74HC595N; SO16
IC7: ENC28J60SP; DIL28-3
IC8: ATMEGA644-20PU; DIL40
ISP: PINHD-2X3; 2X03
J2: EG1206
JP0: M01PTH; 1X01
JP1: M025MM-X; SCREWTERMINAL-5MM-2-X
L1: 150uH; CDRH125
L2: Bead; R0805
LCD: LCD1602; LCD1602A
P0: PINHD-1X14-CB; 1X14-CB
P1: PINHD-1X1CB; 1X01-CLEANBIG
P4: PINHD-1X3; 1X03
POWER: 24VAC; SCREWTERMINAL-4MM-2-X
Q1: 2N7002; SOT23-3
R1, R2, R3, R4, R5, R6, R7, R8: 330; R0805
RAIN: M025MM-X; SCREWTERMINAL-5MM-2-X
RBS: 2.32K; R0805
RCL: 10K; R0805
RD+: 47; R0805
RD-: 47; R0805
RDA: 10K; R0805
REA: 330; R0805
REB: 330; R0805
RJ45: HR911105A
ROE: 10K; R0805
RPR: 1.5k; R0805
RQ: 10K; R0805
RR: 10K; R0805
RR+: 49.9; R0805
RR-: 49.9; R0805
RSD: 10K; R0805
RT+: 49.9; R0805
RT-: 49.9; R0805
RUSB: 1.5k; R0805
RZ: 4.7K; R0805
S1: TAC_SWITCHSMD; TACTILE_SWITCH_SMD
S12, S34, S56, S78: M025MM-X; SCREWTERMINAL-5MM-2-X
T1, T2, T3, T4, T5, T6, T7, T8: BT1308W; TO-92
U1: MICROSD_SOCKET; MICRO-SD-SOCKET-TAOBAO
U$1: RELAY-2G5Q; RELAY-G5V
USB: USBPTH; USB-B-PTH
V0, V1, V2, V3, V4, V5, V6, V7, V8, V9: MOV; R-5
X0: 12MHz; HC49U-V
X1: 25MHz; HC49U-V

Connections:
24VAC: COM.1, COM.2, D1.A, F0.2, V0.1
A0: B1.1, IC8.40 (PCINT0/ADC0_PA0)
A1: B2.1, IC8.39 (PCINT1/ADC1_PA1)
A2: B3.1, IC8.38 (PCINT2/ADC2_PA2)
A3: IC8.37 (PCINT3/ADC3_PA3), P4.1
A4: EXTOUT.3, IC8.36 (PCINT4/ADC4_PA4), RPR.1
A5: IC8.35 (PCINT5/ADC5_PA5), P0.9
A6: IC8.34 (PCINT6/ADC6_PA6), P0.8
A7: IC8.33 (PCINT7/ADC7_PA7), P0.7
AREF: C5.1, IC8.32 (AREF)
CO: JP1.2, U$1.5, U$1.6
D0: IC8.1 (PCINT8/XCK0/T0_PB0), RSD.1, U1.2 (CS)
D1: EXTOUT.8, IC5.13 (G), IC8.2 (PCINT9/CLKO/T1_PB1), ROE.1
D3: EXTOUT.6, IC5.12 (RCK), IC8.4 (PCINT11/OC0A/AIN1_PB3)
D4: IC7.9 (!CS), IC8.5 (PCINT12/OC0B/SS_PB4)
D12: IC8.18 (PCINT28/OC1B_PD4), LCD.16 (K)
D13: IC8.19 (PCINT29/OC1A_PD5), LCD.3 (VO)
D14: IC8.20 (PCINT30/OC2B/ICP_PD6), Q1.1 (B), RQ.1
D15: IC8.21 (PCINT31/OC2A_PD7), RD-.1
D18: IC8.24 (PCINT18/TCK_PC2), LCD.6 (E)
D19: IC8.25 (PCINT19/TMS_PC3), LCD.4 (RS)
D20: IC8.26 (PCINT20/TDO_PC4), LCD.11 (DB4)
D21: IC5.14 (SER), IC8.27 (PCINT21/TDI_PC5), LCD.12 (DB5)
D22: EXTOUT.4, IC5.11 (SCK), IC8.28 (PCINT22/TOSC1_PC6), LCD.13 (DB6)
D23: IC8.29 (PCINT23/TOSC2_PC7), LCD.14 (DB7)
GND: B1.2 (S), B2.2 (S), B3.2 (S), BAT1.P$1 (-), C1.-, C2.-, C3.-, C4.2, C5.2, C6.2, C7.1, C8.1, C9.2, C10.2, CAP.2, CX1.2, CX2.2, CX3.2, CX4.2, D2.A, D3.A, EXTOUT.5, EXTOUT.7, IC1.3 (GND), IC1.5 (!ON!/OFF), IC1.6 (HS), IC2.1 (GND), IC3.5 (NC), IC3.6 (NC1), IC3.7 (NC2), IC3.8 (NC3), IC3.9 (NC4), IC3.10 (NC5), IC3.11 (NC6), IC3.12 (NC7), IC3.13 (GND), IC5.8 (GND), IC7.2 (VSS), IC7.11 (VSSRX), IC7.18 (VSSTX), IC7.21 (VSSPLL), IC7.22 (VSSOSC), IC8.11 (GND), IC8.31 (GND), ISP.6, LCD.1 (VSS), LCD.5 (RW), P0.14, P1.1, P4.3, POWER.1, Q1.2 (E), RAIN.1, RBS.2, RJ45.G-, RJ45.GND, RJ45.SHIELD0, RJ45.SHIELD1, RJ45.Y-, RQ.2, S1.1, S1.2, T1.1 (M1), T2.1 (M1), T3.1 (M1), T4.1 (M1), T5.1 (M1), T6.1 (M1), T7.1 (M1), T8.1 (M1), U1.6 (GND), U1.GND1 (SHIELD), U1.GND3 (SHIELD), U1.P$1 (SHIELD), U1.P$2 (SHIELD), USB.GND, V0.2, V1.1, V2.1, V3.1, V4.1, V5.1, V6.1, V7.1, V8.1, V9.2
INT0: IC8.16 (PCINT26/INT0_PD2), RD+.1
INT1: IC8.17 (PCINT27/INT1_PD3), RZ.2
INT2: IC8.3 (PCINT10/INT2/AIN0_PB2), P0.4
LEDA: REA.2, RJ45.G+
LEDB: REB.2, RJ45.Y+
MISO: IC7.6 (SO), IC8.7 (PCINT14/MISO_PB6), ISP.1, P0.1, U1.7 (DO)
MOSI: IC7.7 (SI), IC8.6 (PCINT13/MOSI_PB5), ISP.4, P0.2, U1.3 (DI)
unnamed: C1.+, D1.C, IC1.1 (VIN)
unnamed: C2.+, F1.1, IC1.4 (FB), L1.2
unnamed: R1.1, T1.2 (G)
unnamed: IC5.5 (QF), R6.2
unnamed: IC5.6 (QG), R7.2
unnamed: J2.2, POWER.2
unnamed: IC5.7 (QH), R8.2
unnamed: BAT1.P$2 (+), IC3.14 (VBAT)
unnamed: D3.C, IC1.2 (OUT), L1.1
unnamed: IC5.4 (QE), R5.2
unnamed: IC5.3 (QD), R4.2
unnamed: IC5.2 (QC), R3.2
unnamed: IC5.1 (QB), R2.2
unnamed: IC5.15 (QA), R1.2
unnamed: R2.1, T2.2 (G)
unnamed: S12.1, T1.3 (M2), V1.2
unnamed: S12.2, T2.3 (M2), V2.2
unnamed: S34.1, T3.3 (M2), V3.2
unnamed: IC7.14 (RBIAS), RBS.1
unnamed: S34.2, T4.3 (M2), V4.2
unnamed: R3.1, T3.2 (G)
unnamed: S56.1, T5.3 (M2), V5.2
unnamed: S56.2, T6.3 (M2), V6.2
unnamed: S78.1, T7.3 (M2), V7.2
unnamed: S78.2, T8.3 (M2), V8.2
unnamed: R4.1, T4.2 (G)
unnamed: R5.1, T5.2 (G)
unnamed: R6.1, T6.2 (G)
unnamed: R7.1, T7.2 (G)
unnamed: RAIN.2, RZ.1, V9.1
unnamed: F0.1, J2.3 (S)
unnamed: CAP.1, IC7.1 (VCAP)
unnamed: IC7.27 (LEDA), REA.1
unnamed: DF.A, Q1.3 (C), U$1.9
unnamed: IC7.26 (LEDB), REB.1
unnamed: RD+.2, USB.D+
unnamed: CX3.1, IC7.24 (OSC2), X1.2
unnamed: CX4.1, IC7.23 (OSC1), X1.1
unnamed: R8.1, T8.2 (G)
unnamed: RD-.2, RUSB.1, USB.D-
unnamed: CX1.1, IC8.12 (XTAL2), X0.2
unnamed: CX2.1, IC8.13 (XTAL1), X0.1
unnamed: C7.2, RR+.1, RR-.2
NC: JP0.1, U$1.1
NO: JP1.1, U$1.10
QH*: EXTOUT.2, IC5.9 (QH*)
RD+: IC7.13 (TPIN+), RJ45.RD+, RR+.2
RD-: IC7.12 (TPIN-), RJ45.RD-, RR-.1
RESET: IC7.10 (!RESET), IC8.9 (!RESET), ISP.5, RR.2, S1.3, S1.4
RXD: IC8.14 (PCINT24/RXD0_PD0), P0.6
SCK: IC7.8 (SCK), IC8.8 (PCINT15/SCK_PB7), ISP.3, P0.3, U1.5 (SCK)
SCL: IC3.16 (SCL), IC8.22 (PCINT16/SCL_PC0), P0.10, RCL.2
SDA: IC3.15 (SDA), IC8.23 (PCINT17/SDA_PC1), P0.11, RDA.2
TCT: C8.2, L2.1, RJ45.P4, RT+.1, RT-.2
TD+: IC7.17 (TPOUT+), RJ45.TD+, RT+.2
TD-: IC7.16 (TPOUT-), RJ45.TD-, RT-.1
TXD: IC8.15 (PCINT25/TXD0_PD1), P0.5
VCC: C3.+, C4.1, C6.1, C9.1, C10.1, EXTOUT.1, IC2.2 (OUT), IC3.2 (VCC), IC5.10 (SCL), IC5.16 (VCC), IC7.15 (VDDTX), IC7.19 (VDDRX), IC7.20 (VDDPLL), IC7.25 (VDDOSC), IC7.28 (VDD), IC8.10 (VCC), IC8.30 (AVCC), L2.2, P0.12, RCL.1, RDA.1, ROE.2, RPR.2, RR.1, RSD.2, RUSB.2, U1.4 (VCC)
VIN: D2.C, DF.C, F1.2, IC2.3 (IN), ISP.2, LCD.2 (VDD), LCD.15 (A), P0.13, P4.2, U$1.2, USB.VBUS

Notes on the sheet:
Power Supply
Valve Driver
Data
Clock
Latch
DB4
330x4 Isolated ResNet
LCD Display
EN_ETHER
3.3V
DB7
LCD_E
LCD_RS
DB6
DB5
!OE
RAINSENSE
LCD_BKLIGHT
LCD_VO
SD_SEL
RELAY

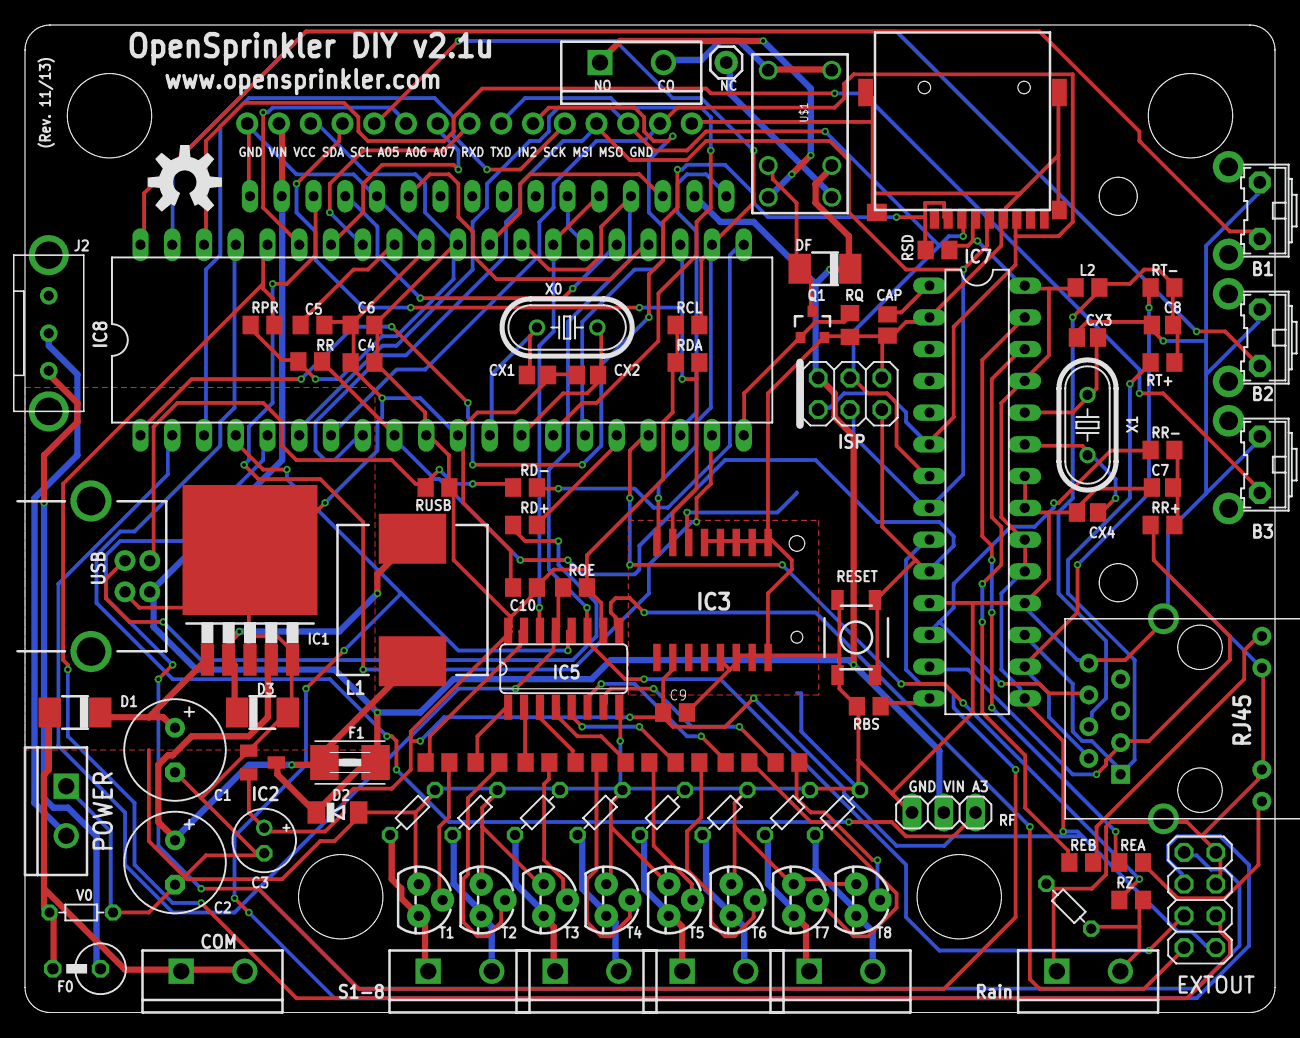
[picture p42: board os21_diy.brd from above]

Board: 2 copper layers, 100.0 x 79.0 mm, 101 parts (1 on the bottom side), 92 nets.
