rayshobby/opensprinkler/OpenSprinkler Pi/hardware/ospi_v12.brd

## EAGLE design OpenSprinkler Pi/hardware/ospi_v12.brd (2013-07-08, an earlier design)

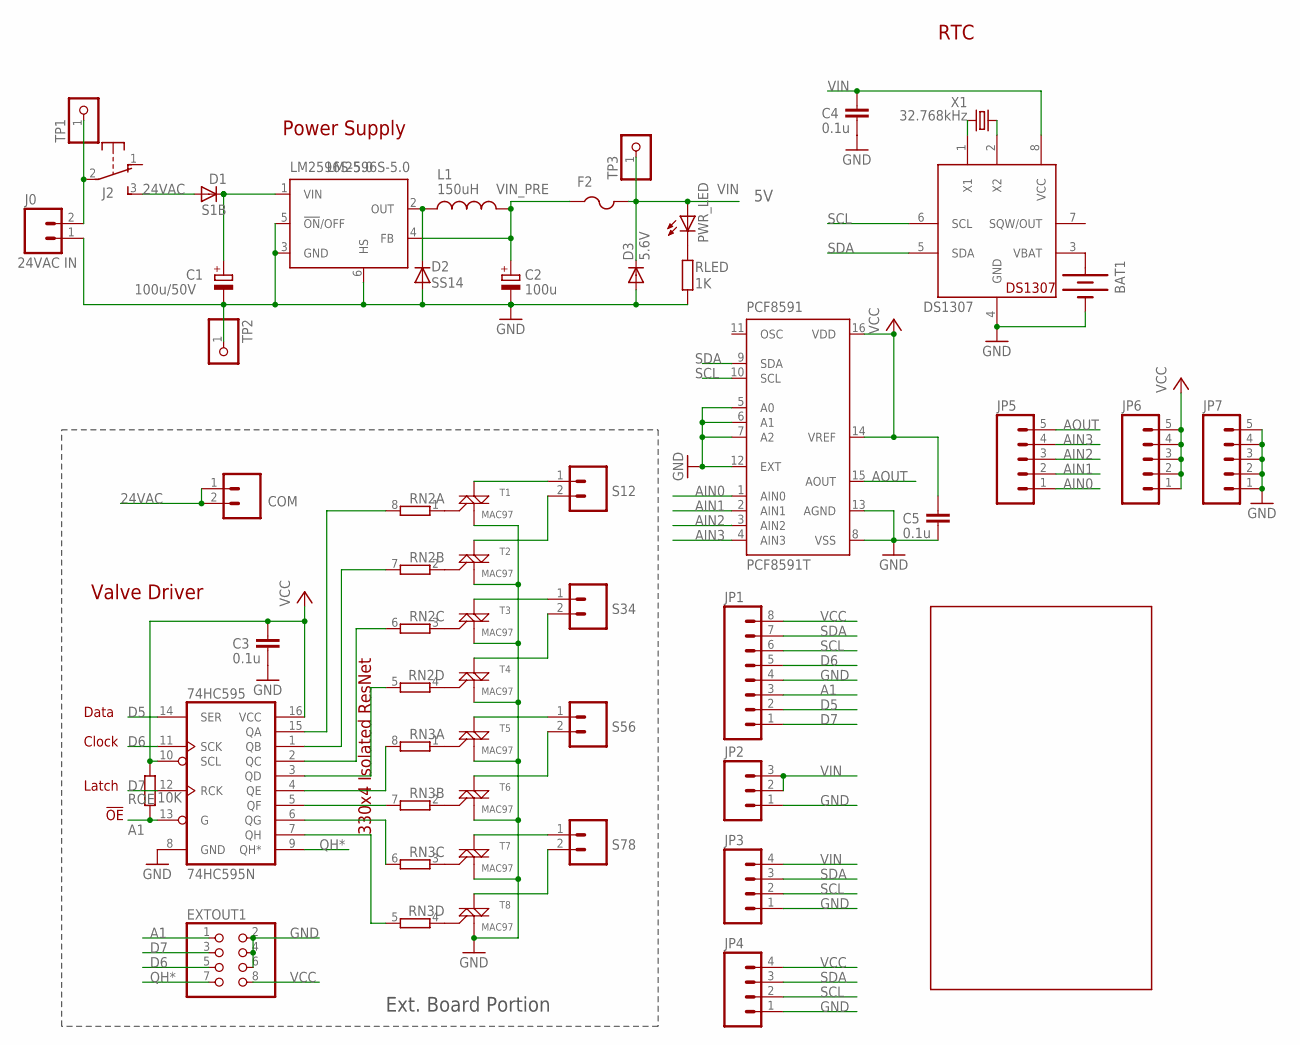
[picture p43: schematic ospi_v12.sch]

Parts:
74HC595: 74HC595N; SO16
BAT1: BATTERYBATTERY_12MM_SMT; BATTCON_12MM_SMT
C1: 100u/50V; PANASONIC_E
C2: 100u; PANASONIC_E
C3, C4, C5: 0.1u; C0805
COM: M025MM; SCREWTERMINAL-5MM-2
D1: S1B; DO-214AC
D2: SS14; DO-214AC
D3: 5.6V; MINIMELF
DS1307: DS1307; SO08
EXTOUT1: PINHD-2X4/90; 2X04/90
F2: PTCFUSE-1812; 1812
J0: 24VAC IN; SCREWTERMINAL-5MM-2
J2: EG1206
JP1: M08LOCK; 1X08_LOCK
JP2: M03LOCK; 1X03_LOCK
JP3, JP4: M04LOCK; 1X04_LOCK
JP5, JP6, JP7: M05LOCK; 1X05_LOCK
L1: 150uH; CDRH125
LM2596S-5.0: LM2596S-5.0; TO263-5
PCF8591: PCF8591T; SO16W
PWR_LED: LEDCHIPLED_0805; CHIPLED_0805
RLED: 1K; R0805
RN2, RN3: 4R-NEXB38V; EXB38V
ROE: 10K; R0805
S12, S34, S56, S78: M025MM; SCREWTERMINAL-5MM-2
T1, T2, T3, T4, T5, T6, T7, T8: MAC97; SOT223
TP1, TP2, TP3: PINHD-1X1CB; 1X01-CLEANBIG
U$2: OSPI
X1: 32.768kHz; MM20SS

Connections:
24VAC: COM.1, COM.2, D1.A, J2.3 (S)
A1: 74HC595.13 (G), EXTOUT1.1, JP1.3, ROE.1
AIN0: JP5.1, PCF8591.1 (AIN0)
AIN1: JP5.2, PCF8591.2 (AIN1)
AIN2: JP5.3, PCF8591.3 (AIN2)
AIN3: JP5.4, PCF8591.4 (AIN3)
AOUT: JP5.5, PCF8591.15 (AOUT)
D5: 74HC595.14 (SER), JP1.2
D6: 74HC595.11 (SCK), EXTOUT1.5, JP1.5
D7: 74HC595.12 (RCK), EXTOUT1.3, JP1.1
GND: 74HC595.8 (GND), BAT1.P$1 (-), C1.-, C2.-, C3.2, C4.2, C5.2, D2.A, D3.A, DS1307.4 (GND), EXTOUT1.2, EXTOUT1.4, EXTOUT1.6, J0.1, JP1.4, JP2.1, JP3.1, JP4.1, JP7.1, JP7.2, JP7.3, JP7.4, JP7.5, LM2596S-5.0.3 (GND), LM2596S-5.0.5 (!ON!/OFF), LM2596S-5.0.6 (HS), PCF8591.5 (A0), PCF8591.6 (A1), PCF8591.7 (A2), PCF8591.8 (VSS), PCF8591.12 (EXT), PCF8591.13 (AGND), RLED.2, T1.1 (M1), T2.1 (M1), T3.1 (M1), T4.1 (M1), T5.1 (M1), T6.1 (M1), T7.1 (M1), T8.1 (M1), TP2.1
unnamed: PWR_LED.C, RLED.1
unnamed: C1.+, D1.C, LM2596S-5.0.1 (VIN)
unnamed: RN2.1, T1.3 (G)
unnamed: 74HC595.5 (QF), RN3.7 (2)
unnamed: 74HC595.6 (QG), RN3.6 (2)
unnamed: J0.2, J2.2, TP1.1
unnamed: 74HC595.7 (QH), RN3.5 (2)
unnamed: D2.C, L1.1, LM2596S-5.0.2 (OUT)
unnamed: DS1307.1 (X1), X1.1
unnamed: 74HC595.4 (QE), RN3.8 (2)
unnamed: 74HC595.3 (QD), RN2.5 (2)
unnamed: 74HC595.2 (QC), RN2.6 (2)
unnamed: 74HC595.1 (QB), RN2.7 (2)
unnamed: 74HC595.15 (QA), RN2.8 (2)
unnamed: RN2.2 (1), T2.3 (G)
unnamed: S12.1, T1.4 (M2)
unnamed: S12.2, T2.4 (M2)
unnamed: S34.1, T3.4 (M2)
unnamed: RN2.3 (1), T3.3 (G)
unnamed: S34.2, T4.4 (M2)
unnamed: RN2.4 (1), T4.3 (G)
unnamed: S56.1, T5.4 (M2)
unnamed: S56.2, T6.4 (M2)
unnamed: S78.1, T7.4 (M2)
unnamed: S78.2, T8.4 (M2)
unnamed: RN3.1, T5.3 (G)
unnamed: RN3.2 (1), T6.3 (G)
unnamed: RN3.3 (1), T7.3 (G)
unnamed: RN3.4 (1), T8.3 (G)
unnamed: DS1307.2 (X2), X1.4 (2)
unnamed: BAT1.P$2 (+), DS1307.3 (VBAT)
QH*: 74HC595.9 (QH*), EXTOUT1.7
SCL: DS1307.6 (SCL), JP1.6, JP3.2, JP4.2, PCF8591.10 (SCL)
SDA: DS1307.5 (SDA), JP1.7, JP3.3, JP4.3, PCF8591.9 (SDA)
VCC: 74HC595.10 (SCL), 74HC595.16 (VCC), C3.1, C5.1, EXTOUT1.8, JP1.8, JP4.4, JP6.1, JP6.2, JP6.3, JP6.4, JP6.5, PCF8591.14 (VREF), PCF8591.16 (VDD), ROE.2
VIN: C4.1, D3.C, DS1307.8 (VCC), F2.2, JP2.2, JP2.3, JP3.4, PWR_LED.A, TP3.1
VIN_PRE: C2.+, F2.1, L1.2, LM2596S-5.0.4 (FB)

Notes on the sheet:
Power Supply
Valve Driver
Data
Clock
Latch
330x4 Isolated ResNet
Ext. Board Portion
!OE
RTC

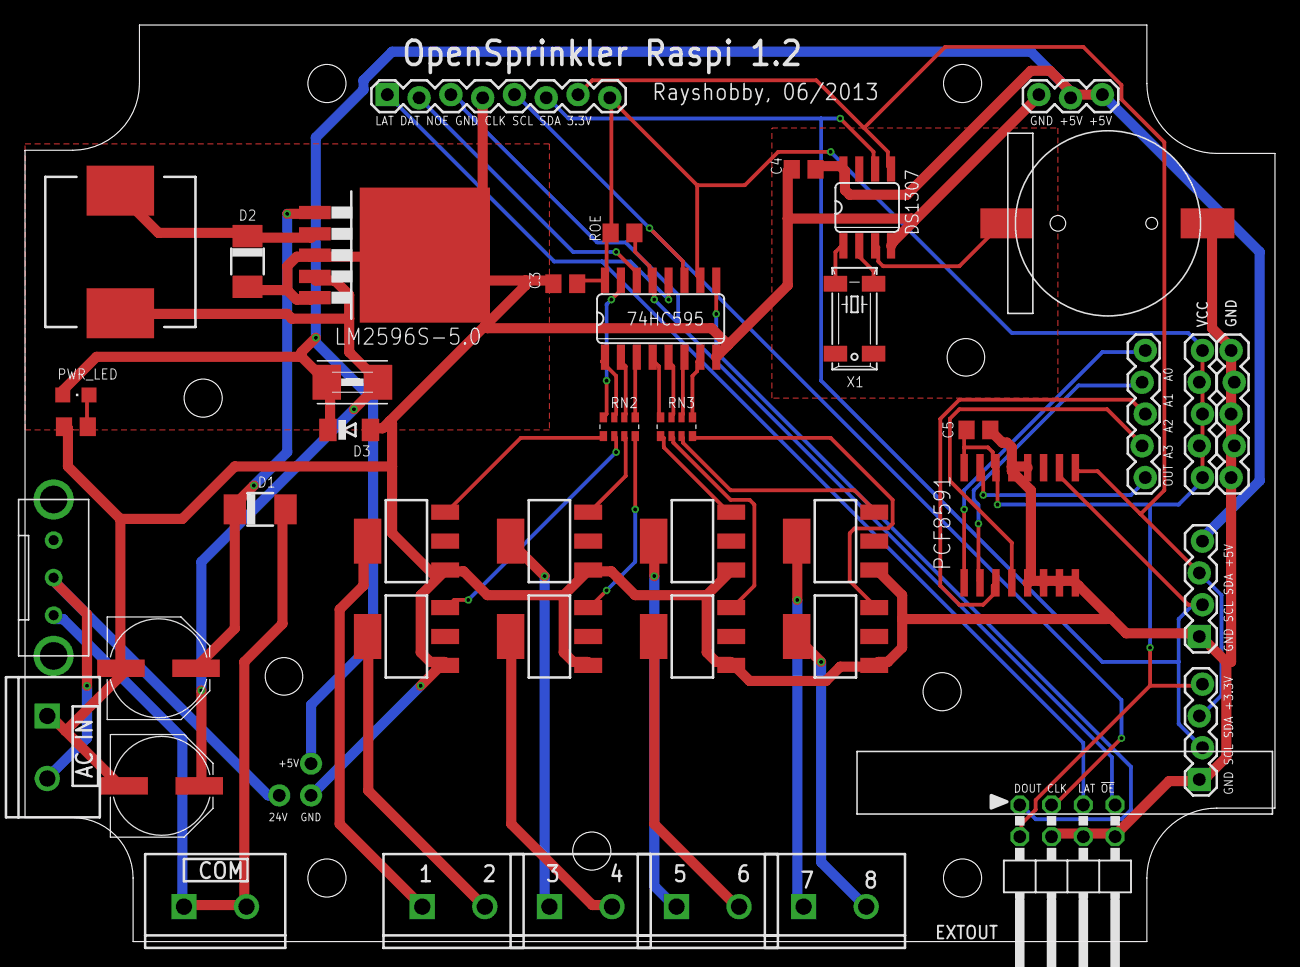
[picture p44: board ospi_v12.brd from above]

Board: 2 copper layers, 99.9 x 73.3 mm, 48 parts (0 on the bottom side), 48 nets.
