rayshobby/opensprinkler/OpenSprinkler Controller/hardware/v2.0/smt/os20.newenc.brd

## EAGLE design OpenSprinkler Controller/hardware/v2.0/smt/os20.newenc.brd (2013-04-28, an earlier design)

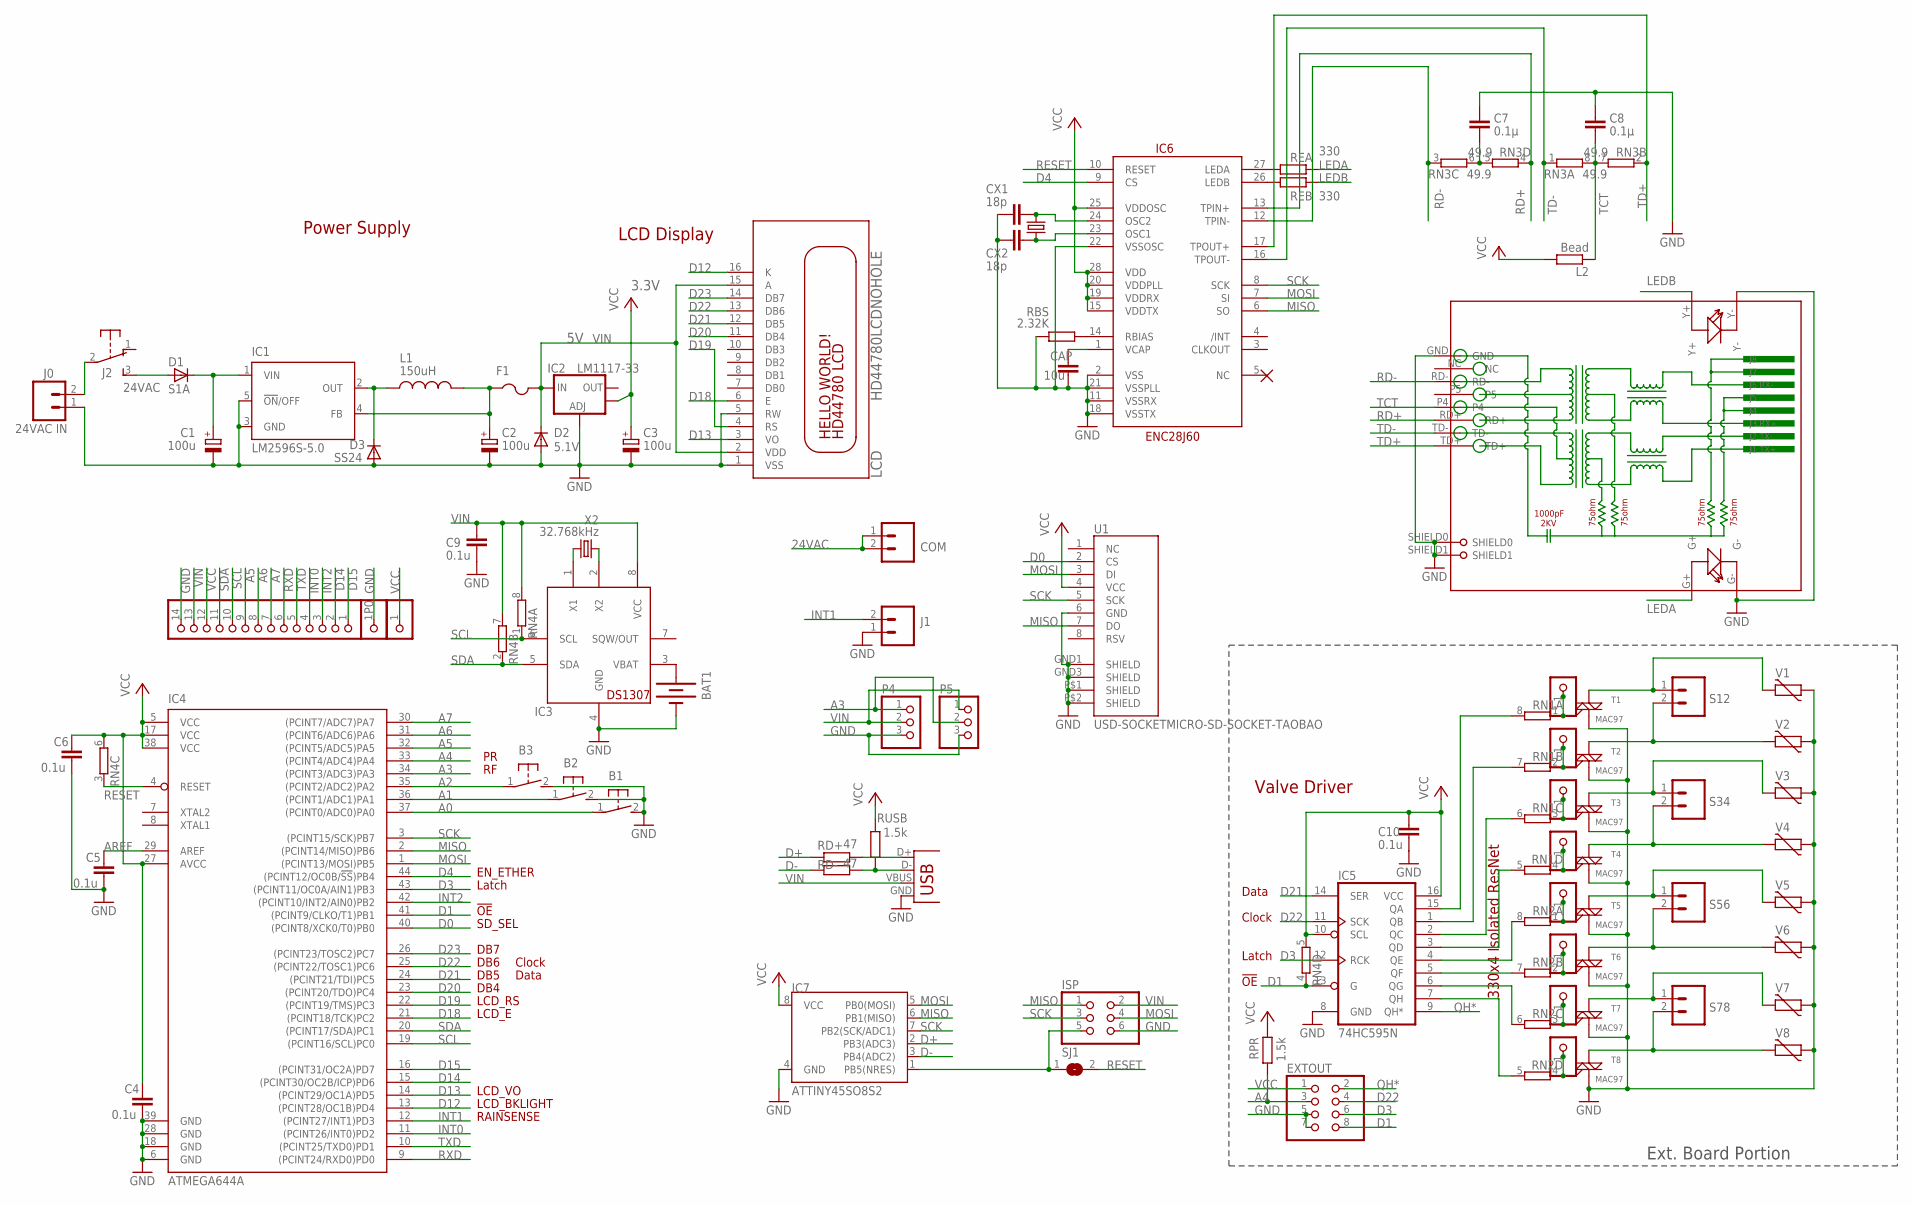
[picture p45: schematic os20.newenc.sch]

Parts:
B1, B2, B3: 31-XX; B3F-31XX
BAT1: BATTERYBATTERY_12MM_SMT; BATTCON_12MM_SMT
C1: 100u; E3,5-8
C2, C3: 100u; PANASONIC_D
C4, C5, C6, C9, C10: 0.1u; C0805
C7, C8: 0.1µ; C0805
CAP: 10u; C0805
COM: M025MM; SCREWTERMINAL-5MM-2
CX1, CX2: 18p; C0805
D1: S1A; DO-214AC
D2: 5.1V; MINIMELF
D3: SS24; DO-214AC
EXTOUT: PINHD-2X4; 2X04
F1: PTCFUSE-1812; 1812
IC1: LM2596S-5.0; TO263-5
IC2: LM1117-33; SOT223
IC3: DS1307; SO08
IC4: ATMEGA644A; TQFP44
IC5: 74HC595N; SO16
IC6: ENC28J60; SOIC28WLONG
IC7: ATTINY45SO8S2; SO8S2
ISP: PINHD-2X3; 2X03
J0: 24VAC IN; SCREWTERMINAL-5MM-2
J1: M025MM; SCREWTERMINAL-5MM-2
J2: EG1206
JP2, JP3, JP4, JP5, JP6, JP7, JP8, JP9: PINHD-1X1CB; 1X01-CLEANBIG
L1: 150uH; CDRH125
L2: Bead; R0805
LCD: HD44780LCDNOHOLE; LCD1602A
P0: PINHD-1X14-CB; 1X14-CB
P1, P2: PINHD-1X1CB; 1X01-CLEANBIG
P4, P5: PINHD-1X3; 1X03
RBS: 2.32K; R0805
RD+: 47; R0805
RD-: 47; R0805
REA: 330; R0805
REB: 330; R0805
RJ45: HR911105A
RN1, RN2, RN4: 4R-NEXB38V; EXB38V
RN3: 49.9; EXB38V
RPR: 1.5k; R0805
RUSB: 1.5k; R0805
S12, S34, S56, S78: M025MM; SCREWTERMINAL-5MM-2
SJ1: SJ
T1, T2, T3, T4, T5, T6, T7, T8: MAC97; SOT223
U1: USD-SOCKETMICRO-SD-SOCKET-TAOBAO; MICRO-SD-SOCKET-TAOBAO
USB: USBPTH; USB-B-PTH
V1, V2, V3, V4, V5, V6, V7, V8: MOV; R-5
X1: 25MHz; HC49US
X2: 32.768kHz; TC26H

Connections:
24VAC: COM.1, COM.2, D1.A, J2.3 (S)
A0: B1.1, IC4.37 ((PCINT0/ADC0)PA0)
A1: B2.1, IC4.36 ((PCINT1/ADC1)PA1)
A2: B3.1, IC4.35 ((PCINT2/ADC2)PA2)
A3: IC4.34 ((PCINT3/ADC3)PA3), P4.1, P5.2
A4: EXTOUT.3, IC4.33 ((PCINT4/ADC4)PA4), RPR.1
A5: IC4.32 ((PCINT5/ADC5)PA5), P0.9
A6: IC4.31 ((PCINT6/ADC6)PA6), P0.8
A7: IC4.30 ((PCINT7/ADC7)PA7), P0.7
AREF: C5.1, IC4.29 (AREF)
D0: IC4.40 ((PCINT8/XCK0/T0)PB0), U1.2 (CS)
D1: EXTOUT.8, IC4.41 ((PCINT9/CLKO/T1)PB1), IC5.13 (G), RN4.4 (1)
D3: EXTOUT.6, IC4.43 ((PCINT11/OC0A/AIN1)PB3), IC5.12 (RCK)
D4: IC4.44 ((PCINT12/OC0B/!SS!)PB4), IC6.9 (CS)
D12: IC4.13 ((PCINT28/OC1B)PD4), LCD.16 (K)
D13: IC4.14 ((PCINT29/OC1A)PD5), LCD.3 (VO)
D14: IC4.15 ((PCINT30/OC2B/ICP)PD6), P0.2
D15: IC4.16 ((PCINT31/OC2A)PD7), P0.1
D18: IC4.21 ((PCINT18/TCK)PC2), LCD.6 (E)
D19: IC4.22 ((PCINT19/TMS)PC3), LCD.4 (RS)
D20: IC4.23 ((PCINT20/TDO)PC4), LCD.11 (DB4)
D21: IC4.24 ((PCINT21/TDI)PC5), IC5.14 (SER), LCD.12 (DB5)
D22: EXTOUT.4, IC4.25 ((PCINT22/TOSC1)PC6), IC5.11 (SCK), LCD.13 (DB6)
D23: IC4.26 ((PCINT23/TOSC2)PC7), LCD.14 (DB7)
D+: IC7.2 (PB3(ADC3)), RD+.1
D-: IC7.3 (PB4(ADC2)), RD-.1
GND: B1.2 (S), B2.2 (S), B3.2 (S), BAT1.P$1 (-), C1.-, C2.-, C3.-, C4.2, C5.2, C6.2, C7.1, C8.1, C9.2, C10.2, CAP.2, CX1.2, CX2.2, D2.A, D3.A, EXTOUT.5, EXTOUT.7, IC1.3 (GND), IC1.5 (!ON!/OFF), IC2.1 (ADJ), IC3.4 (GND), IC4.6 (GND), IC4.18 (GND), IC4.28 (GND), IC4.39 (GND), IC5.8 (GND), IC6.2 (VSS), IC6.11 (VSSRX), IC6.18 (VSSTX), IC6.21 (VSSPLL), IC6.22 (VSSOSC), IC7.4 (GND), ISP.6, J0.1, J1.1, LCD.1 (VSS), LCD.5 (RW), P0.14, P1.1, P4.3, P5.3, RBS.1, RJ45.G-, RJ45.GND, RJ45.SHIELD0, RJ45.SHIELD1, RJ45.Y-, T1.1 (M1), T2.1 (M1), T3.1 (M1), T4.1 (M1), T5.1 (M1), T6.1 (M1), T7.1 (M1), T8.1 (M1), U1.6 (GND), U1.GND1 (SHIELD), U1.GND3 (SHIELD), U1.P$1 (SHIELD), U1.P$2 (SHIELD), USB.GND, V1.1, V2.1, V3.1, V4.1, V5.1, V6.1, V7.1, V8.1
INT0: IC4.11 ((PCINT26/INT0)PD2), P0.4
INT1: IC4.12 ((PCINT27/INT1)PD3), J1.2
INT2: IC4.42 ((PCINT10/INT2/AIN0)PB2), P0.3
LEDA: REA.2, RJ45.G+
LEDB: REB.2, RJ45.Y+
MISO: IC4.2 ((PCINT14/MISO)PB6), IC6.6 (SO), IC7.6 (PB1(MISO)), ISP.1, U1.7 (DO)
MOSI: IC4.1 ((PCINT13/MOSI)PB5), IC6.7 (SI), IC7.5 (PB0(MOSI)), ISP.4, U1.3 (DI)
unnamed: C1.+, D1.C, IC1.1 (VIN)
unnamed: C2.+, F1.1, IC1.4 (FB), L1.2
unnamed: JP2.1, RN1.1, T1.3 (G)
unnamed: IC5.5 (QF), RN2.7 (2)
unnamed: IC5.6 (QG), RN2.6 (2)
unnamed: J0.2, J2.2
unnamed: IC5.7 (QH), RN2.5 (2)
unnamed: IC3.1 (X1), X2.2
unnamed: D3.C, IC1.2 (OUT), L1.1
unnamed: IC5.4 (QE), RN2.8 (2)
unnamed: IC5.3 (QD), RN1.5 (2)
unnamed: IC5.2 (QC), RN1.6 (2)
unnamed: IC5.1 (QB), RN1.7 (2)
unnamed: IC5.15 (QA), RN1.8 (2)
unnamed: JP3.1, RN1.2 (1), T2.3 (G)
unnamed: S12.1, T1.4 (M2), V1.2
unnamed: S12.2, T2.4 (M2), V2.2
unnamed: S34.1, T3.4 (M2), V3.2
unnamed: JP4.1, RN1.3 (1), T3.3 (G)
unnamed: S34.2, T4.4 (M2), V4.2
unnamed: JP5.1, RN1.4 (1), T4.3 (G)
unnamed: S56.1, T5.4 (M2), V5.2
unnamed: S56.2, T6.4 (M2), V6.2
unnamed: S78.1, T7.4 (M2), V7.2
unnamed: S78.2, T8.4 (M2), V8.2
unnamed: JP6.1, RN2.1, T5.3 (G)
unnamed: JP7.1, RN2.2 (1), T6.3 (G)
unnamed: JP8.1, RN2.3 (1), T7.3 (G)
unnamed: JP9.1, RN2.4 (1), T8.3 (G)
unnamed: IC3.2 (X2), X2.1
unnamed: IC6.27 (LEDA), REA.1
unnamed: BAT1.P$2 (+), IC3.3 (VBAT)
unnamed: IC6.26 (LEDB), REB.1
unnamed: RD+.2, USB.D+
unnamed: CAP.1, IC6.1 (VCAP)
unnamed: CX1.1, IC6.24 (OSC2), X1.2
unnamed: CX2.1, IC6.23 (OSC1), X1.1
unnamed: RD-.2, RUSB.1, USB.D-
unnamed: IC7.1 (PB5(NRES)), ISP.5, SJ1.1
unnamed: C7.2, RN3.5 (2), RN3.6 (2)
unnamed: IC6.14 (RBIAS), RBS.2
QH*: EXTOUT.2, IC5.9 (QH*)
RD+: IC6.13 (TPIN+), RJ45.RD+, RN3.4 (1)
RD-: IC6.12 (TPIN-), RJ45.RD-, RN3.3 (1)
RESET: IC4.4 (RESET), IC6.10 (RESET), RN4.3 (1), SJ1.2
RXD: IC4.9 ((PCINT24/RXD0)PD0), P0.6
SCK: IC4.3 ((PCINT15/SCK)PB7), IC6.8 (SCK), IC7.7 (PB2(SCK/ADC1)), ISP.3, U1.5 (SCK)
SCL: IC3.6 (SCL), IC4.19 ((PCINT16/SCL)PC0), P0.10, RN4.1
SDA: IC3.5 (SDA), IC4.20 ((PCINT17/SDA)PC1), P0.11, RN4.2 (1)
TCT: C8.2, L2.1, RJ45.P4, RN3.7 (2), RN3.8 (2)
TD+: IC6.17 (TPOUT+), RJ45.TD+, RN3.2 (1)
TD-: IC6.16 (TPOUT-), RJ45.TD-, RN3.1
TXD: IC4.10 ((PCINT25/TXD0)PD1), P0.5
VCC: C3.+, C4.1, C6.1, C10.1, EXTOUT.1, IC2.4 (OUT), IC4.5 (VCC), IC4.17 (VCC), IC4.27 (AVCC), IC4.38 (VCC), IC5.10 (SCL), IC5.16 (VCC), IC6.15 (VDDTX), IC6.19 (VDDRX), IC6.20 (VDDPLL), IC6.25 (VDDOSC), IC6.28 (VDD), IC7.8 (VCC), L2.2, P0.12, P2.1, RN4.5 (2), RN4.6 (2), RPR.2, RUSB.2, U1.4 (VCC)
VIN: C9.1, D2.C, F1.2, IC2.3 (IN), IC3.8 (VCC), ISP.2, LCD.2 (VDD), LCD.15 (A), P0.13, P4.2, P5.1, RN4.7 (2), RN4.8 (2), USB.VBUS

Notes on the sheet:
Power Supply
Valve Driver
Data
Clock
Latch
DB4
330x4 Isolated ResNet
LCD Display
EN_ETHER
3.3V
DB7
LCD_E
LCD_RS
DB6
DB5
Ext. Board Portion
!OE
RAINSENSE
LCD_BKLIGHT
LCD_VO
SD_SEL

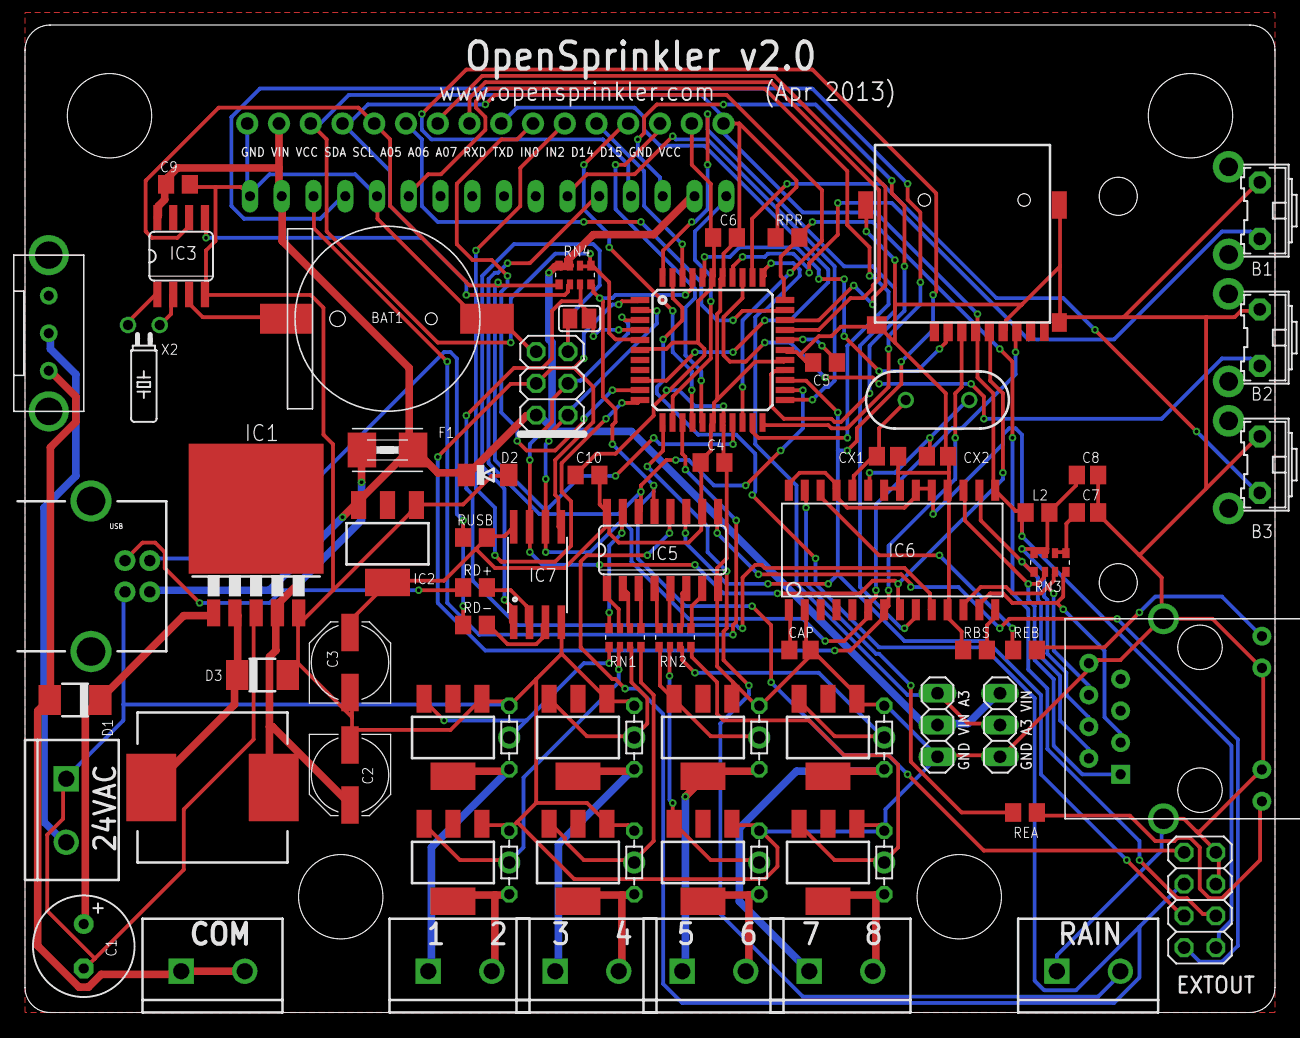
[picture p46: board os20.newenc.brd from above]

Board: 2 copper layers, 100.0 x 79.0 mm, 87 parts (0 on the bottom side), 89 nets.
