rayshobby/opensprinkler/OpenSprinkler Controller/hardware/v1.4/OpenSprinkler_v142.brd

## EAGLE design OpenSprinkler Controller/hardware/v1.4/OpenSprinkler_v142.brd (2013-04-10, an earlier design)

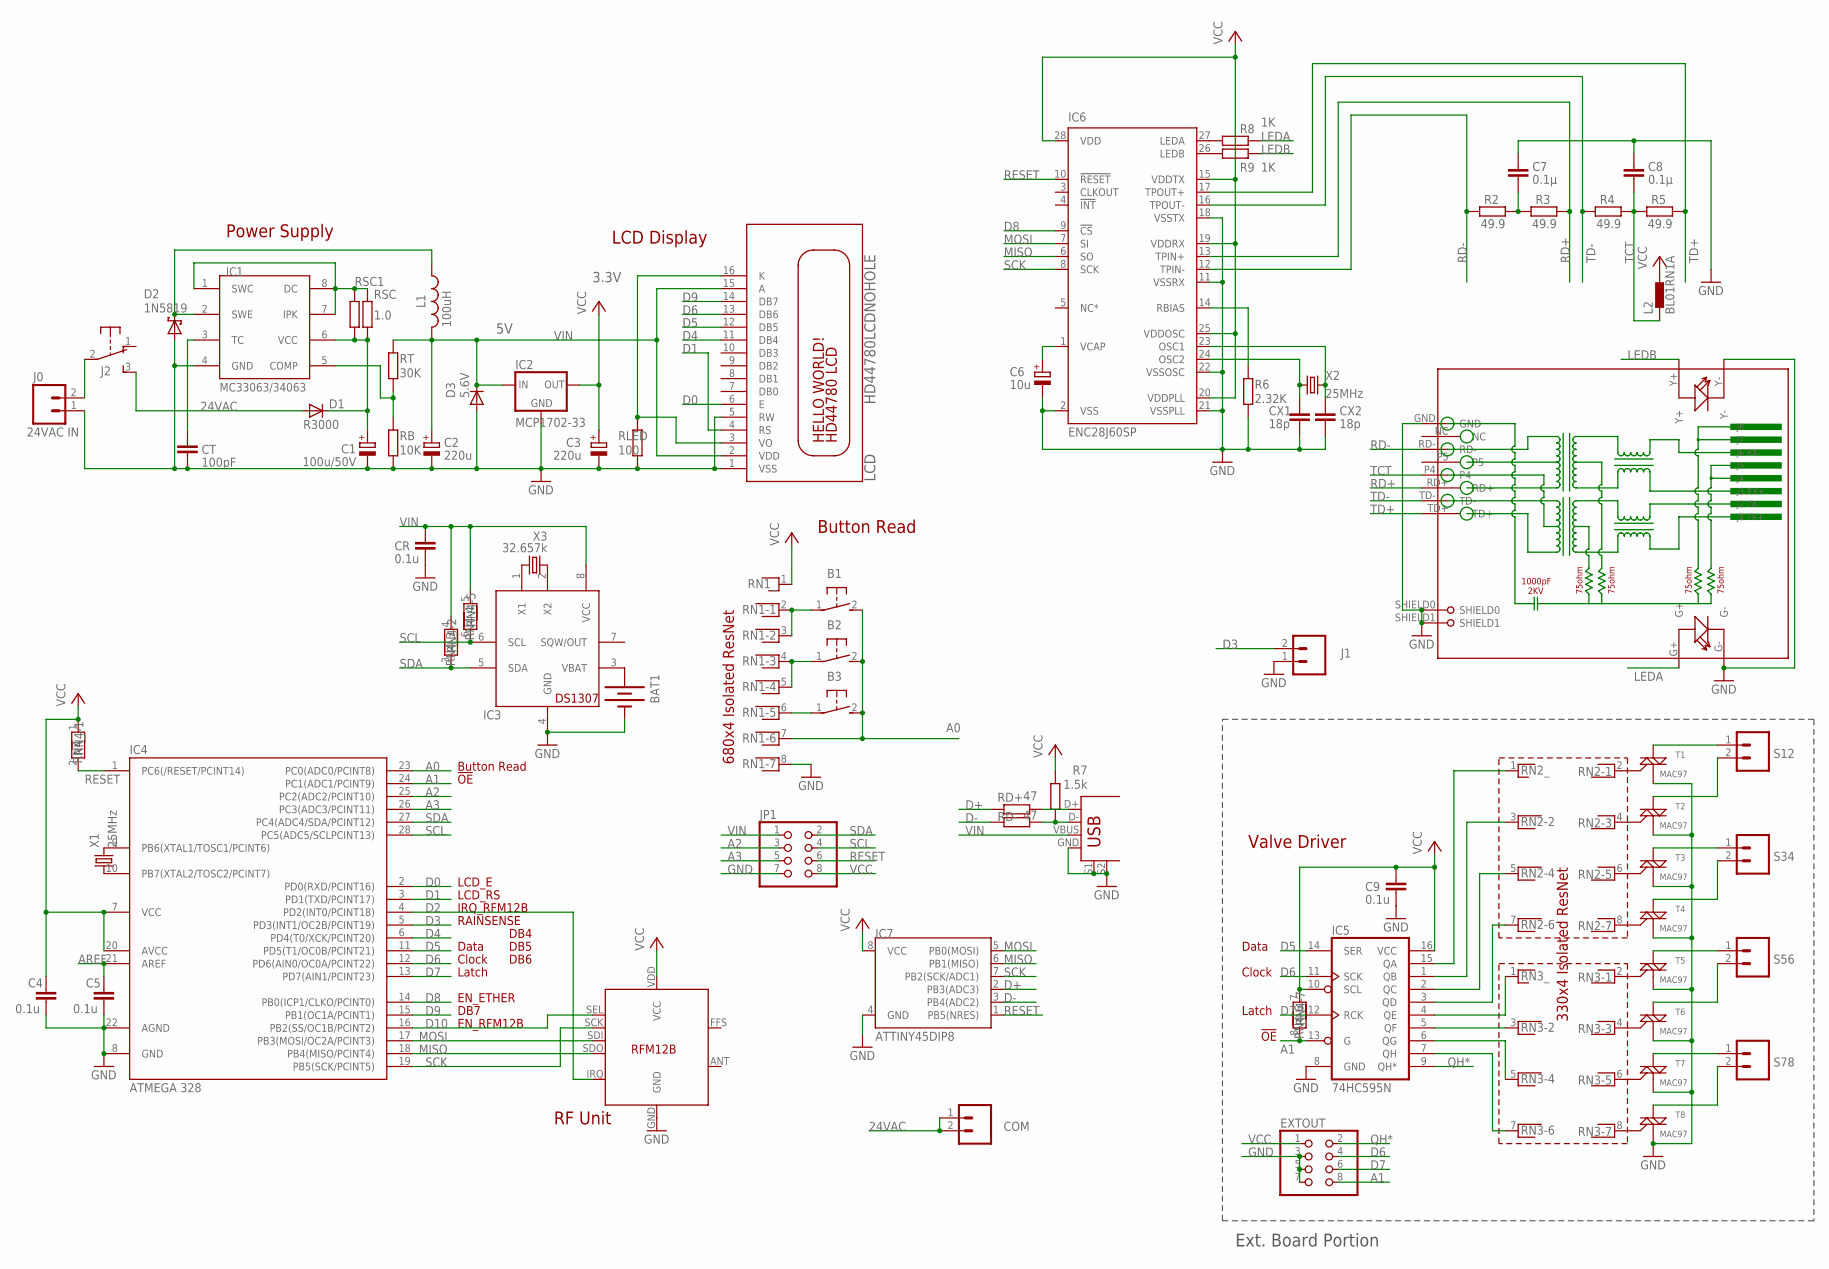
[picture p49: schematic OpenSprinkler_v142.sch]

Parts:
B1, B2, B3: 31-XX; B3F-31XX
BAT1: BATTERY12PTH; BATTCON_12MM_PTH
C1: 100u/50V; E3,5-8
C2, C3: 220u; E2-5
C4, C5, C9: 0.1u; C025-024X044
C6: 10u; E1,8-4
C7, C8: 0.1µ; C025-024X044
COM: M025MM; SCREWTERMINAL-5MM-2
CR: 0.1u; C025-024X044
CT: 100pF; C025-024X044
CX1, CX2: 18p; C025-024X044
D1: R3000; DO41-7.6
D2: 1N5819; DO41-7.6
D3: 5.6V; DO35-7
EXTOUT: PINHD-2X4; 2X04
IC1: MC33063/MC34063P; DIL08
IC2: MCP1702-33; TO92-INLINE
IC3: DS1307; DIL08
IC4: ATMEGA 328; DIL28-3
IC5: 74HC595N; DIL16
IC6: ENC28J60SP; DIL28-3
IC7: ATTINY45DIP8; DIP08
IC8: RFM12B
J0: 24VAC IN; SCREWTERMINAL-5MM-2
J1: M025MM; SCREWTERMINAL-5MM-2
J2: EG1206
JP1: PINHD-2X4; 2X04
L1: 100uH; 6000-XXXX-RC
L2: BL01RN1A
LCD: HD44780LCDNOHOLE; LCD1602A
R2, R3, R4, R5: 49.9; 0204/7
R6: 2.32K; 0204/7
R7: 1.5k; 0204/7
R8, R9: 1K; 0204/7
RB: 10K; 0204/7
RD+: 47; 0204/7
RD-: 47; 0204/7
RJ1: HR911105A
RLED: 100; 0204/7
RN1, RN2, RN3, RN4: RNX7; RN-8
RSC, RSC1: 1.0; 0204/7
RT: 30K; 0204/7
S12, S34, S56, S78: M025MM; SCREWTERMINAL-5MM-2
T1, T2, T3, T4, T5, T6, T7, T8: MAC97; TO-92
USB: USB+SHIELD; USB-B-PTH
X1, X2: 25MHz; HC49US
X3: 32.657k; TC26H

Connections:
24VAC: COM.1, COM.2, D1.A, J2.3 (S)
A0: B1.2 (S), B2.2 (S), B3.2 (S), IC4.23 (PC0(ADC0/PCINT8)), RN1.7
A1: EXTOUT.8, IC4.24 (PC1(ADC1/PCINT9)), IC5.13 (G), RN4.8
A2: IC4.25 (PC2(ADC2/PCINT10)), JP1.3
A3: IC4.26 (PC3(ADC3/PCINT11)), JP1.5
AREF: C5.1, IC4.21 (AREF)
D0: IC4.2 (PD0(RXD/PCINT16)), LCD.6 (E)
D1: IC4.3 (PD1(TXD/PCINT17)), LCD.4 (RS)
D2: IC4.4 (PD2(INT0/PCINT18)), IC8.IRQ
D3: IC4.5 (PD3(INT1/OC2B/PCINT19)), J1.2
D4: IC4.6 (PD4(T0/XCK/PCINT20)), LCD.11 (DB4)
D5: IC4.11 (PD5(T1/OC0B/PCINT21)), IC5.14 (SER), LCD.12 (DB5)
D6: EXTOUT.4, IC4.12 (PD6(AIN0/OC0A/PCINT22)), IC5.11 (SCK), LCD.13 (DB6)
D7: EXTOUT.6, IC4.13 (PD7(AIN1/PCINT23)), IC5.12 (RCK)
D8: IC4.14 (PB0(ICP1/CLKO/PCINT0)), IC6.9 (!CS)
D9: IC4.15 (PB1(OC1A/PCINT1)), LCD.14 (DB7)
D10: IC4.16 (PB2(SS/OC1B/PCINT2)), IC8.SEL
D+: IC7.2 (PB3(ADC3)), RD+.1
D-: IC7.3 (PB4(ADC2)), RD-.1
GND: BAT1.GND (-), C1.-, C2.-, C3.-, C4.2, C5.2, C6.-, C7.1, C8.1, C9.2, CR.2, CT.2, CX1.2, CX2.2, D2.A, D3.A, EXTOUT.3, EXTOUT.5, EXTOUT.7, IC1.4 (GND), IC2.1 (GND), IC3.4 (GND), IC4.8 (GND), IC4.22 (AGND), IC5.8 (GND), IC6.2 (VSS), IC6.11 (VSSRX), IC6.18 (VSSTX), IC6.21 (VSSPLL), IC6.22 (VSSOSC), IC7.4 (GND), IC8.GND, J0.1, J1.1, JP1.7, LCD.1 (VSS), LCD.5 (RW), R6.2, RB.2, RJ1.G-, RJ1.GND, RJ1.SHIELD0, RJ1.SHIELD1, RJ1.Y-, RLED.2, RN1.8, T1.1 (M1), T2.1 (M1), T3.1 (M1), T4.1 (M1), T5.1 (M1), T6.1 (M1), T7.1 (M1), T8.1 (M1), USB.GND, USB.S1, USB.S2
LEDA: R8.2, RJ1.G+
LEDB: R9.2, RJ1.Y+
MISO: IC4.18 (PB4(MISO/PCINT4)), IC6.6 (SO), IC7.6 (PB1(MISO)), IC8.SDO
MOSI: IC4.17 (PB3(MOSI/OC2A/PCINT3)), IC6.7 (SI), IC7.5 (PB0(MOSI)), IC8.SDI
unnamed: IC4.9 (PB6(XTAL1/TOSC1/PCINT6)), X1.2
unnamed: RN2.2, T1.2 (G)
unnamed: IC5.5 (QF), RN3.3
unnamed: IC5.6 (QG), RN3.5
unnamed: J0.2, J2.2
unnamed: IC5.7 (QH), RN3.7
unnamed: IC4.10 (PB7(XTAL2/TOSC2/PCINT7)), X1.1
unnamed: C1.+, D1.C, IC1.6 (VCC), RSC.2, RSC1.2
unnamed: IC5.4 (QE), RN3.1
unnamed: IC5.3 (QD), RN2.7
unnamed: IC5.2 (QC), RN2.5
unnamed: IC5.1 (QB), RN2.3
unnamed: IC5.15 (QA), RN2.1
unnamed: RN2.4, T2.2 (G)
unnamed: S12.1, T1.3 (M2)
unnamed: S12.2, T2.3 (M2)
unnamed: S34.1, T3.3 (M2)
unnamed: RN2.6, T3.2 (G)
unnamed: S34.2, T4.3 (M2)
unnamed: RN2.8, T4.2 (G)
unnamed: S56.1, T5.3 (M2)
unnamed: S56.2, T6.3 (M2)
unnamed: S78.1, T7.3 (M2)
unnamed: S78.2, T8.3 (M2)
unnamed: RN3.2, T5.2 (G)
unnamed: RN3.4, T6.2 (G)
unnamed: RN3.6, T7.2 (G)
unnamed: RN3.8, T8.2 (G)
unnamed: B1.1, RN1.2, RN1.3
unnamed: B3.1, RN1.6
unnamed: B2.1, RN1.4, RN1.5
unnamed: BAT1.VCC@1 (+), IC3.3 (VBAT)
unnamed: IC6.27 (LEDA), R8.1
unnamed: RD+.2, USB.D+
unnamed: IC6.26 (LEDB), R9.1
unnamed: IC1.1 (SWC), IC1.7 (IPK), IC1.8 (DC), RSC.1, RSC1.1
unnamed: R7.1, RD-.2, USB.D-
unnamed: D2.C, IC1.2 (SWE), L1.1
unnamed: IC3.2 (X2), X3.2
unnamed: LCD.3 (VO), LCD.16 (K), RLED.1
unnamed: CT.1, IC1.3 (TC)
unnamed: C6.+, IC6.1 (VCAP)
unnamed: IC6.14 (RBIAS), R6.1
unnamed: CX1.1, IC6.24 (OSC2), X2.1
unnamed: CX2.1, IC6.23 (OSC1), X2.2
unnamed: C7.2, R2.2, R3.1
unnamed: IC1.5 (COMP), RB.1, RT.2
unnamed: IC3.1 (X1), X3.1
QH*: EXTOUT.2, IC5.9 (QH*)
RD+: IC6.13 (TPIN+), R3.2, RJ1.RD+
RD-: IC6.12 (TPIN-), R2.1, RJ1.RD-
RESET: IC4.1 (PC6(/RESET/PCINT14)), IC6.10 (!RESET), IC7.1 (PB5(NRES)), JP1.6, RN4.2
SCK: IC4.19 (PB5(SCK/PCINT5)), IC6.8 (SCK), IC7.7 (PB2(SCK/ADC1)), IC8.SCK
SCL: IC3.6 (SCL), IC4.28 (PC5(ADC5/SCLPCINT13)), JP1.4, RN4.6
SDA: IC3.5 (SDA), IC4.27 (PC4(ADC4/SDA/PCINT12)), JP1.2, RN4.3
TCT: C8.2, L2.1, R4.2, R5.1, RJ1.P4
TD+: IC6.17 (TPOUT+), R5.2, RJ1.TD+
TD-: IC6.16 (TPOUT-), R4.1, RJ1.TD-
VCC: C3.+, C4.1, C9.1, EXTOUT.1, IC2.3 (OUT), IC4.7 (VCC), IC4.20 (AVCC), IC5.10 (SCL), IC5.16 (VCC), IC6.15 (VDDTX), IC6.19 (VDDRX), IC6.20 (VDDPLL), IC6.25 (VDDOSC), IC6.28 (VDD), IC7.8 (VCC), IC8.VDD (VCC), JP1.8, L2.2, R7.2, RN1.1, RN4.1, RN4.7
VIN: C2.+, CR.1, D3.C, IC2.2 (IN), IC3.8 (VCC), JP1.1, L1.2, LCD.2 (VDD), LCD.15 (A), RN4.4, RN4.5, RT.1, USB.VBUS

Notes on the sheet:
Power Supply
Button Read
Valve Driver
Data
Clock
Latch
DB4
680x4 Isolated ResNet
330x4 Isolated ResNet
LCD Display
RF Unit
IRQ_RFM12B
EN_RFM12B
EN_ETHER
3.3V
DB7
LCD_E
LCD_RS
DB6
DB5
Ext. Board Portion
!OE
RAINSENSE

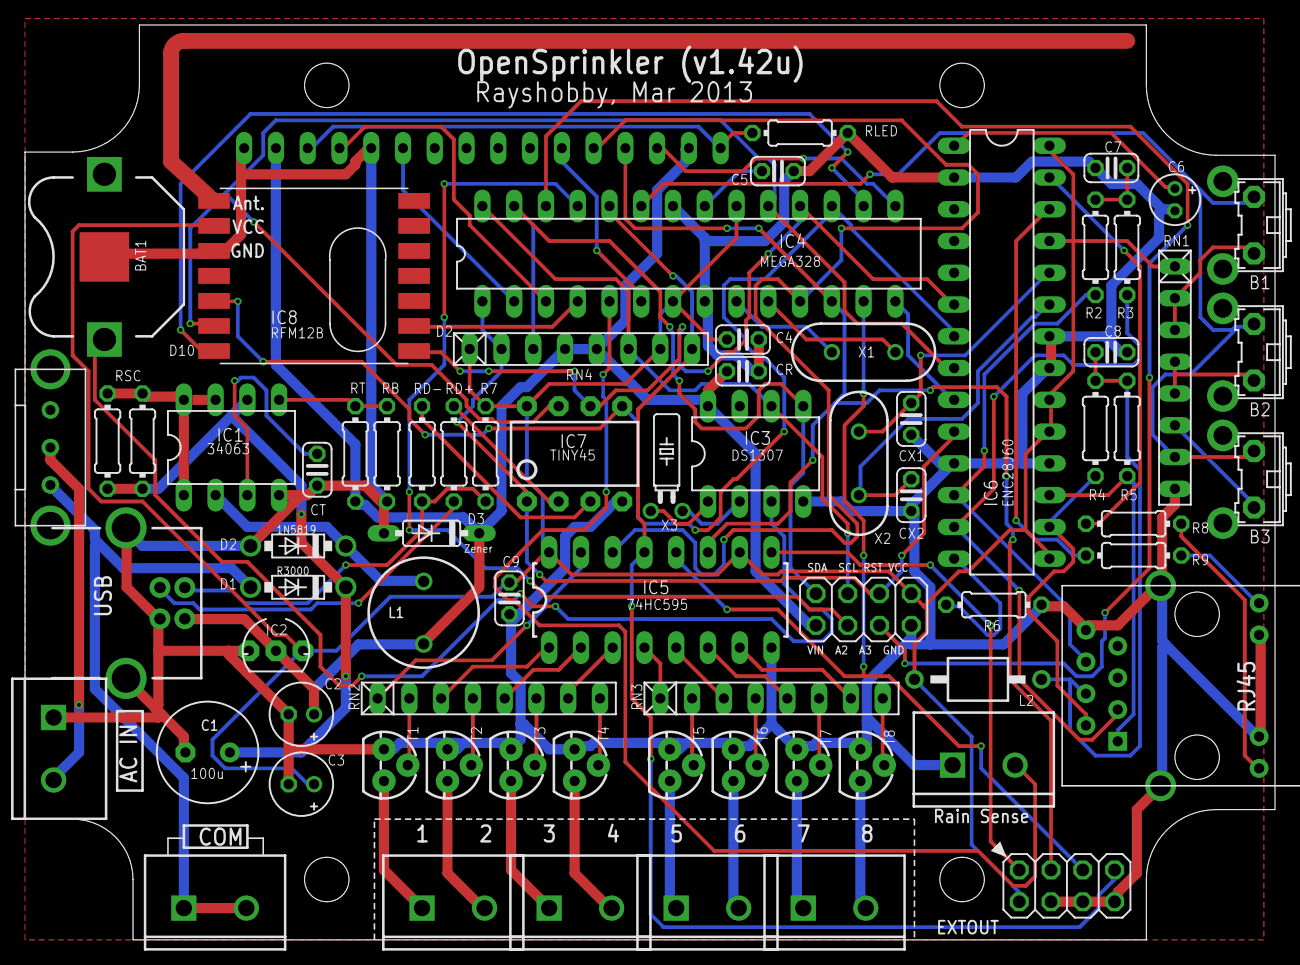
[picture p50: board OpenSprinkler_v142.brd from above]

Board: 2 copper layers, 99.9 x 73.2 mm, 73 parts (0 on the bottom side), 84 nets.
