rayshobby/opensprinkler/OpenSprinkler Pi/hardware/ospi_v10.brd

## EAGLE design OpenSprinkler Pi/hardware/ospi_v10.brd (2013-03-09, an earlier design)

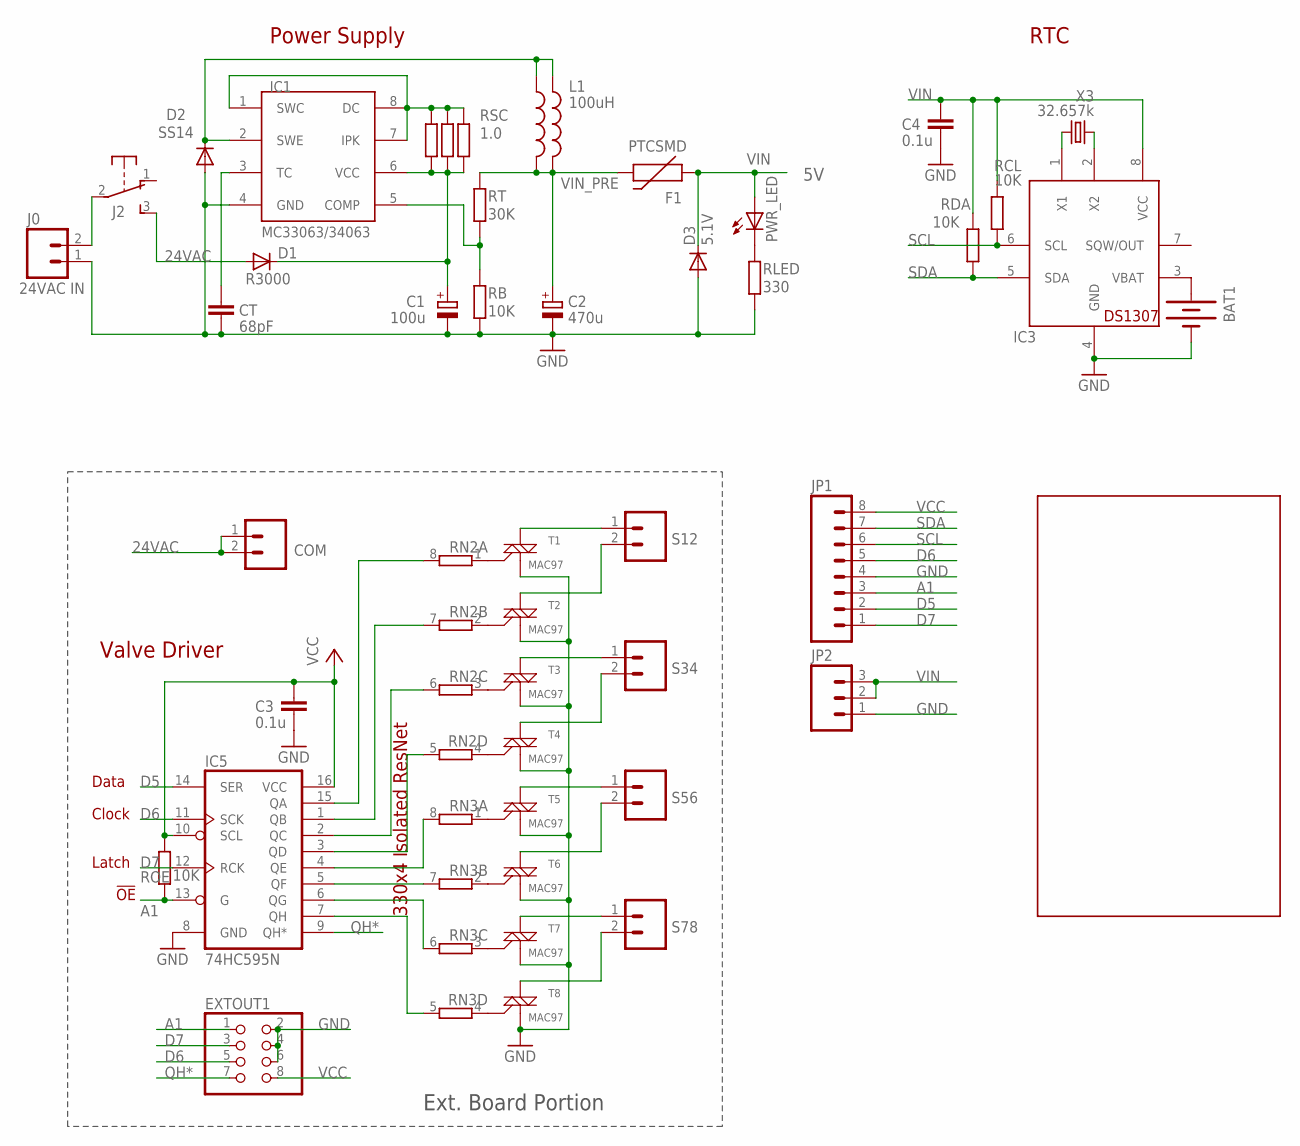
[picture p51: schematic ospi_v10.sch]

Parts:
BAT1: BATTERYBATTERY_12MM_SMT; BATTCON_12MM_SMT
C1: 100u; E3,5-8
C2: 470u; E3,5-8
C3, C4: 0.1u; C0805
COM: M025MM; SCREWTERMINAL-5MM-2
CT: 68pF; C0805
D1: R3000; DO41-7.6
D2: SS14; DO-214AC
D3: 5.1V; DO34-7
EXTOUT1: PINHD-2X4/90; 2X04/90
F1: PTCSMD; PTC-1206
IC1: MC33063/MC34063D; SO08
IC3: DS1307; SO08
IC5: 74HC595N; SO16
J0: 24VAC IN; SCREWTERMINAL-5MM-2
J2: EG1206
JP1: M08LOCK; 1X08_LOCK
JP2: M03LOCK; 1X03_LOCK
L1: 100uH; SRU1038
L1': 220uH; 6000-XXXX-RC
PWR_LED: LEDCHIPLED_0805; CHIPLED_0805
RB: 10K; R0805
RCL: 10K; R0805
RDA: 10K; R0805
RLED: 330; R0805
RN2, RN3: 4R-NEXB38V; EXB38V
ROE: 10K; R0805
RSC, RSC1, RSC2: 1.0; R0805
RT: 30K; R0805
S12, S34, S56, S78: M025MM; SCREWTERMINAL-5MM-2
T1, T2, T3, T4, T5, T6, T7, T8: MAC97; SOT223
U$2: OSPI
X3: 32.657k; TC26H

Connections:
24VAC: COM.1, COM.2, D1.A, J2.3 (S)
A1: EXTOUT1.1, IC5.13 (G), JP1.3, ROE.1
D5: IC5.14 (SER), JP1.2
D6: EXTOUT1.5, IC5.11 (SCK), JP1.5
D7: EXTOUT1.3, IC5.12 (RCK), JP1.1
GND: BAT1.P$1 (-), C1.-, C2.-, C3.2, C4.2, CT.2, D2.A, D3.A, EXTOUT1.2, EXTOUT1.4, EXTOUT1.6, IC1.4 (GND), IC3.4 (GND), IC5.8 (GND), J0.1, JP1.4, JP2.1, RB.2, RLED.2, T1.1 (M1), T2.1 (M1), T3.1 (M1), T4.1 (M1), T5.1 (M1), T6.1 (M1), T7.1 (M1), T8.1 (M1)
unnamed: PWR_LED.C, RLED.1
unnamed: C1.+, D1.C, IC1.6 (VCC), RSC.2, RSC1.2, RSC2.2
unnamed: RN2.1, T1.3 (G)
unnamed: IC5.5 (QF), RN3.7 (2)
unnamed: IC5.6 (QG), RN3.6 (2)
unnamed: J0.2, J2.2
unnamed: IC5.7 (QH), RN3.5 (2)
unnamed: IC5.4 (QE), RN3.8 (2)
unnamed: IC5.3 (QD), RN2.5 (2)
unnamed: IC5.2 (QC), RN2.6 (2)
unnamed: IC5.1 (QB), RN2.7 (2)
unnamed: IC5.15 (QA), RN2.8 (2)
unnamed: RN2.2 (1), T2.3 (G)
unnamed: S12.1, T1.4 (M2)
unnamed: S12.2, T2.4 (M2)
unnamed: S34.1, T3.4 (M2)
unnamed: RN2.3 (1), T3.3 (G)
unnamed: S34.2, T4.4 (M2)
unnamed: RN2.4 (1), T4.3 (G)
unnamed: S56.1, T5.4 (M2)
unnamed: S56.2, T6.4 (M2)
unnamed: S78.1, T7.4 (M2)
unnamed: S78.2, T8.4 (M2)
unnamed: RN3.1, T5.3 (G)
unnamed: RN3.2 (1), T6.3 (G)
unnamed: RN3.3 (1), T7.3 (G)
unnamed: RN3.4 (1), T8.3 (G)
unnamed: BAT1.P$2 (+), IC3.3 (VBAT)
unnamed: IC1.1 (SWC), IC1.7 (IPK), IC1.8 (DC), RSC.1, RSC1.1, RSC2.1
unnamed: D2.C, IC1.2 (SWE), L1.1, L1'.1
unnamed: IC3.1 (X1), X3.1
unnamed: CT.1, IC1.3 (TC)
unnamed: IC3.2 (X2), X3.2
unnamed: IC1.5 (COMP), RB.1, RT.2
QH*: EXTOUT1.7, IC5.9 (QH*)
SCL: IC3.6 (SCL), JP1.6, RCL.2
SDA: IC3.5 (SDA), JP1.7, RDA.2
VCC: C3.1, EXTOUT1.8, IC5.10 (SCL), IC5.16 (VCC), JP1.8, ROE.2
VIN: C4.1, D3.C, F1.1, IC3.8 (VCC), JP2.2, JP2.3, PWR_LED.A, RCL.1, RDA.1
VIN_PRE: C2.+, F1.2, L1.2, L1'.2, RT.1

Notes on the sheet:
Power Supply
Valve Driver
Data
Clock
Latch
330x4 Isolated ResNet
Ext. Board Portion
!OE
RTC

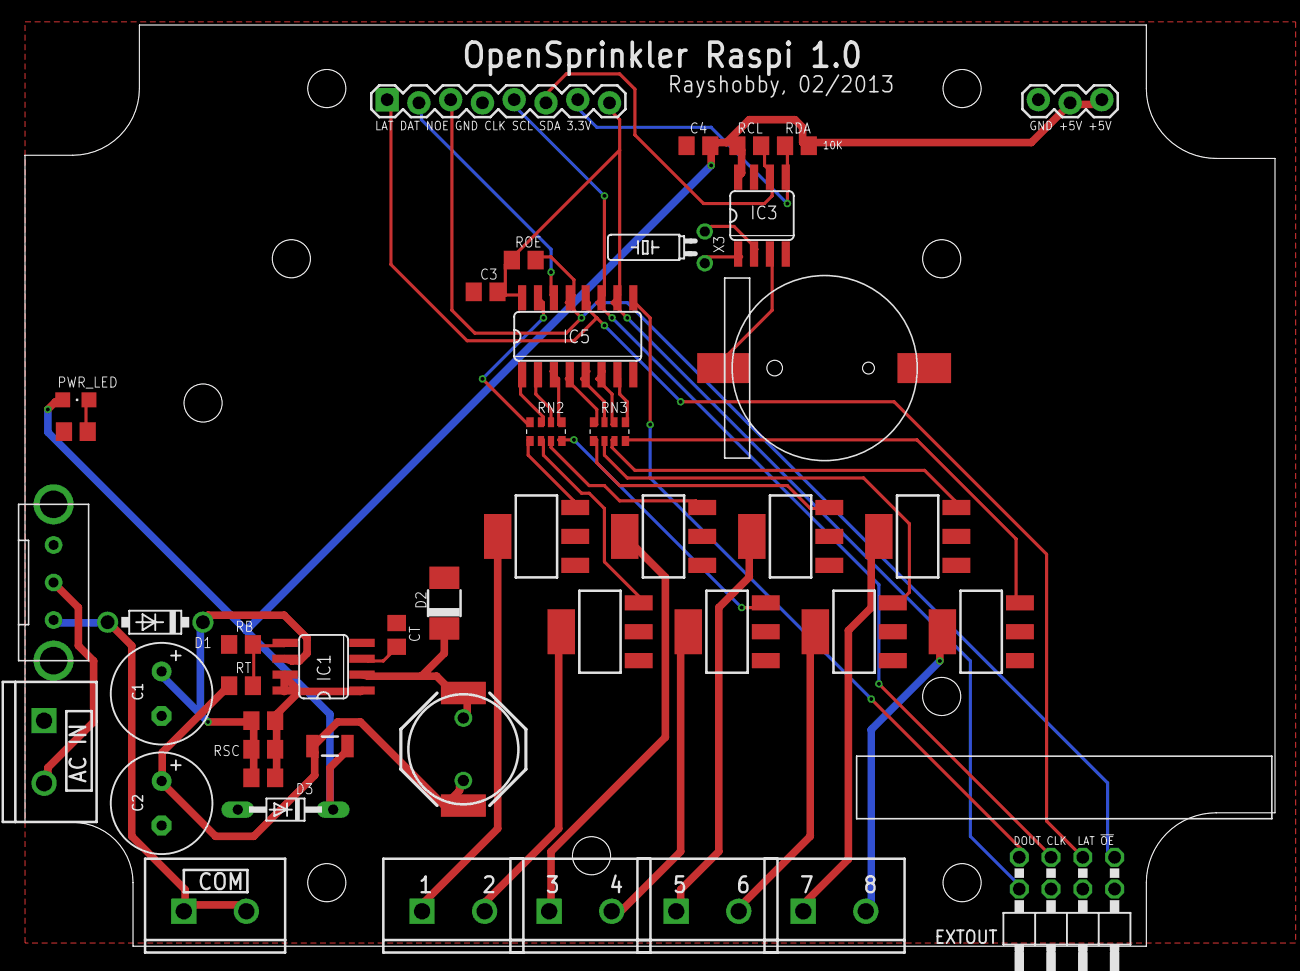
[picture p52: board ospi_v10.brd from above]

Board: 2 copper layers, 99.9 x 73.7 mm, 47 parts (0 on the bottom side), 46 nets.
