rayshobby/opensprinkler/(commit log)

2011-12-22 version 1.2, fixed issue with changing number of slots per hour
    [defines.h, server.pde, svc.pde, svc_demo.pde]
2011-12-28 fixed missing static qualifier; added svc_simple_web program
    [defines.h, server.pde, svc.pde, svc_simple_web.pde]
2011-12-28 fixed a bug that causes firefox to display the webpage incorrectly.
    [server.pde]
2012-03-21 support for potentialyl any number of ext. boards.
2012-03-21 added hardware update v1.1 (minor updates)
    [OpenSprinkler_v1.1.brd, OpenSprinkler_v1.1.sch]
2012-03-25 added OpenSprinkler Arduino library
2012-03-25 added svc_button_ctrl (replaces the previous svc_simple_web program)
    [server.pde, svc_button_ctrl.pde]
2012-03-25 added back missing file.
    [svc.pde]
2012-03-26 added svc_full_schedule program (replaces the previous svc_demo program
    [server.pde, svc_full_schedule.pde]
2012-05-12 prepare hardware update v1.2u (minor update)
    [OpenSprinkler_v12.brd, OpenSprinkler_v12.sch]
2012-05-13 update component values
    [OpenSprinkler_v12.brd, OpenSprinkler_v12.sch]
2012-05-17 updated OpenSprinkler library with new Wire library, added hardwre definition macro. Moved programs into the 'examples' folder
2012-05-25 update README.txt and add Arduino boards.txt
2012-05-26 fixed mcu type in boards.txt
2012-06-26 check in v1.3u design files, README, pin defines.
    [OpenSprinkler_v13.brd, OpenSprinkler_v13.sch]
2012-08-15 checked in hardware design v1.4 (main changes are added DS1307 RTC, and a smt variant); software update fw1.7 initial check in (main changes are two added options, support for RTC, several fixes to i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
    [OpenSprinkler_v14.brd, OpenSprinkler_v14.sch, OpenSprinkler_v14_smt.brd, OpenSprinkler_v14_smt.sch]
2012-09-16 update compiled firmware. fix button issue in setup options
2013-02-10 check in firmware 1.8.3. main chnages are 1) added back support for concurrent running mode; 2) new 'device_id' option which allows modifying the last byte of the controller's mac address.
2013-02-18 check in OSPi hardware design and software demos
    [ospi_v10.brd, ospi_v10.sch]
2013-03-09 fix component values
    [ospi_v10.brd, ospi_v10.sch]
2013-03-14 add fix to GPIO defines for RPi rev.2
    [ospi_gc.py, ospi_manual.py]
2013-04-10 check in v1.42u hardware design files
    [OpenSprinkler_v142.brd, OpenSprinkler_v142.sch]
2013-04-28 check in OpenSprinkler 2.0 (SMT version) hardware design files
    [os20.newenc.brd, os20.newenc.sch, os20.oldenc.brd, os20.oldenc.sch]
2013-05-25 check in interval_program for OSPi written by Dan
    [water_log.csv]
2013-06-09 add OSPi v1.1 Eagle files
    [ospi_v11.brd, ospi_v11.sch]
2013-06-16 updated scripts from Dan. removed the unzipped folder
    [water_log.csv]
2013-06-18 check in OpenSprinkler 2.0 Arduino code
2013-06-19 apply Samer's patch to OSPi interval program
    [water_log.csv]
2013-06-19 change folder name
    [water_log.csv]
2013-06-23 check in Dan's code (Jun 22, 2013 update)
    [water_log.csv]
2013-06-27 update Jun 26, 2013
    [water_log.csv]
2013-07-07 add back the source folder for OSPi interval_program
    [water_log.csv]
2013-07-08 check in OSPi v1.2 hardware design files and update README.txt
    [ospi_v12.brd, ospi_v12.sch]
2013-10-17 Moved current OSPi program to archive folder. The most recent version of OSPi's interval program is now hosted at Dan's Github page, and no longer maintained at Rayshobby Github page.
    [water_log.csv]
2014-02-11 update Arduino delay function to incorporate 12MHz clock speed
2014-02-24 check in hardware v2.1 hardware design files
    [os21_diy.brd, os21_diy.sch, os21_smt.brd, os21_smt.sch]
2014-04-06 check in OSPi v1.3 hardware design files
    [ospi_v13.brd, ospi_v13.sch]
2014-06-09 check in expansion board 2.0 hardware files
    [exp20.brd, exp20.sch]
2014-08-25 Check in firmware 2.0.8 source code. This firmware adds support for relay, logging rain sensor / rain delay status. The default UI has been changed to Samer's mobile UI
2014-09-26 check in new Qt-based firmware updater source code. Remove Processing-based one
    [config.txt]
2014-10-22 check in firmware 2.1.0 Arduino code. for intermediate changes, please check the development thread at https://github.com/OpenSprinkler/OpenSprinklerGen2
2014-10-26 add OSPi 1.4 and 1.4 B+ hardware design files
    [ospi_v14+.brd, ospi_v14+.sch, ospi_v14.brd, ospi_v14.sch]
2014-10-27 add OpenSprinkler 2.2 board profile
2014-10-28 add OSDIY 2.2 hardware files and update notes
    [os22_diy.brd, os22_diy.sch]
2014-12-03 check in firmware 2.1.1 source code. update release notes
    [config.txt]
2014-12-05 add hardware design files for OS 2.2 DIY Nov 14 revision, and OS 2.2s
    [os22_rev_diy.brd, os22_rev_diy.sch, os22s.brd, os22s.sch]
2015-02-04 made significant changes to stock google calendar demo, including - add support for google api v3 - pull common config items from environment variables (can be set in /etc/default/ospi_gc if running 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
    [ospi_gc.py]
2015-03-18 add OpenSprinkler 2.3 profile to Arduino boards.txt
2015-08-03 add OS 2.3 AC and DC hardware design files
    [os23ac.brd, os23ac.sch, os23dc.brd, os23dc.sch]
2015-08-03 correct some component values
    [os23dc.brd, os23dc.sch]
2015-08-12 check in v1.42+ EagleCAD files
    [ospi_v142+.brd, ospi_v142+.sch]
2016-11-06 move older versions to archive folder
    [ospi_v10.brd, ospi_v10.sch, ospi_v11.brd, ospi_v11.sch, ospi_v12.brd, ospi_v12.sch, ospi_v13.brd, ospi_v13.sch]
2016-11-06 again, move older versions to archive folder
    [ospi_v14+.brd, ospi_v14+.sch, ospi_v142+.brd, ospi_v142+.sch]
2016-11-06 add new version ospi_v143+, with laser cut enclosure design
    [ospi_v14.brd, ospi_v14.sch, ospi_v143+.brd, ospi_v143+.sch]
2016-11-06 add enclosure design .ai file, modify README.txt
