rayshobby/opensprinkler/(notices)

Notices in the files:
OpenSprinkler Controller/software/arduino-code/hardware/aopensprinkler/cores/arduino/wiring_analog.c:
Public License along with this library; if not, write to the
Free Software Foundation, Inc., 59 Temple Place, Suite 330,
Boston, MA 02111-1307 USA
OpenSprinkler Controller/software/vusbtiny/main.c:
modify it under the terms of the GNU General Public License
parts and their libraries:
SparkFunNew: Licensing: CC v3.0 Share-Alike You are welcome to use this library for commercial purposes.
